wuxx/icesugar/doc/iCESugar_render.jpg

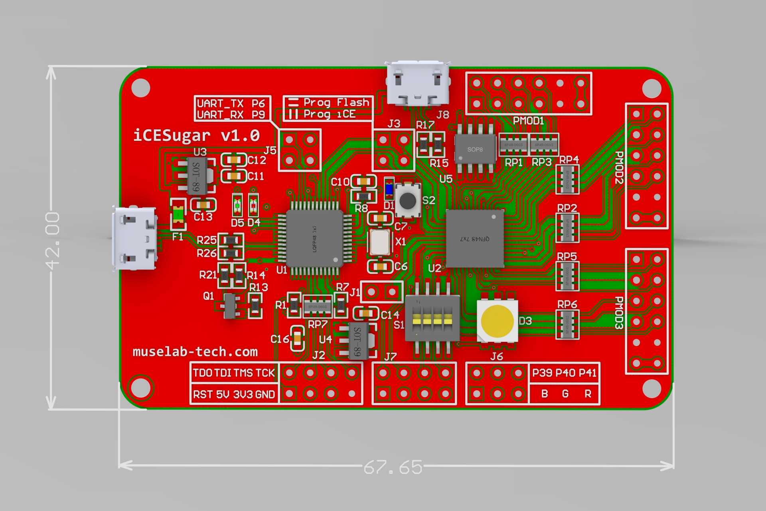
doc/iCESugar_render.jpg
