wuxx/icesugar/doc/icicle.png

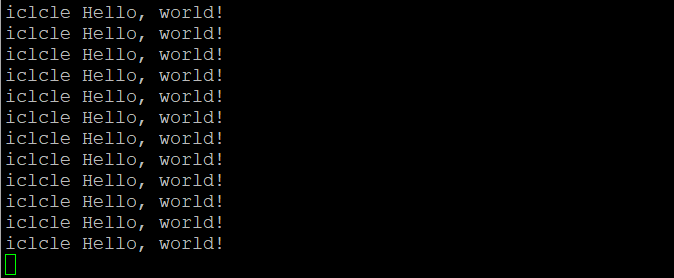
doc/icicle.png
