wuxx/icesugar/doc/litex-lm32-gateware.png

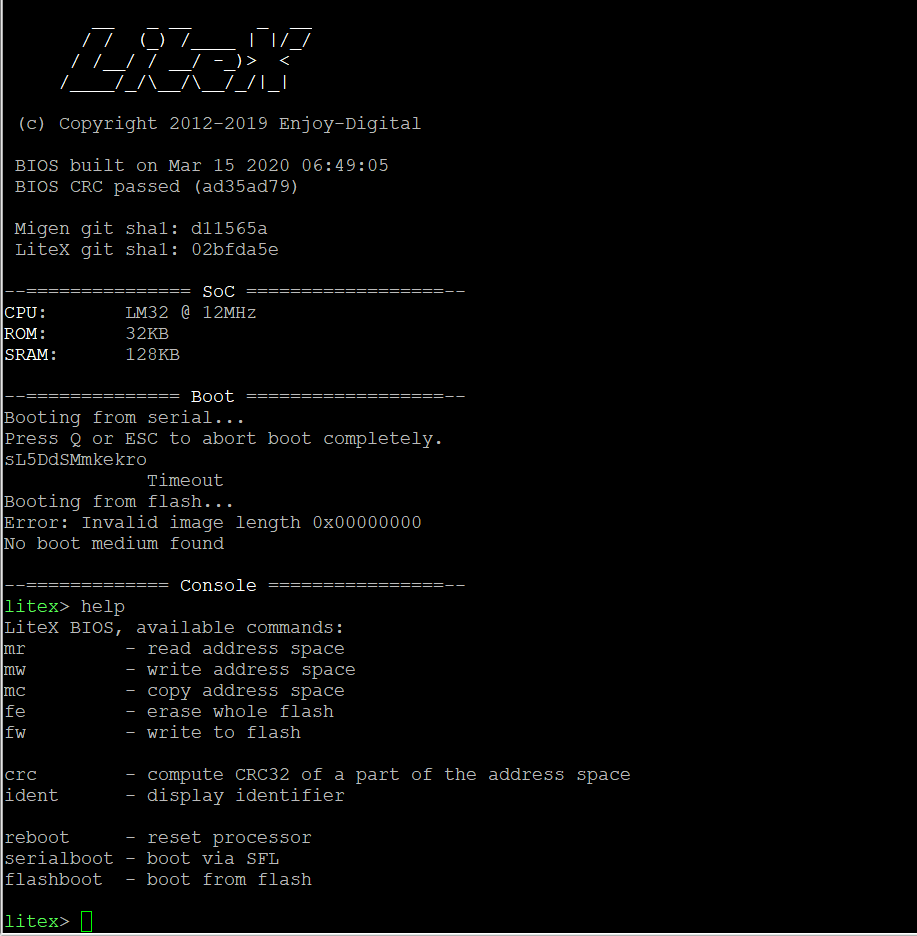
doc/litex-lm32-gateware.png
