wuxx/icesugar/doc/litex-lm32-micropython.png

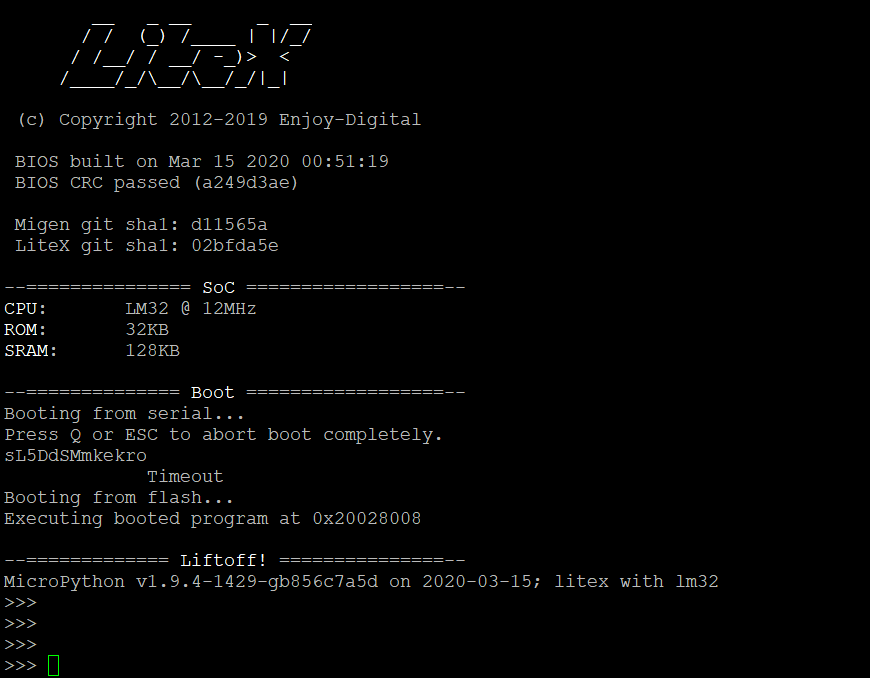
doc/litex-lm32-micropython.png
