wuxx/icesugar/doc/picosoc.png

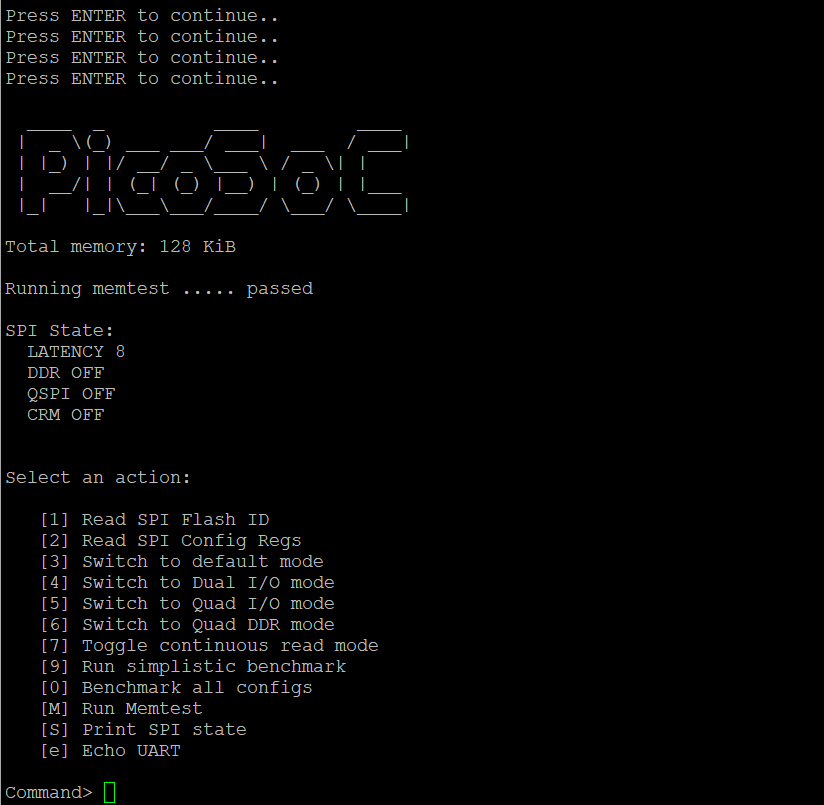
doc/picosoc.png
