wuxx/icesugar/doc/up5k_6502.jpg

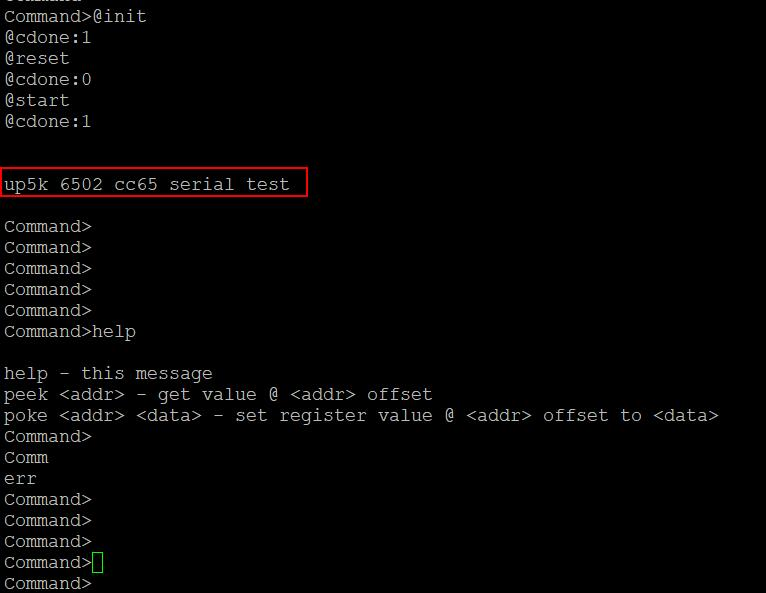
doc/up5k_6502.jpg
