wuxx/icesugar/src/basic/verilog/pmodoled2/fonts/oddball.png

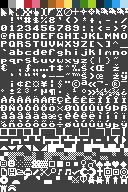
src/basic/verilog/pmodoled2/fonts/oddball.png
