wuxx/icesugar/(threads)

Thread 1 (2020-06-22):

请增加tftlcd的例子

zeaphoo, 2020-06-22:
demo 中有一个MuraxSoC_pmod_tftlcd的例子，可以跑。但是没有源代码。
希望能提供lcd相关例子和代码。

wuxx, 2020-06-22:
硬件源码在src/advanced/VexRiscv下
软件源码在https://github.com/wuxx/VexRiscvSocSoftware/tree/master/projects/murax/spi
具体运行请参考
https://zhuanlan.zhihu.com/p/133913104

zeaphoo, 2020-06-22:
那些代码是汇编和C的代码。这样也好吧。我本想看看有没有verilog的代码例子的。

wuxx, 2020-06-24:
后面会增加verilog的demo，请稍等

zeaphoo, 2020-06-24:
👍

wuxx, 2020-07-06:
已经增加硬件SPI的demo，是集成在SoC中的，可以参考学习
烧录demo/iceZ0mb1e_pmod_tftlcd.bin可进行测试。
源码： icesugar/src/advanced/iceZ0mb1e
编译方法：make firmware && make fpga && make flash

Closed 2020-07-07.

Thread 3 (2020-07-14):

any plan to support icestudio and apio?

jemisa, 2020-07-14:
It's' a visual editor for open FPGA boards, at https://github.com/FPGAwars/icestudio  (sample config for boards: https://github.com/FPGAwars/icestudio/tree/develop/app/resources/boards, need to create a folder and 3 config files, and generates pinout.json from pinout.pcf (I'm assuming src/common/io.pcf is the proper pinout  ) )

it relies on apio, a wrapper of other tools (
https://apiodoc.readthedocs.io/en/stable/source/contribute/support_new_board.html  explains how to add a board to apio

wuxx, 2020-07-15:
thanks for the advice, maybe support in future :)

jemisa, 2020-07-19:
Thanks.
I'm trying to do it myself.

I'm unclear on the difference between
icesprog leds.bin
and
cp leds.bin /media/mylogin/iCELink
Both do program

Can you explain what is the role of icesprog ?

wuxx, 2020-07-20:
there are two way to program, as you say, one is use icesprog, the other way is drag and drop, first one use usb hid to program. and the the latter use usb msc bulk to program.
drag and drop program speed is faster, because it use the usb bulk transfer.
and icesprog is multi-functional, it can probe/write/read the spi-flash.

jemisa, 2020-07-20:
Thank you for the answers.

Here is what I did to make it work for asio

STEP 1:
If you want to use icesprog,  put icesprog somehere in your path
add
 "icesprog": {                                                                                                                                     
     "command": "icesprog",                                                                                                                          
     "args": ""                                                                                                                                      
   },
to
apio/resources/programmers.json

if you prefer to use the usb method, you need to make a bash script and put in your path as icesugar-copy
#!/bin/bash
vars=( ` df | grep iCELink` )
ICELINK_DIR=${vars[5]}
cp "$1" "${ICELINK_DIR}"

but I found out that the directory is unmounted after one copy... so I prefer to use icesprog

STEP 2:
add
"icesugar-copy": {                                                                                                                                     
     "command": "icesugar-copy",                                                                                                                          
     "args": ""                                                                                                                                      
   },
to
apio/resources/programmers.json

then add
"icesugar": {                                                                                                                                     
     "name": "icesugar iCE40  by MuseLab",                                                                                                           
     "fpga": "iCE40-UP5K-SG48",                                                                                                                      
     "programmer": {                                                                                                                                 
       "type": "icesprog"                                                                                                                            
     },                                                                                                                                              
     "usb": {                                                                                                                                        
       "vid": "1d50",                                                                                                                                
       "pid": "602b"                                                                                                                                 
     }                                                                                                                                               
   }
to
apio/resources/boards.json
(if you prefer to use the icesugar-copy as programmer, change the "type" to be "icesugar-copy" (it should match the name in the programmers.json )

then install apio

to use:
cd src/basic/verilog/leds
cp the common/io.pcf in the current folder then
apio build --board icesugar
apio upload --board icesugar

aalku, 2020-10-11:
Thank you @jemisa
I made it work on Windows but don't know how to correctly prepare it to make it distributable and I didn't do the copy on Linux part yet.

My changes to apio are here
https://github.com/aalku/apio

And I created this issue in order to get help with it.
https://github.com/FPGAwars/apio/issues/214

Any help is welcome. This is a nice and cheap board and it would be nice to get it officially supported.

aalku, 2020-10-13:
Could you please release icesprog source or make a windows (libusbK?) binary so we can add it as apio programmer in a new toolchain?

the copy method does not support specifying an offset as far as I know.

wuxx, 2020-10-13:
yes, already commit under tools/src/

aalku, 2020-10-13:
Thank you! I'll try to create a windows binary with mingw. Wish me luck. 😂❤

aalku, 2020-10-13:
I had to make a couple of tiny changes but I made it work on windows.
I'm quite confident the c change is compatible with Linux but I don't know about hidapi-libusb being called just hidapi arround.

[icesprog-mingw64.zip](https://github.com/wuxx/icesugar/files/5373138/icesprog-mingw64.zip)

aalku, 2020-10-24:
@jemisa I've got apio toolchain here:
https://github.com/aalku/toolchain-icesprog/releases/tag/v1.0.0

apio fork supporting it here:
https://github.com/aalku/apio

I'm working with FPGAwars to include it on icestudio but I don't know when will it be working by default on nightly release or when the next stable release will be available. There are some steps ahead.

Obijuan, 2020-11-15:
The support of the icesugar in icestudio is almost finished! Thanks to @aalku  Here you can see an screenshot of a simple test circuit:

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

It is available in the develop branch. It is supported in Windows and Linux. The next step is add support for mac

jemisa, 2020-11-23:
https://mobile.twitter.com/Obijuan_cube/status/1330902188797939713 announces its support.
Thank @Obijuan and @aalku

Closed 2020-11-23.

Thread 4 (2020-07-19):

difference betwen icesprog and iceprog (from toolchain-ice40)

jemisa, 2020-07-19:
Hi

do you plan to publish the source code of icesprog ?

And can you explain what's the difference between icesprog and iceprog  from https://github.com/YosysHQ/icestorm/tree/master/iceprog ?

wuxx, 2020-07-20:
hello,
currently the source is closed, maybe opensource in future.
icesprog = icesugar prog
this difference is
iceprog use the ft2232 to program and icesprog use stm32f1 to program the spi-flash

Closed 2020-09-09.

Thread 5 (2020-07-22):

What's the relation with OpenFPGA-ICE ?

jemisa, 2020-07-22:
Hi
https://github.com/OpenFPGA-ICE looks quite similar to your github,
and uses the same icesprog.

How the 2 boards are related ?

wuxx, 2020-07-22:
hello, it seems that it's a another fpga board, it use ft2232hq to download (use the iceprog), the github repo seems just copy of my repo currently.

Closed 2020-09-09.

Thread 9 (2020-09-08):

Source code for ICELink

mamoit, 2020-09-08:
Is the source code for `ICELink` open?
I can find it anywhere.
If not, is it a "not yet", or no plans on open sourcing it?
It is a great tool, but I'm having some weird intermittent problems after dragging in a new program.

wuxx, 2020-09-09:
Hi，the souce code of iCELink will open in the future，and can you describe your problem in detail？

mamoit, 2020-12-14:
I am sorry for the radio silence, it was an issue with Kubuntu 18.04, that when the board reset the old mount was kept behind, making it quite messy after a couple of iterations.
With Kubuntu 20.04 this does not happen anymore, so I think the issue can be overlooked.

Did you release the iCELink source? Or you decided not to?
(not judging here, I understand completely if you opt by not releasing it)

wuxx, 2020-12-15:
iCELink source code currently has no open source plan, the firmware may be opened in future. :-)

camrbuss, 2020-12-31:
Is there any plan to add features such as adjustable ICELink clock output on PA8? Is it fixed at 12MHz?

wuxx, 2020-12-31:
the clock output will be able to adjust on iCESugar-nano board (base on ice40lp1k-cm36), because the lp1k-cm36 pll not support well by open source toolchain, current iCESugar seems not very necessary to have this feature ? it's pll can works well.
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

Closed 2020-12-14.

Thread 12 (2020-10-01):

UART access

aalku, 2020-10-01:
Hello. I am trying to use the RX and TX pins to communicate the computer with the FPGA but I see that pins are connected to iCElink UART3 and I'm not sure you can communicate with that UART through the USB-C or how to do it. Thank you.

wuxx, 2020-11-01:
when plug in PC, there is a USB CDC port, this CDC port is connected to pin-4 & pin-6 of FPGA

Closed 2020-11-01.

Thread 13 (2020-10-18):

1.5 schematic: Hard to see PMOD1 and UART are connected via J5

rvalles, 2020-10-18:
After some head-scratching, I realized the reason pin 4 seemed to be shorted high was that it's connected to STM32's UART TX via J5.

In the schematic, PMOD1 does clearly show how some of the pins are connected to the microusb port.

It would be better if it also shown that the relevant two pins are also connected to J5, in the same manner.

wuxx, 2020-12-15:
OK, Thanks for the good advice, later will update the schematic

WizardTim, 2021-09-07:
I agree, took me a few minutes to realize what was going on.

If there ends up being a V1.6 PCB it might be a good idea to highlight pins on the silkscreen that have multiple uses (USB, UART & J7/PMOD1 shared IO). Just using the invert option in Altium Designer should do the trick. Would suggest to users just starting out with it they should investigate PMOD1's IO further before using it.

Once I figured that out I loved using this dev board! The drag and drop programming is very convenient.

Thread 15 (2020-11-01):

The board is not working that keeps showing a "Fail.TXT"

ms0488638, 2020-11-01:
Hi, I just receive the board and try to use the demonstration bin file.

But every time I drag the bin file to the ICELINK in file explorer.

The board doesn't read the bin file, but showing a "FAIL.txt" file, which indicates the following lines:

error: The transfer timed out.
type: transient, user

What am I suppose to do?

wuxx, 2020-11-01:
Hello, did you change the short bridge, and which system you are in use?

wuxx, 2020-11-01:
and the default program in flash is the led blink, which ls flash by drag-n-drop before ship, can you see it ?

ms0488638, 2020-11-01:
> and the default program in flash is the led blink, which ls flash by drag-n-drop before ship, can you see it ?

Yap, the LED keeps blinking.

I am currently using the Windows 10 Professional Version.
I still am downloading the virtual environment from your link.

ms0488638, 2020-11-01:
> Hello, did you change the short bridge, and which system you are in use?

Should I modify any jumpers of the board?

wuxx, 2020-11-01:
no, just keep the default

wuxx, 2020-11-01:
and can you check the device manager to see if some driver is missing

ms0488638, 2020-11-01:
I just my linux laptop, and it can successfully upload.

Maybe I will check on my WIN10 desktop later, and find out which part went wrong.

wuxx, 2020-11-01:
OK

ms0488638, 2020-11-01:
I wonder if there is any available driver for the "iceLink" but the default one automatically installed by Windows?

wuxx, 2020-11-01:
there are 3 USB devices in iCELink, USB HID, USB CDC, and USB MSC, for win10 should no need to install any other drivers.

ms0488638, 2020-11-01:
This is weird, I've tried on 4 different computers.
Only my Linux laptop can successfully upload the bin file, while my windows computer may lead to Fail.txt.

Windows computer may occasionally success, but lead to fail.txt for most time.

If the bin file is successfully uploaded on windows computer, a explorer can show the transmission bar while the D4 and D5 LED can be observed blink.

wuxx, 2020-11-01:
eh... the factory led blink program was drag-n-drop with win10 too. can it may be the permission settings of you win10 ?
after program succ,  the iCELink disk will remount, you can see it displear and appear again some seconds later

wuxx, 2020-11-01:
and how you drag the bitstream ? I usually open the iCELink folder and drag the bitstream into the disk. or can use ctrl-c ctrl-v too.

ms0488638, 2020-11-01:
Hey, I think I found the reason.

After I change to another Type-C-to-USB-A, all issues are gone.

I guess something goes wrong with the attached one.

Problem might be fixed, thanks in advance.

wuxx, 2020-11-02:
ok

Closed 2020-11-02.

Thread 20 (2020-12-05):

icesprog is available in official MSYS2 repositories

umarcor, 2020-12-05:
During the last weeks, some PRs were proposed with regard to building and packaging icesprog (#16, #17, #18, #19).
I'm glad to tell that icesprog is now available in official MSYS2 repositories:

- https://github.com/msys2/MINGW-packages/tree/master/mingw-w64-icesprog
- https://packages.msys2.org/package/mingw-w64-i686-icesprog
- https://packages.msys2.org/package/mingw-w64-x86_64-icesprog

Therefore, users on Windows can install icesprog through `pacman -S mingw-w64-x86_64-icesprog` (64 bits) or `pacman -S mingw-w64-i686-icesprog` (32 bits); and they are ready to go!

```sh
user@DESKTOP MINGW64 /d/icesugar/demo
$ icesprog -w leds.bin
flash offset: 0x00000000
write flash (104090 (0x1969a) Bytes)
write 0x00000000
write 0x00010000
done
```

/cc @juanmard

wuxx, 2020-12-05:
great  job, huge thanks !!

umarcor, 2020-12-12:
A couple of days ago, icesprog was added to a package group named 'eda'. That allows installing it together with other related tools. See https://packages.msys2.org/group/mingw-w64-x86_64-eda and https://github.com/hdl/MINGW-packages#usage.

Thread 21 (2020-12-14):

Is there a 'full pack' available including the ICESugar and several PMODs?

umarcor, 2020-12-14:
I'm looking into buying an ICESugar along with multiple PMOD peripherals. However, I didn't find any pack including more than a single PMOD.

| ICESugar    | 29.54€ |   Pack  |  Alone  |
|---|---|---|---|
| PMOD-VGA    | 36.30€ |  +6.76€ |   9.12€ |
| PMOD-LED    | 33.76€ |  +4.22€ |   6.59€ |
| PMOD-SWITCH | 33.76€ |  +4.22€ |   6.59€ |
| PMOD-AUDIO  | 35.45€ |  +5.91€ |   8.28€ |
| PMOD-TFTLCD | 37.98€ |  +8.44€ |  10.81€ |
| PMOD-RGBLCD | -      |  -      |  19.25€ (8.27€ w/o screen) |
|             |        | +29.55€ |  60.64€ (49.66€ w/o RGB screen) |

Buying PMOD parts alone is ~2.36€ more expensive that buying one of them together with the board. I don't know whether that's an offer as a pack, or due to shipping.

The only option to get a "full pack" seems to be:

- (ICESugar + PMOD-LED) + PMOD-VGA + PMOD-SWITCH + PMOD-AUDIO + PMOD-TFTLCD + PMOD-RGBLCD = 87.81€
- or 76.83€ w/o RGB screen
- or 68.56€ w/o PMOD-RGBLCD
- or 77.00€ w/o PMOD-TFTLCD

Is that correct? Will everything be shipped together?

wuxx, 2020-12-14:
here the alone address of PMOD-LED
https://www.aliexpress.com/item/1005001504777342.html?spm=2114.12010615.8148356.1.68dc552e6pxQFe
the shipping fee is caclate as $2.8.
and we have two LCD: PMOD-TFTLCD (2.8 inch with spi interface); PMOD-RGBLCD (4.3 inch with rgb parallel interface)
the full pack will on stock soon, please wait... about some hours ? :-)

umarcor, 2020-12-14:
That was so fast! Thanks for the link and for letting me know about PMOD-RGBLCD (I had overlooked that!). I updated the table above.

> the full pack will on stock soon, please wait... about some hours ? :-)

Or some days. No rush at all. Take it easy ;)

wuxx, 2020-12-18:
the full pack is already available on stock :-)

Closed 2021-06-17.

Thread 22 (2020-12-14):

What is the purpose of J7?

umarcor, 2020-12-14:
Comparing the schematics of v1.4 and v1.5, I found the difference to be the addition of J7, which seems to duplicate 4 of the pins in PMOD1:

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

The [render](https://raw.githubusercontent.com/wuxx/icesugar/master/doc/iCESugar_render.jpg) and [photo](https://raw.githubusercontent.com/wuxx/icesugar/master/doc/iCESugar.jpg) of v1.0 and v1.3, respectively, show that J7 was not there before. Comparing to a [photo of v1.5](https://raw.githubusercontent.com/wuxx/icesugar/master/doc/iCESugar_1.jpg) it looks like the distance between PMOD2 and PMOD3 was increased.

My understanding is that J7 was added for PMOD-RGBLCD, which has 30 pins (2x15). Hence a female angled 2x3P connector such as the following needs to be soldered in J7 for using PMOD-RGBLCD:

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

I assume that the spacing between PMOD connectors in PMOD-VGA and PMOD-TFTLCD matches the "new" separation in the v1.5 board design, and not the previous. With regard to the [PMOD specification](https://github.com/wuxx/icesugar/blob/master/doc/pmod-interface-specification-1_2_0.pdf) it seems that v1.5 complies with the separation between PMODs (22.86mm or 0.90"). Therefore, "standard" peripherals with two PMODs can be connected to the ICESugar now. Say, [Pmod SSD](https://store.digilentinc.com/pmod-ssd-seven-segment-display/) or [Pmod motor driver](https://shop.trenz-electronic.de/en/TEP0002-02-Pmod-compatible-motor-driver-board-15A-0-30V?c=375). By the same token, the PMOD-VGA and PMOD-TFTLCD of Muse Lab Factory Store can be used with any other board providing two properly spaced PMODs. Is this correct?

wuxx, 2020-12-15:
yes, the distance of v1.5 is obey the specification, you can use other standard PMOD peripherals.
and the J7 is expose 4 more GPIO and 5V power supply, it's suit for PMOD-RGBLCD with rgb565 color.
a bad news:  you can not solder the 2x3P connector between two 2x6P pmod, it will get stuck.
so when somebody buy the pmod-rgblcd, we will send board with 2x15p connector like this.
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

umarcor, 2020-12-18:
Thanks! That makes sense...

Does the PMOD-RGBLCD module depend on some of the signals in the 2x15 connector being differential pairs? Or are all pins used as general purpose I/O?

It seems that the 5V in the RGBLCD are used for the backlight only. I.e., all signals are 3V3. Is that correct?

wuxx, 2020-12-18:
yes, the more 4 IO is perfect for rgb lcd with rgb565, check this demo for the detail
https://github.com/wuxx/icesugar/tree/master/src/basic/verilog/rgblcd
5V for the backlight (boost to about 18V), the IO is 3.3V.

Closed 2020-12-18.

Thread 24 (2021-01-09):

Directly configuring iCE40 in slave mode.

EliteTK, 2021-01-09:
The "||" (prog iCE) jumper configuration allows the iCElink to configure the iCE40 in slave mode but there's no such option in icesprog. How would I go about having the iCElink directly configure the iCE40?

As a side note, the way the schematic names the busses is a bit confusing, I think ICE_MISO should really be called ICE_SO since it can operate in master and slave mode, same with ICE_MOSI (-> ICE_SI) this would make the schematic a lot clearer especially when in the default configuration (with the jumpers in "=" mode) ICE_MISO actually acts as ICE_MOSI and vice versa (the iCE40 is the bus master during the configuration).

wuxx, 2021-01-10:
when jump to "prog iCE", the spi-flash is bypass, the iCE40UP5k act as a spi slave device. this means we program the bitstream into internal SRAM of iCE40UP5k, and when system restart, the bitstream will disappear. currently this feature is not inplement yet. I think it's not a very important issue, some hardware design directly not allow to program to SRAM.

agree with your good advice, later will try to improve the schematic. :-)

wuxx, 2021-01-10:
if somebody really need this feature, may consider implement it in next version

EliteTK, 2021-01-11:
If there is already a command which can be sent over HID to the iCELink to do this then it would be enough to document it. I am already writing my own implementation of the icesprog tool (I wanted to clean it up and ended up re-writing it) and the way it is written would make it quite easy for me to add this feature.

JanDupal, 2021-04-05:
Same here – I've spent some time into digging how to enable SRAM configuration in icesprog before I had found this thread. It's not 100 % must-have, but having the option to do SRAM configuration would be great.

Thread 28 (2021-06-06):

Question: Is there a USB PHY for the microUSB?

erlingrj, 2021-06-06:
Hi, and thanks for an awesome project. I have purchased an IceSugar FPGA board but have a question about the microUSB port. From inspecting the schematics it seems as if the D+ an D- pins are *directly* connected to IOB_18A and IOB_16A on the Lattice ICE40. I am not experienced in this domain, but I would have expected a USB PHY chip to be connected to the microUSB connector and a serial RX/TX interface of the USB PHY connected to the FPGA.

Am I missing something here?

Again, thanks for a cool project, I am looking forward to using your board.
- Erling

wuxx, 2021-06-06:
Hello, the USB IO is just two normal GPIO, the USB 2.0 full speed  clk is only 6MHz, it's easy implement by fpga (even some MCU GPIOs, the software USB), you can check the demo code under advanced directory

erlingrj, 2021-06-07:
Thanks for your quick reply. I will check out the advanced directory. I found a guy that implements the USB stack at [TinyFPGA-Bootlaoder](https://github.com/tinyfpga/TinyFPGA-Bootloader), but that only implements the USB device endpoint, I need a host endpoint. But I will dig further, or I might just use a MCU with a USB Phy to act as a USB host. Anyways, thanks for your help. I will close the issue now.

Closed 2021-06-07.

Thread 29 (2021-06-16):

What use really has the jumper J1?

juanmard, 2021-06-16:
Pin 35 from FPGA is an output from internal PLL (ICE_CLK), so is an input on microcontroller STM32 (as a clock?).
Why need a jumper here? What is it used for?

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

wuxx, 2021-06-17:
the MCU output 12MHz clock to iCE40 as external clock, but if you need other frequence, you can take off the jumper and connect your specified clock source.

juanmard, 2021-06-17:
Thanks!

Closed 2021-06-17.

Thread 30 (2021-06-17):

Drag&Drop fail with multi-image.

juanmard, 2021-06-17:
When you use a packet bitstream generated with **_icemulti_** and use a Drag&Drop _iCELink_ feature, always fail with a _time out_ error.

```
$ icemulti -v -p0 pwm.bin picorv32.bin leds.bin pll.bin -o icemulti_test.bin
Place image 0 at 0000a0 .. 01973a (`pwm.bin')
Place image 1 at 01973a .. 11b176 (`picorv32.bin')
Place image 2 at 11b176 .. 134810 (`leds.bin')
Place image 3 at 134810 .. 14deaa (`pll.bin')
```
Drag&Drop file _icemulti_test.bin_ and get this FAIL file:

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

wuxx, 2021-06-18:
what's the function of icemulti ? is it just conbine these bin file into a whole one image, like the cat command?
when drag-n-drop program, the on-board iCELink will check the file format, check the link here for detail
http://www.clifford.at/icestorm/format.html

juanmard, 2021-06-18:
Yes, **icemulti** is: _"IceMulti: A tool for packing multiple bitstream files into one iCE40 multiboot image file."_
http://www.clifford.at/icestorm (see icestorm tools)
or code https://github.com/YosysHQ/icestorm/blob/master/icemulti/icemulti.cc

Used to multiple _bitstream_: https://www.latticesemi.com/view_document?document_id=46502 (Chapter 10)
Not exactly like the cat command, because it include at the begining an «applet zone» with information about four _bitstreams_.

We would need to jump this applet to verify the format of the file and let it pass.

wuxx, 2021-06-18:
drag-n-drop need the file start with FF 00 00 FF, so it may only support program a single bitstream file, recommend to use the icesprog to program the multiboot image file

juanmard, 2021-06-18:
Ok, thank you.

Closed 2021-09-07.

Thread 32 (2021-06-19):

Support for Lattice downloader environment

lanczki, 2021-06-19:
It would be greate if the board could support the Lattice environment in a newer version.

What I'd like to propose is the following.
The board should include a header where the iCE40 SPI pins and the CRESET_B pin are routed out.
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

Or just the CRESET_B,ICE_SS,ICE_SCK should need a header because the ICE_MOSI and ICE_MISO are already routed out to J3
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

wuxx, 2021-07-07:
OK, will consider it later, thanks for you good advice~!

lanczki, 2021-07-13:
Thanks :) Keep up the good work.

Closed 2021-07-13.

Thread 40 (2021-09-24):

make gateware failed

fatalfeel, 2021-09-24:
export PLATFORM=ice40_up5k_b_evn
export TARGET=base
export CPU=vexriscv
export CPU_VARIANT=linux
export FIRMWARE=linux

wget https://raw.githubusercontent.com/enjoy-digital/litex/master/litex_setup.py
chmod +x ./litex_setup.py
./litex_setup.py init install --user

./scripts/debian-setup.sh
./scripts/download-env.sh

source ./scripts/enter-env.sh
make gateware

~~~~~~~~~~~~~~~~~~
#error

mkdir -p build/ice40_up5k_b_evn_base_vexriscv.linux/
time python -u ./make.py --platform=ice40_up5k_b_evn --target=base --cpu-type=vexriscv --iprange=192.168.100   --cpu-variant=linux --cpu-variant=linux  \
	2>&1 | tee -a /root/icesugar/icesugar/src/advanced/litex-buildenv/build/ice40_up5k_b_evn_base_vexriscv.linux//output.20210925-052953.log; (exit ${PIPESTATUS[0]})
Compat: SoCSDRAM is deprecated since 2020-03-24 and will soon no longer work, please update. Switch to SoCCore/add_sdram/soc_core_args instead...........thanks :)

Traceback (most recent call last):
  File "./make.py", line 169, in <module>
    main()
  File "./make.py", line 123, in main
    soc = get_soc(args, platform)
  File "./make.py", line 57, in get_soc
    soc = SoC(platform, ident=SoC.__name__, **soc_sdram_argdict(args), **dict(args.target_option))
  File "/root/icesugar/icesugar/src/advanced/litex-buildenv/targets/ice40_up5k_b_evn/base.py", line 105, in __init__
    type="cached+linker")
  File "/root/icesugar/icesugar/src/advanced/litex/litex/soc/integration/soc_core.py", line 252, in add_memory_region
    linker="linker" in type))
  File "/root/icesugar/icesugar/src/advanced/litex/litex/soc/integration/soc.py", line 166, in add_region
    raise
RuntimeError: No active exception to reraise

/////////////////////
run bootstrap.sh

ompiler_rt'...
fatal: \u7248\u672c\u5eab 'https://git.llvm.org/git/compiler-rt/' \u672a\u627e\u5230
fatal: \u7121\u6cd5\u8907\u88fd 'https://git.llvm.org/git/compiler-rt' \u5230\u5b50\u6a21\u7d44\u8def\u5f91 '/root/icesugar/icesugar/src/advanced/litex-buildenv/third_party/litex/litex/soc/software/compiler_rt'
\u8907\u88fd 'litex/soc/software/compiler_rt' \u5931\u6557\u3002\u5df2\u6392\u7a0b\u91cd\u8a66\u4f5c\u696d
\u6b63\u8907\u88fd\u5230 '/root/icesugar/icesugar/src/advanced/litex-buildenv/third_party/litex/litex/soc/software/compiler_rt'...
fatal: \u7248\u672c\u5eab 'https://git.llvm.org/git/compiler-rt/' \u672a\u627e\u5230
fatal: \u7121\u6cd5\u8907\u88fd 'https://git.llvm.org/git/compiler-rt' \u5230\u5b50\u6a21\u7d44\u8def\u5f91 '/root/icesugar/icesugar/src/advanced/litex-buildenv/third_party/litex/litex/soc/software/compiler_rt'
\u7b2c\u4e8c\u6b21\u5617\u8a66\u8907\u88fd 'litex/soc/software/compiler_rt' \u5931\u6557\uff0c\u4e2d\u6b62\u4f5c\u696d
fatal: \u7121\u6cd5\u905e\u8ff4\u9032\u5b50\u6a21\u7d44\u8def\u5f91 'third_party/litex'
////////////////////
by the way way can ice40_up5k_b_evn success run simple linux or zepyhr?

fatalfeel, 2021-09-25:
fix a lot on firmware section
http://fatalfeel.blogspot.com/2021/09/risc-v-on-icesugar.html

///THE success message//
Info: Device utilisation:
Info: 	         ICESTORM_LC:  3074/ 5280    58%
Info: 	        ICESTORM_RAM:     6/   30    20%
Info: 	               SB_IO:    16/   96    16%
Info: 	               SB_GB:     8/    8   100%
Info: 	        ICESTORM_PLL:     0/    1     0%
Info: 	         SB_WARMBOOT:     0/    1     0%
Info: 	        ICESTORM_DSP:     0/    8     0%
Info: 	      ICESTORM_HFOSC:     0/    1     0%
Info: 	      ICESTORM_LFOSC:     0/    1     0%
Info: 	              SB_I2C:     0/    2     0%
Info: 	              SB_SPI:     0/    2     0%
Info: 	              IO_I3C:     0/    2     0%
Info: 	         SB_LEDDA_IP:     0/    1     0%
Info: 	         SB_RGBA_DRV:     0/    1     0%
Info: 	      ICESTORM_SPRAM:     4/    4   100%

Info: Placed 16 cells based on constraints.
Info: Creating initial analytic placement for 2786 cells, random placement wirelen = 77459.
Info:     at initial placer iter 0, wirelen = 874
Info:     at initial placer iter 1, wirelen = 766
Info:     at initial placer iter 2, wirelen = 760
Info:     at initial placer iter 3, wirelen = 763
Info: Running main analytical placer.
Info:     at iteration #1, type ALL: wirelen solved = 761, spread = 26631, legal = 34370; time = 0.15s
Info:     at iteration #2, type ALL: wirelen solved = 1105, spread = 20102, legal = 28226; time = 0.14s
Info:     at iteration #3, type ALL: wirelen solved = 1852, spread = 19291, legal = 28088; time = 0.12s
Info:     at iteration #4, type ALL: wirelen solved = 2563, spread = 18455, legal = 24775; time = 0.09s
Info:     at iteration #5, type ALL: wirelen solved = 3250, spread = 19084, legal = 24482; time = 0.09s
Info:     at iteration #6, type ALL: wirelen solved = 3678, spread = 18857, legal = 23250; time = 0.08s
Info:     at iteration #7, type ALL: wirelen solved = 5042, spread = 18204, legal = 23880; time = 0.09s
Info:     at iteration #8, type ALL: wirelen solved = 5492, spread = 17621, legal = 22718; time = 0.08s
Info:     at iteration #9, type ALL: wirelen solved = 6374, spread = 17141, legal = 22955; time = 0.08s
Info:     at iteration #10, type ALL: wirelen solved = 7123, spread = 16729, legal = 22393; time = 0.08s
Info:     at iteration #11, type ALL: wirelen solved = 7465, spread = 16548, legal = 21997; time = 0.08s
Info:     at iteration #12, type ALL: wirelen solved = 7917, spread = 16659, legal = 21537; time = 0.08s
Info:     at iteration #13, type ALL: wirelen solved = 8503, spread = 16622, legal = 21403; time = 0.08s
Info:     at iteration #14, type ALL: wirelen solved = 8936, spread = 16175, legal = 20985; time = 0.07s
Info:     at iteration #15, type ALL: wirelen solved = 9222, spread = 16264, legal = 20761; time = 0.08s
Info:     at iteration #16, type ALL: wirelen solved = 9645, spread = 16344, legal = 20809; time = 0.07s
Info:     at iteration #17, type ALL: wirelen solved = 10037, spread = 16213, legal = 20612; time = 0.07s
Info:     at iteration #18, type ALL: wirelen solved = 10246, spread = 15945, legal = 19911; time = 0.07s
Info:     at iteration #19, type ALL: wirelen solved = 10304, spread = 15819, legal = 20343; time = 0.07s
Info:     at iteration #20, type ALL: wirelen solved = 10618, spread = 15842, legal = 20130; time = 0.07s
Info:     at iteration #21, type ALL: wirelen solved = 10625, spread = 15743, legal = 20424; time = 0.07s
Info:     at iteration #22, type ALL: wirelen solved = 10737, spread = 15775, legal = 20490; time = 0.07s
Info:     at iteration #23, type ALL: wirelen solved = 10834, spread = 15662, legal = 20538; time = 0.07s
Info: HeAP Placer Time: 2.50s
Info:   of which solving equations: 1.07s
Info:   of which spreading cells: 0.25s
Info:   of which strict legalisation: 0.74s

Info: Running simulated annealing placer for refinement.
Info:   at iteration #1: temp = 0.000000, timing cost = 728, wirelen = 19911
Info:   at iteration #5: temp = 0.000000, timing cost = 698, wirelen = 17127
Info:   at iteration #10: temp = 0.000000, timing cost = 740, wirelen = 16263
Info:   at iteration #15: temp = 0.000000, timing cost = 731, wirelen = 15822
Info:   at iteration #20: temp = 0.000000, timing cost = 720, wirelen = 15524
Info:   at iteration #25: temp = 0.000000, timing cost = 716, wirelen = 15470
Info:   at iteration #27: temp = 0.000000, timing cost = 714, wirelen = 15465
Info: SA placement time 3.45s

Info: Max frequency for clock 'clk12$SB_IO_IN_$glb_clk': 22.55 MHz (PASS at 12.00 MHz)

Info: Max delay <async>                         -> posedge clk12$SB_IO_IN_$glb_clk: 10.37 ns
Info: Max delay posedge clk12$SB_IO_IN_$glb_clk -> <async>                        : 11.57 ns

Info: Slack histogram:
Info:  legend: * represents 10 endpoint(s)
Info:          + represents [1,10) endpoint(s)
Info: [ 38991,  41079) |*****+
Info: [ 41079,  43167) |****************+
Info: [ 43167,  45255) |****************+
Info: [ 45255,  47343) |*****+
Info: [ 47343,  49431) |**+
Info: [ 49431,  51519) |****+
Info: [ 51519,  53607) |***************+
Info: [ 53607,  55695) |****************+
Info: [ 55695,  57783) |*******+
Info: [ 57783,  59871) |****************+
Info: [ 59871,  61959) |*********************+
Info: [ 61959,  64047) |*******************************+
Info: [ 64047,  66135) |****************************************+
Info: [ 66135,  68223) |*************************+
Info: [ 68223,  70311) |*********************+
Info: [ 70311,  72399) |************************
Info: [ 72399,  74487) |******************+
Info: [ 74487,  76575) |*********************+
Info: [ 76575,  78663) |************************************************************
Info: [ 78663,  80751) |************************************+
Info: Checksum: 0xc3080f4b

Info: Routing..
Info: Setting up routing queue.
Info: Routing 9668 arcs.
Info:            |   (re-)routed arcs  |   delta    | remaining
Info:    IterCnt |  w/ripup   wo/ripup |  w/r  wo/r |      arcs
Info:       1000 |       13        986 |   13   986 |      8682
Info:       2000 |       81       1918 |   68   932 |      7756
Info:       3000 |      155       2844 |   74   926 |      6850
Info:       4000 |      264       3735 |  109   891 |      6045
Info:       5000 |      384       4615 |  120   880 |      5209
Info:       6000 |      541       5458 |  157   843 |      4463
Info:       7000 |      815       6184 |  274   726 |      3867
Info:       8000 |     1143       6856 |  328   672 |      3378
Info:       9000 |     1588       7411 |  445   555 |      3006
Info:      10000 |     2028       7971 |  440   560 |      2747
Info:      11000 |     2488       8511 |  460   540 |      2548
Info:      12000 |     2875       9124 |  387   613 |      2150
Info:      13000 |     3361       9638 |  486   514 |      2017
Info:      14000 |     3807      10192 |  446   554 |      1737
Info:      15000 |     4331      10668 |  524   476 |      1654
Info:      16000 |     4843      11156 |  512   488 |      1570
Info:      17000 |     5295      11704 |  452   548 |      1375
Info:      18000 |     5786      12213 |  491   509 |      1168
Info:      19000 |     6261      12738 |  475   525 |       923
Info:      20000 |     6576      13423 |  315   685 |       441
Info:      20748 |     6728      14020 |  152   597 |         0
Info: Routing complete.
Info: Route time 8.78s
Info: Checksum: 0x98f344cf

Info: Critical path report for clock 'clk12$SB_IO_IN_$glb_clk' (posedge -> posedge):
Info: curr total
Info:  1.4  1.4  Source VexRiscv.decode_to_execute_SRC2_CTRL_SB_DFFE_Q_1_DFFLC.O
Info:  1.8  3.2    Net VexRiscv._zz_execute_SRC2_CTRL[0] budget 3.114000 ns (12,14) -> (12,13)
Info:                Sink VexRiscv._zz_execute_SrcPlugin_addSub_3_SB_LUT4_O_31_I3_SB_LUT4_O_I1_SB_LUT4_O_LC.I0
Info:  1.3  4.4  Source VexRiscv._zz_execute_SrcPlugin_addSub_3_SB_LUT4_O_31_I3_SB_LUT4_O_I1_SB_LUT4_O_LC.O
Info:  1.8  6.2    Net VexRiscv._zz_execute_SrcPlugin_addSub_3_SB_LUT4_O_31_I3_SB_LUT4_O_I1 budget 2.894000 ns (12,13) -> (11,13)
Info:                Sink VexRiscv._zz_execute_SrcPlugin_addSub_3_SB_LUT4_O_31_I3_SB_LUT4_O_LC.I1
Info:  1.2  7.4  Source VexRiscv._zz_execute_SrcPlugin_addSub_3_SB_LUT4_O_31_I3_SB_LUT4_O_LC.O
Info:  4.1 11.6    Net VexRiscv._zz_execute_SrcPlugin_addSub_3_SB_LUT4_O_31_I3 budget 3.114000 ns (11,13) -> (10,21)
Info:                Sink VexRiscv._zz_execute_SrcPlugin_addSub_3_SB_LUT4_O_31_LC.I3
Info:  0.9 12.4  Source VexRiscv._zz_execute_SrcPlugin_addSub_3_SB_LUT4_O_31_LC.O
Info:  1.8 14.2    Net VexRiscv._zz_execute_SrcPlugin_addSub_3[0] budget 3.114000 ns (10,21) -> (10,22)
Info:                Sink VexRiscv.dBus_cmd_payload_address_SB_LUT4_O_30_LC.I2
Info:  0.6 14.8  Source VexRiscv.dBus_cmd_payload_address_SB_LUT4_O_30_LC.COUT
Info:  0.7 15.5    Net VexRiscv.decode_to_execute_SRC_USE_SUB_LESS_SB_CARRY_I0_CO[1] budget 0.660000 ns (10,22) -> (10,22)
Info:                Sink VexRiscv.dBus_cmd_payload_address_SB_LUT4_O_19_LC.I3
Info:  0.9 16.4  Source VexRiscv.dBus_cmd_payload_address_SB_LUT4_O_19_LC.O
Info:  3.1 19.4    Net VexRiscv.dBus_cmd_payload_address[1] budget 3.114000 ns (10,22) -> (9,16)
Info:                Sink VexRiscv.execute_ALIGNEMENT_FAULT_SB_LUT4_O_LC.I3
Info:  0.9 20.3  Source VexRiscv.execute_ALIGNEMENT_FAULT_SB_LUT4_O_LC.O
Info:  1.8 22.0    Net VexRiscv.execute_ALIGNEMENT_FAULT budget 3.114000 ns (9,16) -> (8,15)
Info:                Sink VexRiscv.execute_ALIGNEMENT_FAULT_SB_LUT4_I3_LC.I3
Info:  0.9 22.9  Source VexRiscv.execute_ALIGNEMENT_FAULT_SB_LUT4_I3_LC.O
Info:  1.8 24.7    Net VexRiscv.execute_ALIGNEMENT_FAULT_SB_LUT4_I3_O budget 3.114000 ns (8,15) -> (8,15)
Info:                Sink VexRiscv.execute_ALIGNEMENT_FAULT_SB_LUT4_I3_O_SB_LUT4_I3_LC.I3
Info:  0.9 25.6  Source VexRiscv.execute_ALIGNEMENT_FAULT_SB_LUT4_I3_O_SB_LUT4_I3_LC.O
Info:  1.8 27.3    Net VexRiscv.execute_ALIGNEMENT_FAULT_SB_LUT4_I3_O_SB_LUT4_I3_O budget 3.114000 ns (8,15) -> (8,14)
Info:                Sink VexRiscv.dBus_cmd_rData_wr_SB_LUT4_I2_1_O_SB_LUT4_I0_LC.I1
Info:  1.2 28.5  Source VexRiscv.dBus_cmd_rData_wr_SB_LUT4_I2_1_O_SB_LUT4_I0_LC.O
Info:  3.0 31.5    Net VexRiscv.dBus_cmd_rData_wr_SB_LUT4_I2_1_O_SB_LUT4_I0_O budget 3.113000 ns (8,14) -> (5,12)
Info:                Sink VexRiscv._zz_IBusSimplePlugin_iBusRsp_stages_0_output_ready_2_SB_LUT4_I0_O_SB_LUT4_I1_LC.I3
Info:  0.9 32.4  Source VexRiscv._zz_IBusSimplePlugin_iBusRsp_stages_0_output_ready_2_SB_LUT4_I0_O_SB_LUT4_I1_LC.O
Info:  1.8 34.1    Net VexRiscv._zz_IBusSimplePlugin_iBusRsp_stages_0_output_ready_2_SB_LUT4_I0_O_SB_LUT4_I1_O budget 3.113000 ns (5,12) -> (4,12)
Info:                Sink VexRiscv.IBusSimplePlugin_rspJoin_rspBuffer_discardCounter_SB_DFFSR_Q_2_D_SB_LUT4_O_I3_SB_LUT4_O_I2_SB_LUT4_O_LC.I3
Info:  0.9 35.0  Source VexRiscv.IBusSimplePlugin_rspJoin_rspBuffer_discardCounter_SB_DFFSR_Q_2_D_SB_LUT4_O_I3_SB_LUT4_O_I2_SB_LUT4_O_LC.O
Info:  1.8 36.8    Net VexRiscv.IBusSimplePlugin_rspJoin_rspBuffer_discardCounter_SB_DFFSR_Q_2_D_SB_LUT4_O_I3_SB_LUT4_O_I2 budget 3.113000 ns (4,12) -> (4,12)
Info:                Sink VexRiscv.IBusSimplePlugin_rspJoin_rspBuffer_discardCounter_SB_DFFSR_Q_2_D_SB_LUT4_O_I3_SB_LUT4_O_I2_SB_CARRY_I1$CARRY.I2
Info:  0.6 37.4  Source VexRiscv.IBusSimplePlugin_rspJoin_rspBuffer_discardCounter_SB_DFFSR_Q_2_D_SB_LUT4_O_I3_SB_LUT4_O_I2_SB_CARRY_I1$CARRY.COUT
Info:  0.0 37.4    Net VexRiscv.IBusSimplePlugin_rspJoin_rspBuffer_discardCounter_SB_DFFSR_Q_2_D_SB_LUT4_O_I3_SB_LUT4_O_I2_SB_CARRY_I1_CO[1] budget 0.000000 ns (4,12) -> (4,12)
Info:                Sink VexRiscv.IBusSimplePlugin_rspJoin_rspBuffer_discardCounter_SB_DFFSR_Q_1_D_SB_LUT4_O_I3_SB_LUT4_O_LC.CIN
Info:  0.3 37.7  Source VexRiscv.IBusSimplePlugin_rspJoin_rspBuffer_discardCounter_SB_DFFSR_Q_1_D_SB_LUT4_O_I3_SB_LUT4_O_LC.COUT
Info:  0.7 38.3    Net VexRiscv.IBusSimplePlugin_rspJoin_rspBuffer_discardCounter_SB_DFFSR_Q_2_D_SB_LUT4_O_I3_SB_LUT4_O_I2_SB_CARRY_I1_CO[2] budget 0.660000 ns (4,12) -> (4,12)
Info:                Sink VexRiscv.IBusSimplePlugin_rspJoin_rspBuffer_discardCounter_SB_DFFSR_Q_D_SB_LUT4_O_I2_SB_LUT4_O_LC.I3
Info:  0.9 39.2  Source VexRiscv.IBusSimplePlugin_rspJoin_rspBuffer_discardCounter_SB_DFFSR_Q_D_SB_LUT4_O_I2_SB_LUT4_O_LC.O
Info:  1.8 40.9    Net VexRiscv.IBusSimplePlugin_rspJoin_rspBuffer_discardCounter_SB_DFFSR_Q_D_SB_LUT4_O_I2 budget 14.214000 ns (4,12) -> (4,11)
Info:                Sink VexRiscv.IBusSimplePlugin_rspJoin_rspBuffer_discardCounter_SB_DFFSR_Q_D_SB_LUT4_O_LC.I2
Info:  1.2 42.1  Setup VexRiscv.IBusSimplePlugin_rspJoin_rspBuffer_discardCounter_SB_DFFSR_Q_D_SB_LUT4_O_LC.I2
Info: 14.8 ns logic, 27.3 ns routing

Info: Critical path report for cross-domain path '<async>' -> 'posedge clk12$SB_IO_IN_$glb_clk':
Info: curr total
Info:  0.0  0.0  Source spiflash_miso$sb_io.D_IN_0
Info:  6.4  6.4    Net spiflash_miso$SB_IO_IN budget 40.382000 ns (23,0) -> (3,9)
Info:                Sink spiflash_miso_SB_LUT4_I0_LC.I0
Info:  1.3  7.7  Source spiflash_miso_SB_LUT4_I0_LC.O
Info:  1.8  9.5    Net spiflash_miso_SB_LUT4_I0_O budget 10.643000 ns (3,9) -> (3,9)
Info:                Sink csrbankarray_interface2_bank_bus_dat_r_SB_DFFSR_Q_3_D_SB_LUT4_O_LC.I2
Info:  1.2 10.6  Setup csrbankarray_interface2_bank_bus_dat_r_SB_DFFSR_Q_3_D_SB_LUT4_O_LC.I2
Info: 2.4 ns logic, 8.2 ns routing

Info: Critical path report for cross-domain path 'posedge clk12$SB_IO_IN_$glb_clk' -> '<async>':
Info: curr total
Info:  1.4  1.4  Source spiflash_bitbang_en_storage_SB_DFFESR_Q_DFFLC.O
Info:  5.2  6.6    Net csrbankarray_csrbank2_bitbang_en0_w budget 39.164001 ns (1,9) -> (14,2)
Info:                Sink spiflash_cs_n_SB_LUT4_O_LC.I1
Info:  1.2  7.8  Source spiflash_cs_n_SB_LUT4_O_LC.O
Info:  4.1 12.0    Net spiflash_cs_n$SB_IO_OUT budget 39.376999 ns (14,2) -> (24,0)
Info:                Sink spiflash_cs_n$sb_io.D_OUT_0
Info: 2.6 ns logic, 9.4 ns routing

Info: Max frequency for clock 'clk12$SB_IO_IN_$glb_clk': 23.75 MHz (PASS at 12.00 MHz)

Info: Max delay <async>                         -> posedge clk12$SB_IO_IN_$glb_clk: 10.62 ns
Info: Max delay posedge clk12$SB_IO_IN_$glb_clk -> <async>                        : 11.99 ns

Info: Slack histogram:
Info:  legend: * represents 10 endpoint(s)
Info:          + represents [1,10) endpoint(s)
Info: [ 41229,  43205) |*+
Info: [ 43205,  45181) |******************+
Info: [ 45181,  47157) |****************+
Info: [ 47157,  49133) |***********+
Info: [ 49133,  51109) |***+
Info: [ 51109,  53085) |*******+
Info: [ 53085,  55061) |**************+
Info: [ 55061,  57037) |********************+
Info: [ 57037,  59013) |***********+
Info: [ 59013,  60989) |**********+
Info: [ 60989,  62965) |********************+
Info: [ 62965,  64941) |******************+
Info: [ 64941,  66917) |**************+
Info: [ 66917,  68893) |*******************+
Info: [ 68893,  70869) |************************************************************
Info: [ 70869,  72845) |**********************+
Info: [ 72845,  74821) |**************************+
Info: [ 74821,  76797) |*************************+
Info: [ 76797,  78773) |****************************************************+
Info: [ 78773,  80749) |************************************+

real	0m29.493s
user	0m30.073s
sys	0m0.503s
(LX P=ice40_up5k_b_evn C=vexriscv F=linux R=???) root@homelinux:~/icesugar/icesugar/src/advanced/litex-buildenv#

Closed 2021-09-25.

Thread 44 (2021-11-08):

ICELINK open Fail on MAC M1 with ICESUGAR

EngRaff92, 2021-11-08:
Hello,

Currently using the Icesugar on MAC M1, is there any support for it ? I initially thought yes since the iceprog and icesprog are supported under rosetta. Anyway seems the problem might only be the Debugger ?

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

thanks for the Help

EngRaff92, 2021-11-08:
Macos and the m1 already provides support for usb cdc so i just left the board plugged and rebooted the pc and it automatically detects it

Closed 2024-01-08.

Thread 45 (2022-01-03):

Demo: uart_tx not working

piso77, 2022-01-03:
I tried both the prebuilt binary and to rebuild it myself - no output on the usb-c serial:

@cdone:1
@reset
@cdone:0
@prog [0x00000000]
@prog [0x00010000]
@start
@cdone:1

and if i connect the micro usb to my pc, no new serial devices appear (i'm using Linux, so no /dev/ttyUSB* show up) so i can't connect there.

How is one supposed to run this demo?

piso77, 2022-01-05:
Ok, after a bit of tinkering i realized what is wrong:

the microusb is not used at all, instead one is supposed to plug a PmodUSBUART (see Digilent website) into PMOD1, after that, and after opening a serial connection on ttyUSB0 @ 9600, i got the output.

But then i tried uart_echo, and i found this:

src/common/io.pcf:
...
set_io RX    4 # IOB_8A
set_io TX    6 # IOB_13B
...

but if you look at the schematics in schematic/iCESugar-v1.5.pdf, these two signals are on two different rows - oh, and even after fixing pin numbers, the uart_echo example still doesn't work.

LHLaurini, 2022-11-13:
You need to set the correct baud rate. Connect the board throught USB, then use `screen /dev/ttyACM0 115200`.

wil-low, 2023-01-26:
I got my UART working through USB-C with both jumpers on J5 in horizontal direction, and using /dev/ttyACM0 via minicom or Arduino IDE, with matching baud rate.

Closed 2024-01-08.

Thread 47 (2022-03-20):

TFTLCD - SPI Register map

bartokon, 2022-03-20:
Hi,
Where can I find datasheet with SPI register Map for pmod_tftlcd-v1.1?
From documentation, LCD driver IC is NV3047, but I can't find any information on that part.
Thanks.

wuxx, 2022-03-21:
hello
the lcd is based on ili9341, please check here
https://github.com/wuxx/icesugar/blob/master/doc/ILI9341_DS.pdf

bartokon, 2022-04-01:
@wuxx thanks for link!
Is there an example design for this LCD in the repository?

wuxx, 2022-04-02:
Hi, what do you mean the example design.
the example code can check here
https://github.com/wuxx/iceZ0mb1e/tree/master/firmware/main

bartokon, 2022-04-04:
Hey, Wuxx!

I have some questions regarding the LCD:
The "RS" is "D/CX" port? And the LCD is configured to 4-spi mode?
There is no other chip besides LCD on the PCB, is that normal? The LCD have inbuilt controllers?
Does touch functionality work somehow? If there is no controller? How?

Sorry for these questions, but the documentation and schematics are lacking some important information.

bartokon, 2022-04-05:
So, RS is D/CX, the LCD is configured in 4-spi mode. I still don't know about the touch functionality.

wuxx, 2022-04-06:
hello, RS is DC (data/cmd), LCD is in 4-spi mode. the LCD have inbuilt controllers.
currently the touch function is not supported on hardware

bartokon, 2022-04-06:
Hi,
"LCD have inbuilt controllers ... **currently** the touch function is not supported on hardware". So that means LCD is touch-screen ready, but icesugar is not?
I'm writing my own drivers for the LCD in Verilog, so if the LCD is touch-capable, can you provide me with a data sheet for touch driver?

wuxx, 2022-04-06:
Hello, touch is not currently supported on the hardware. Touch requires the circuit at the bottom of the board (based on xpt2046) and the support of the screen. All screens currently shipped do not have a touch screen installed.

wuxx, 2022-04-06:
when we mentioned touchscreen, the touchscreen include LCD display and a Touch panel on top of screen.

bartokon, 2022-04-06:
Okay! So last question that 3 little ic's are resistors/capacitors?

wuxx, 2022-04-06:
yes

MicroDuck, 2023-04-15:
hello good morning!
I wanted to know if you still don't have something about the TFT screen for the ICESugar_1.5

I am investigating to find out how it works and implement it in projects with Verilog, myself also to test the TFT modules that I can buy. First of all, thank you for your time and I hope to contribute something to you in the future.

bartokon, 2023-04-15:
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

Take a look: https://www.hackster.io/bartosz-rycko/minized-with-pmod-tft-lcd-e0d682

wuxx, 2023-04-17:
hello, the screen is based on ili9341, there should be lot of document, just search the 'ili9341' in google

wuxx, 2023-04-17:
[ILI9341.pdf](https://github.com/wuxx/icesugar/files/11245933/ILI9341.pdf)
here is the spec, please check.

Closed 2024-01-08.

Thread 48 (2022-12-10):

unable to run make prog

quantrpeter, 2022-12-10:
hi, my board is Lattice iCE40UP5k , when i plug it in, my ubuntu mount it as a drive and make prog not work, please help:

/home/peter/workspace/ice40_ultraplus_examples/leds>make prog
iceprog -S leds.bin
init..
Can't find iCE FTDI USB device (vendor_id 0x0403, device_id 0x6010 or 0x6014).
ABORT.
make: *** [Makefile:10: prog] Error 2

wuxx, 2022-12-10:
please try cmd icesprog leds.bin

brandcrz88, 2024-05-02:
Hi, I hope someone finds this useful.

I am using Ubuntu, for me the problem had to do with setting the rules and permissions properly.

- Stablish your PATH on your predetermined Shell:

export PATH="/path/to/fomu-toolchain-Linux/bin:$PATH"

- You can see that running "make prog" trows that err, this fixes that:

sudo /path/to/fomu-toolchain-Linux/bin/iceprog stopwatch.bin

- Now make that permanent. Check your device ID with:

lsusb

- If necessary, change your device rules, I had to change my idProduct from 6011 to 6010, and then add a GROUP="dialout".

- Go to:

sudo /etc/udev/rules.d/99-usb-serial.rules

- I changed:

SUBSYSTEM=="usb", ATTRS{idVendor}=="0403", ATTRS{idProduct}=="6011", MODE="0666"

- To:

SUBSYSTEM=="usb", ATTRS{idVendor}=="0403", ATTRS{idProduct}=="6010", MODE="0666", GROUP="dialout"

- Reload the rules with:

sudo udevadm control --reload-rules

sudo udevadm trigger

- Add user:

sudo usermod -aG dialout $USER

I hope that now you can run make prog directly from /stopwatch-dual

Closed 2024-01-08.

Thread 49 (2022-12-24):

RGBLCD

djh82uk, 2022-12-24:
Hey,

I have the larger PMOD LCD from the aliexpress store.  Looking at the src folder, the only example I can find is the rgblcd one.  However this does not work (pcf unconstrained errors).

I noticed the pin labels on the lcd board looks like it is using SPI (MOSI etc), while the PCF file in the example references Hsync, Vsync and pins for the different RGB colours, however the pin numbers do not all align with the  2 PMODS).  Am I right in thinking this example is not meant for the muselab TFT LCD PMOD board?

If not, is there anywhere I can find examples or documentation to get started?

djh82uk, 2022-12-24:
AH, I did not realise there was an even larger LCD PMOD ([LINK](https://www.aliexpress.com/item/1005001505576467.html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,scm-url:1007.13339.291025.0,pvid:191a2141-45d9-4f15-908e-2404f7e0c628,tpp_buckets:668%232846%238115%232000&pdp_ext_f=%7B%22sku_id%22%3A%2212000016385710159%22%2C%22sceneId%22%3A%223339%22%7D&pdp_npi=2%40dis%21GBP%216.77%216.77%21%21%21%21%21%40211b446116718402038474087e65a8%2112000016385710159%21rec)

I have the 2.3 inch one.  So I guess there just isn't any example code?  Any doc links would be appreciated.

Many Thanks

wuxx, 2024-01-08:
Hello, the rgblcd example in the repo supports 800x480 resolution.

Thread 50 (2023-01-08):

icesprog iCELink open fail

sirazenkov, 2023-01-08:
I have an iCESugar-nano board with v1.1a iCELink firmware. Provided [icesprog](https://github.com/wuxx/icesugar/blob/master/tools/icesprog) binary isn't the latest one: it doesn't have clock select and gpio control features. Device programming works fine, but I also need these features.

I built both v1.1a and v1.1b icesprog binaries from sources, however, when I try to program the device, I get an output: iCELink open fail!

wuxx, 2023-01-09:
hello, please try to add sudo before the command.

taotieren, 2024-01-09:
https://github.com/wuxx/icesugar/tree/master/tools/src#install-60-icesugarrules

Closed 2023-01-09.

Thread 51 (2023-02-03):

Flash reading from the iCE40 UltraPlus

wil-low, 2023-02-03:
I'm trying to communicate with built-in SPI flash but it does not respond to any commands - I tried the sources of flash example and JEDEC ID request. Looks like flash chip (Winbond 25Q64JVSIQ) is different from what is used in the example.

>> Don't forget to put the breakout board in flash mode using the jumpers on J6!

this is unclear too - how it relates to icesugar... When I set the jumpers vertically, the board does not load bitstream.

Maybe there is no way to address built-in SPI flash programmatically?

wil-low, 2023-02-04:
I found the explanation here: https://github.com/BrunoLevy/learn-fpga/blob/master/FemtoRV/TUTORIALS/spi_flash.md
It works now

Closed 2023-02-04.

Thread 53 (2023-10-26):

uart_echo unable to compile

quantrpeter, 2023-10-26:
hi

```
/home/peter/workspace/icesugar/src/basic/verilog/uart_echo>make
Makefile:5: iCELink path: /media/peter/iCELink
yosys -p "synth_ice40 -blif pll_uart_mirror.blif" pll_uart_mirror.v

 /----------------------------------------------------------------------------\
 |                                                                            |
 |  yosys -- Yosys Open SYnthesis Suite                                       |
 |                                                                            |
 |  Copyright (C) 2012 - 2020  Claire Xenia Wolf <claire@yosyshq.com>         |
 |                                                                            |
 |  Permission to use, copy, modify, and/or distribute this software for any  |
 |  purpose with or without fee is hereby granted, provided that the above    |
 |  copyright notice and this permission notice appear in all copies.         |
 |                                                                            |
 |  THE SOFTWARE IS PROVIDED "AS IS" AND THE AUTHOR DISCLAIMS ALL WARRANTIES  |
 |  WITH REGARD TO THIS SOFTWARE INCLUDING ALL IMPLIED WARRANTIES OF          |
 |  MERCHANTABILITY AND FITNESS. IN NO EVENT SHALL THE AUTHOR BE LIABLE FOR   |
 |  ANY SPECIAL, DIRECT, INDIRECT, OR CONSEQUENTIAL DAMAGES OR ANY DAMAGES    |
 |  WHATSOEVER RESULTING FROM LOSS OF USE, DATA OR PROFITS, WHETHER IN AN     |
 |  ACTION OF CONTRACT, NEGLIGENCE OR OTHER TORTIOUS ACTION, ARISING OUT OF   |
 |  OR IN CONNECTION WITH THE USE OR PERFORMANCE OF THIS SOFTWARE.            |
 |                                                                            |
 \----------------------------------------------------------------------------/

 Yosys 0.30+48 (git sha1 14d50a176, clang 14.0.0-1ubuntu1 -fPIC -Os)

-- Parsing `pll_uart_mirror.v' using frontend ` -vlog2k' --

1. Executing Verilog-2005 frontend: pll_uart_mirror.v
Parsing Verilog input from `pll_uart_mirror.v' to AST representation.
pll_uart_mirror.v:69: ERROR: syntax error, unexpected TOK_REG
make: *** [Makefile:8: build] Error 1
```
thanks

kinweilee, 2024-03-22:
For some reason 'wire reg' is being used which an incorrect statement it should be just 'wire'.

Thread 58 (2024-03-21):

iceSugar v1.5 Clock @ 6MHz

ButterBison, 2024-03-21:
I have just noticed that the ICE_CLK for my iceSugar v1.5 board is set at 6MHz. However the schematics indicate that the oscillator X1 is a 12MHz oscillator.

The only thing I can see that can divide the cock is the icelink.

I have tried with the iceprog tool as well to set the mco, but no luck.

```
$sudo ./icesprog -p
probe chip
board: [iCESugar]
flash: [w25q64] (8MB)
done

```

```
$ sudo ./icesprog -c 2
only iCESugar-Nano support mco select
^C
```

Can someone confirm this?

wuxx, 2024-03-22:
Hello, iCESugar's clock is driven by iCELink's PA8, and the default should be 12MHz. How do you measure the 6MHz clock currently, with a logic analyzer or an oscilloscope?

ButterBison, 2024-03-22:
Hi,

Thanks for your reply. I just made a measurement with logic analyzer on the jumper J1.

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

The clock is correct. I will need to double check my code. Closing this issue for now.

Closed 2024-03-22.

Thread 59 (2024-09-04):

What chip powers the pmod_hdmi-v1.1 PMOD connector?

mmaloney-sf, 2024-09-04:
The documentation doesn't seem to list what IC chip is used to power the PMOD HDMI v1.1 add-on. There are also no examples of this.

What chip is this? It might be nice to contribute an example to this repo for that connector.

mmaloney-sf, 2024-09-04:
It was pointed out to me that there's no IC for this chip. It's just pinning out to an HDMI socket with a power regulator.

Closed 2024-09-04.

Thread 61 (2025-02-22):

Max frequency for clock

quantrpeter, 2025-02-22:
hi
    want to ouput the clock to a plk, but i got

ERROR: Max frequency for clock 'P1_12$SB_IO_OUT': 43.75 MHz (FAIL at 48.00 MHz)

```
`include "OLED.v"
`include "I2C.v"

module testOLED(input clk,
              output P1_9,
              output P1_10,
              output P1_11,
              output P1_12,
              output P2_12);

	OLED OLED1(.SCL(P1_9),.SDA(P1_10),.FPS(P1_11), .clk48(P1_12));

	assign P1_1=clk;
endmodule
```

please help
thanks
Peter

Thread 65 (2025-09-01):

Unexpected RGB LED mapping on iCESugar v1.5 (Pin assignment mismatch?)

loadingStars, 2025-09-01:
# Unexpected RGB LED mapping on iCESugar v1.5 (Pin assignment mismatch?)

## Description
On the iCESugar v1.5 board, the silkscreen indicates the following RGB LED connections:

- **B** → Pin P39
- **R** → Pin P40
- **G** → Pin P41

Based on this, I set up my Verilog like so:

```verilog
assign LED_G = 1'b1;
assign LED_R = 1'b1;
assign LED_B = 1'b0;
```

And my .pcf file contains:

```
set_io -nowarn LED_G 41
set_io -nowarn LED_R 40
set_io -nowarn LED_B 39
```

## Observed behavior
When driving ```LED_B = 1'b0```, the Green LED lights up.
When driving  ```LED_G = 1'b0```, the Blue LED lights up instead.

The mapping between pins and LED colors does not seem to match the silkscreen or the expected configuration.

## Expected behavior
Each LED color should correspond to its documented pin assignment without cross-activation.

## Questions

- Is this a known hardware quirk of the iCESugar v1.5 board?
- Could the silkscreen be mislabeled, or is there another explanation (e.g., common-anode/cathode wiring)?

### For reference:

```verilog

module switch (
    output wire LED_G,
    output wire LED_R,
    output wire LED_B
);

    assign LED_G = 1'b1;
    assign LED_R = 1'b1;
    assign LED_B = 1'b0; // Turn on Blue LED (but turns on Green)

endmodule

```

wuxx, 2025-09-03:
Hello, please try the following operation: remove all J6 shorting caps, bypass the FPGA, and then use a DuPont wire to short-circuit for LED lighting test. I tested on the board and it worked fine

loadingStars, 2025-09-03:
Thanks for the clarification and the J6 jumper-wire test method!
I confirmed it on my iCESugar v1.5 board: the silkscreen labeling for the RGB LED is incorrect. The actual working pin mapping is:
Pin 39 → Green
Pin 40 → Red
Pin 41 → Blue
The LED is active-low, so driving a pin 0 turns that color on.
So this means wiring on my board is wrong?

wuxx, 2025-09-03:
Hello, I'm sorry. I have checked the current products and found that the color of the old batch of boards is normal, but the color of the new batch is abnormal. It seems that there was a change in the batch sent to us by the LED manufacturer. We will adjust it back in the next version. I apologize for the inconvenience
