wuxx/icesugar/schematic/pmod-vga-v1.1.pdf

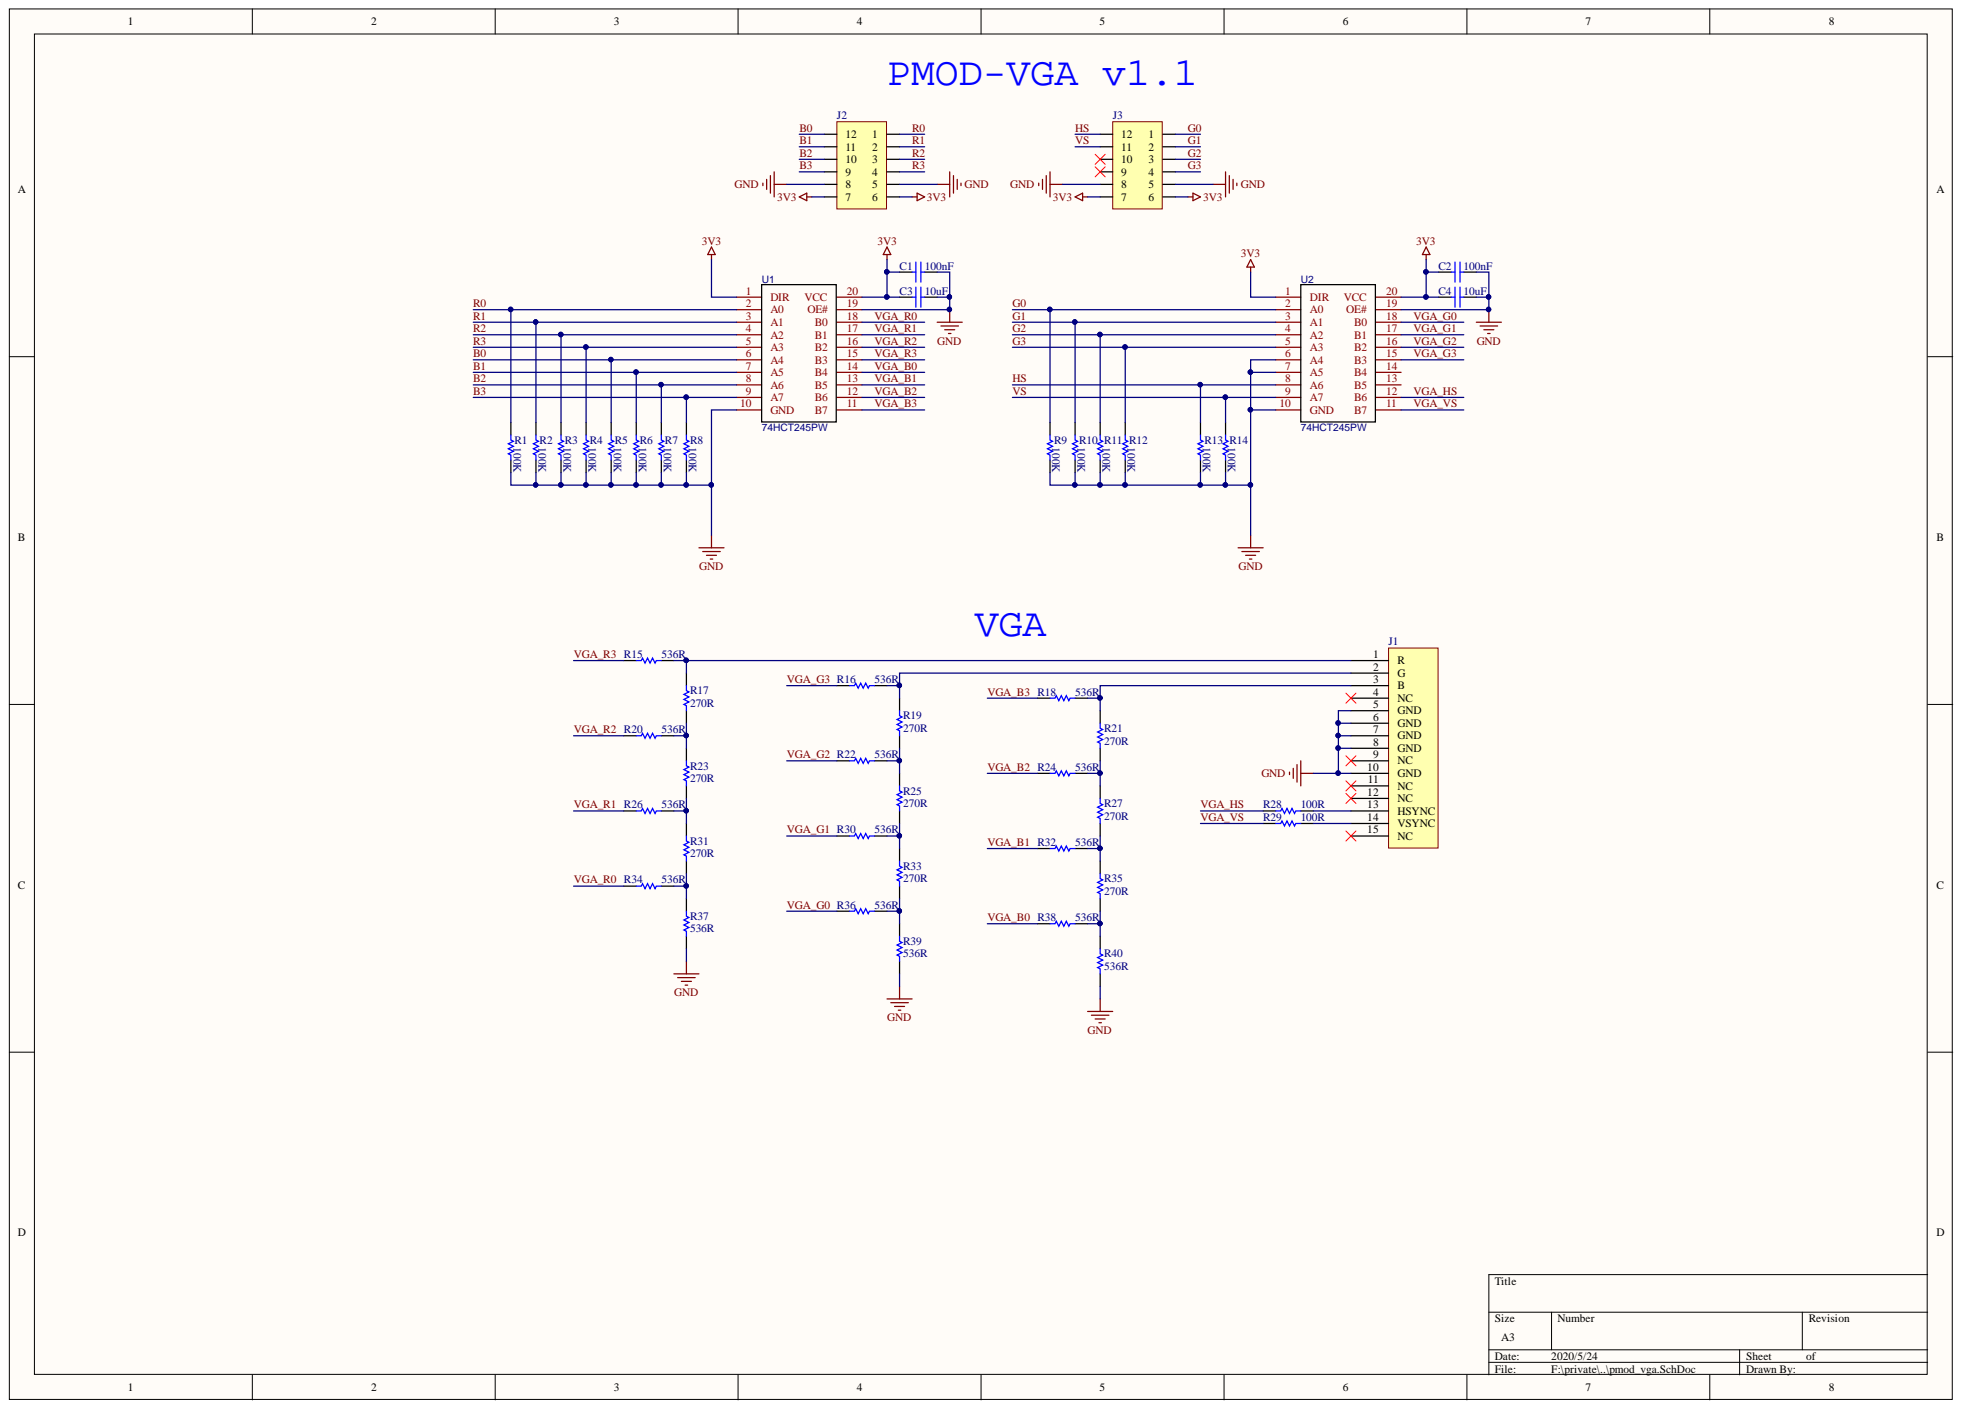
[picture p12: page 1]

G 2
B 3 NC 4

GND 5

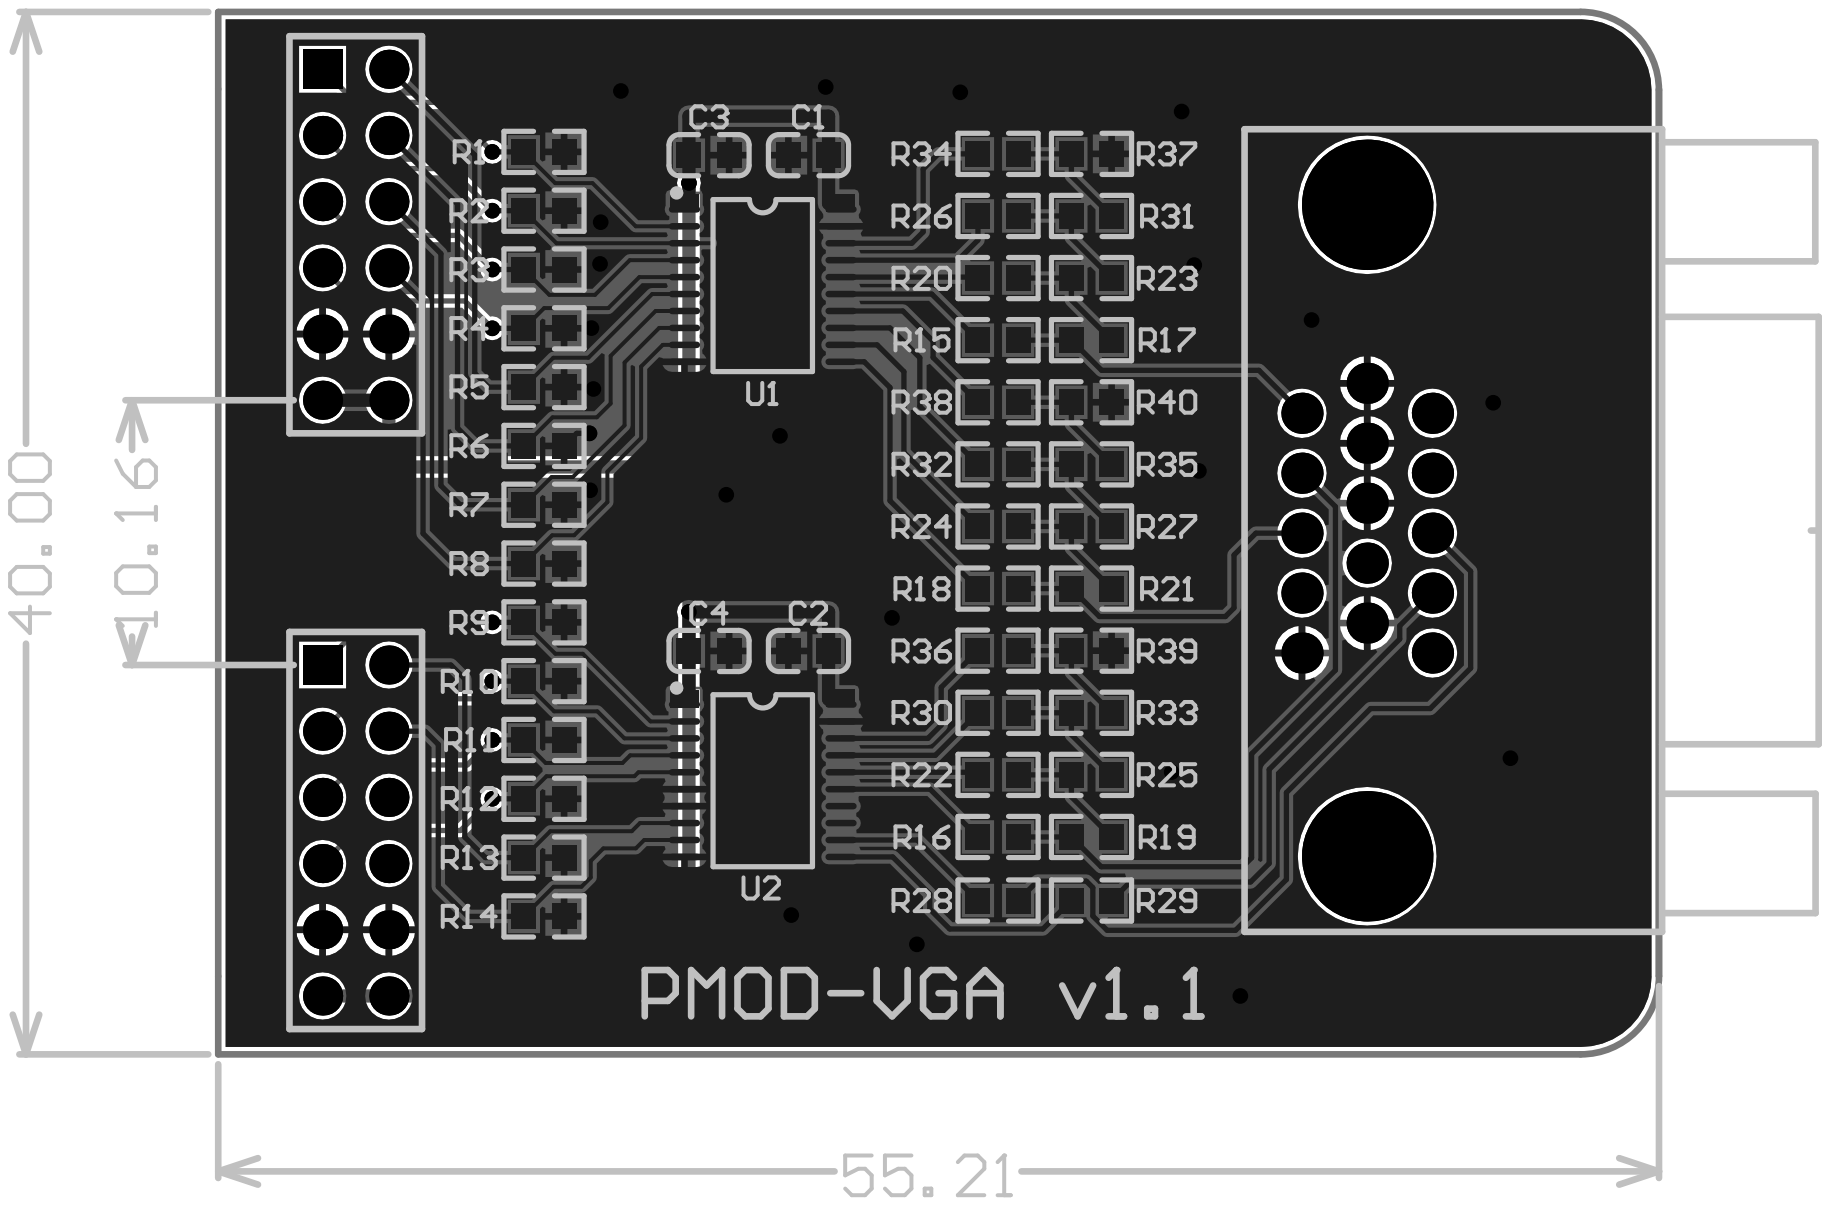
[picture p13: page 2]
