wuxx/icesugar/schematic/pmod-usbhost-v1.0.pdf

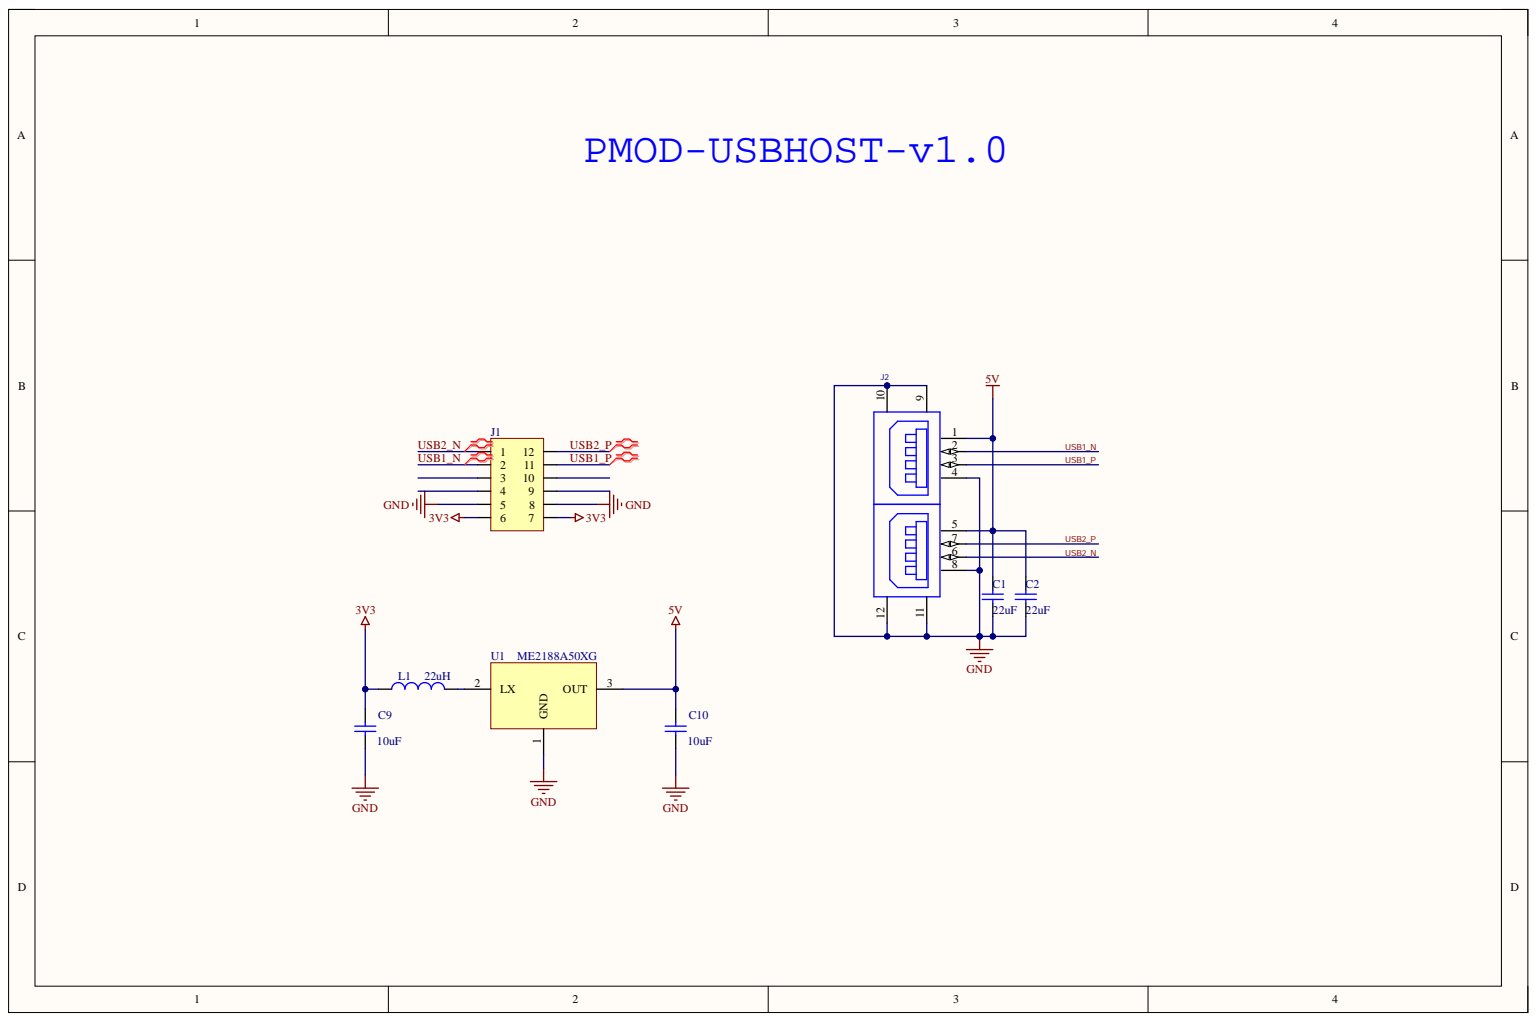
[picture p14: page 1]
