wuxx/icesugar/schematic/pmod-ethernet-v1.0.pdf

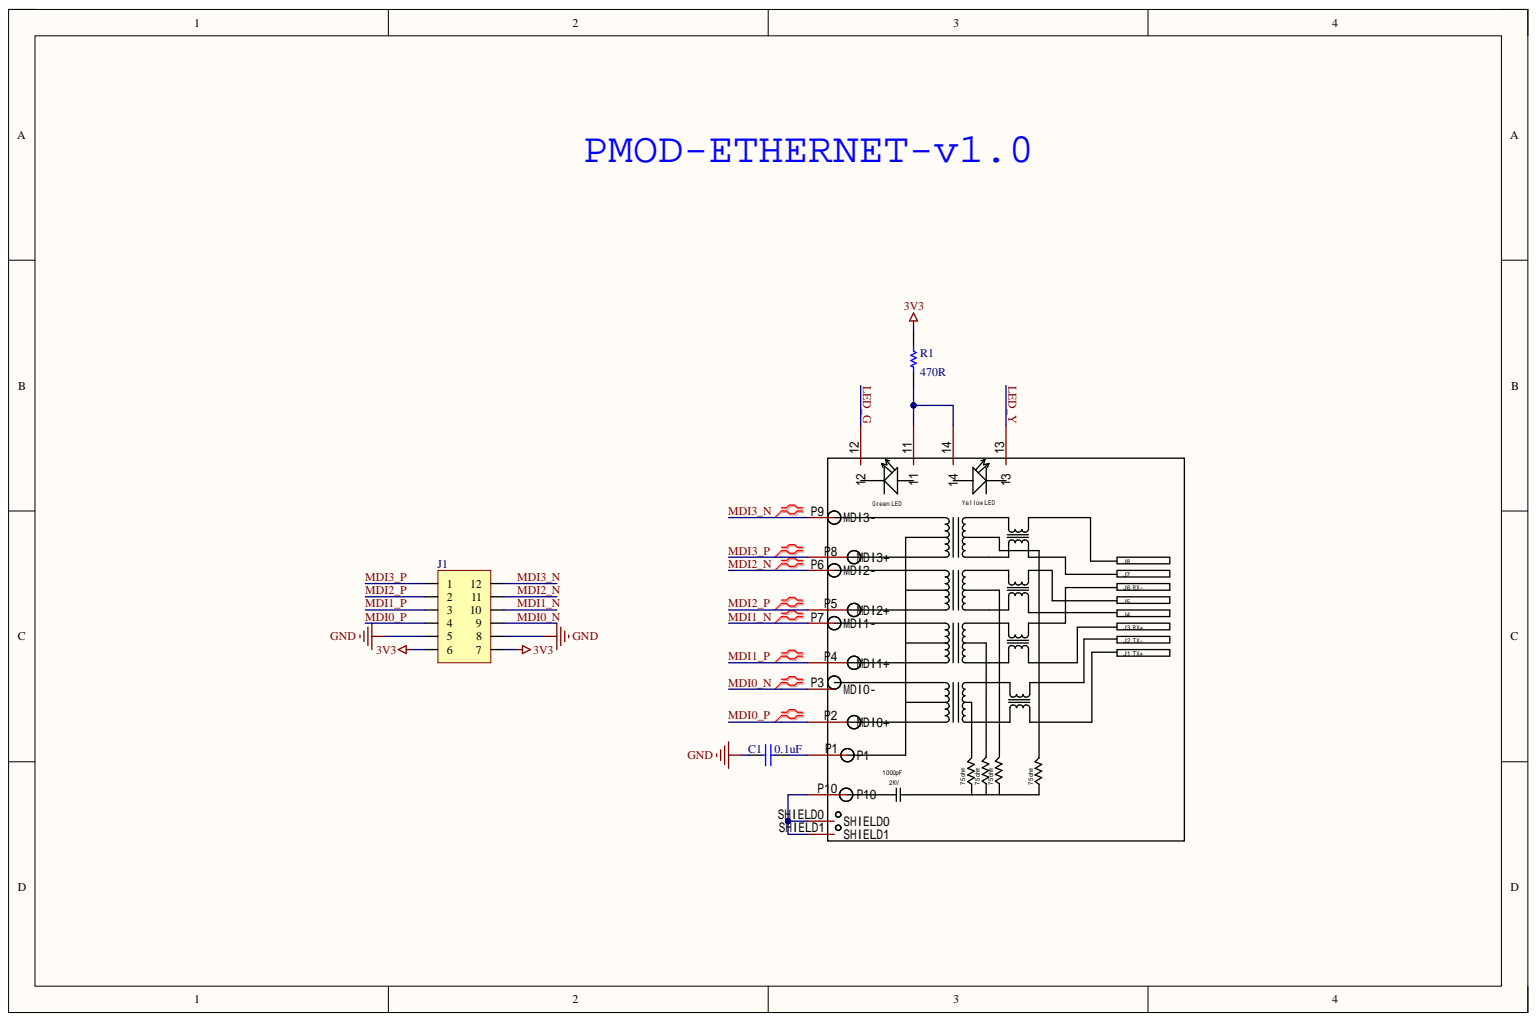
[picture p15: page 1]
