wuxx/icesugar/schematic/pmod-microphone-v1.0.pdf

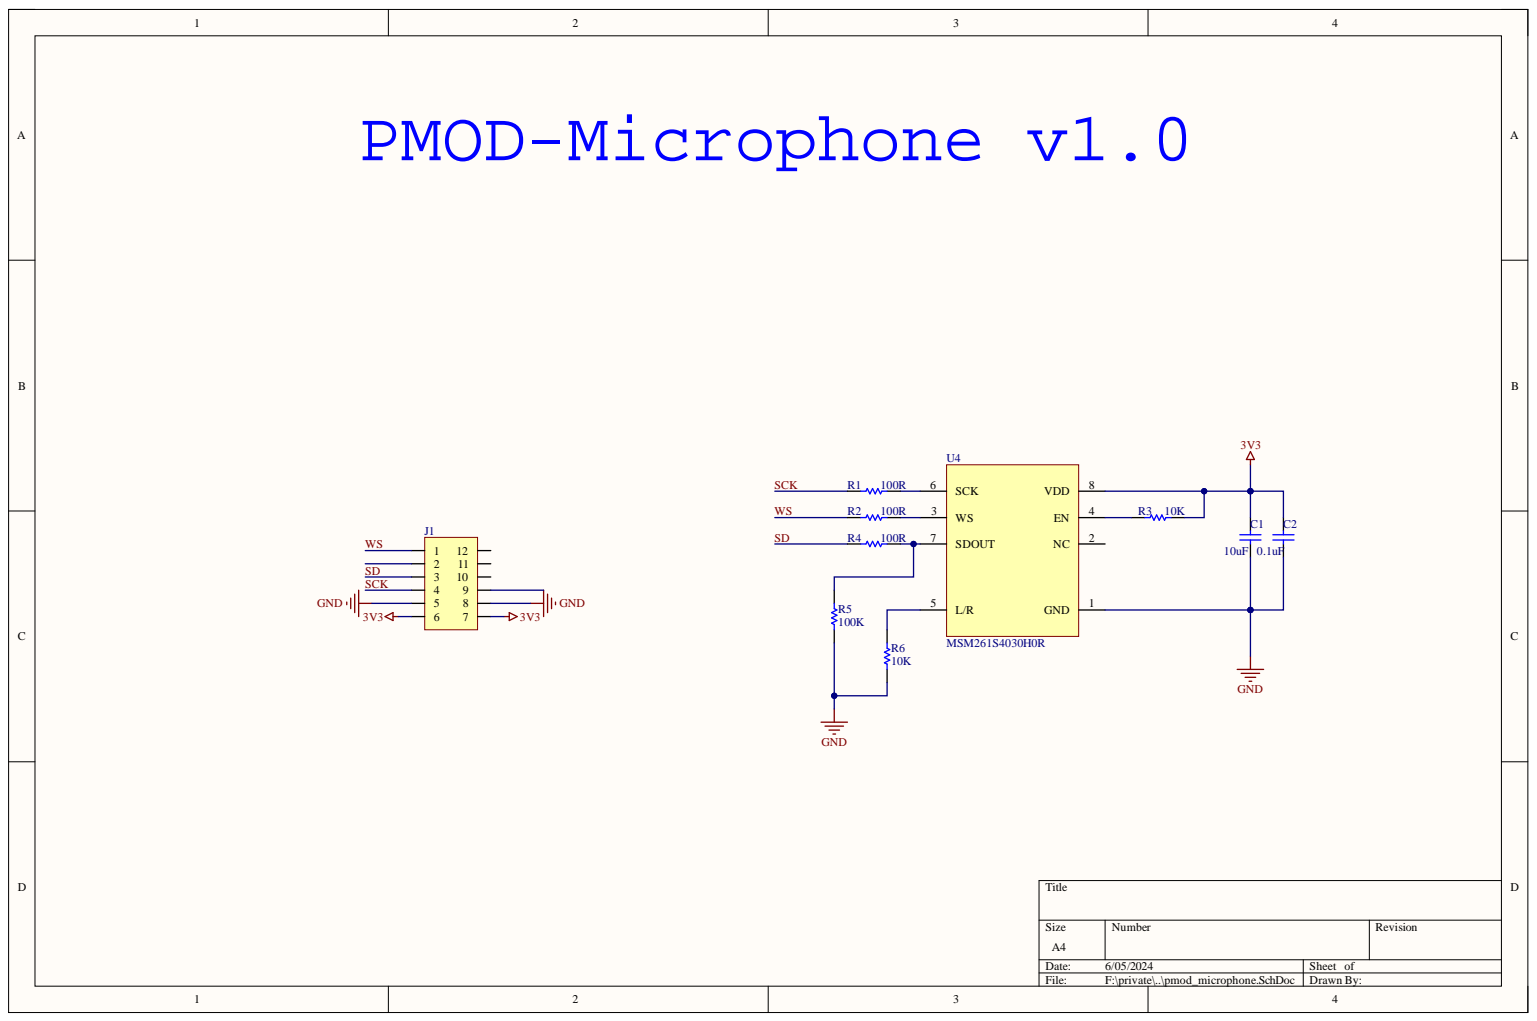
[picture p16: page 1]
