wuxx/icesugar/schematic/pmod-camera-v1.0.pdf

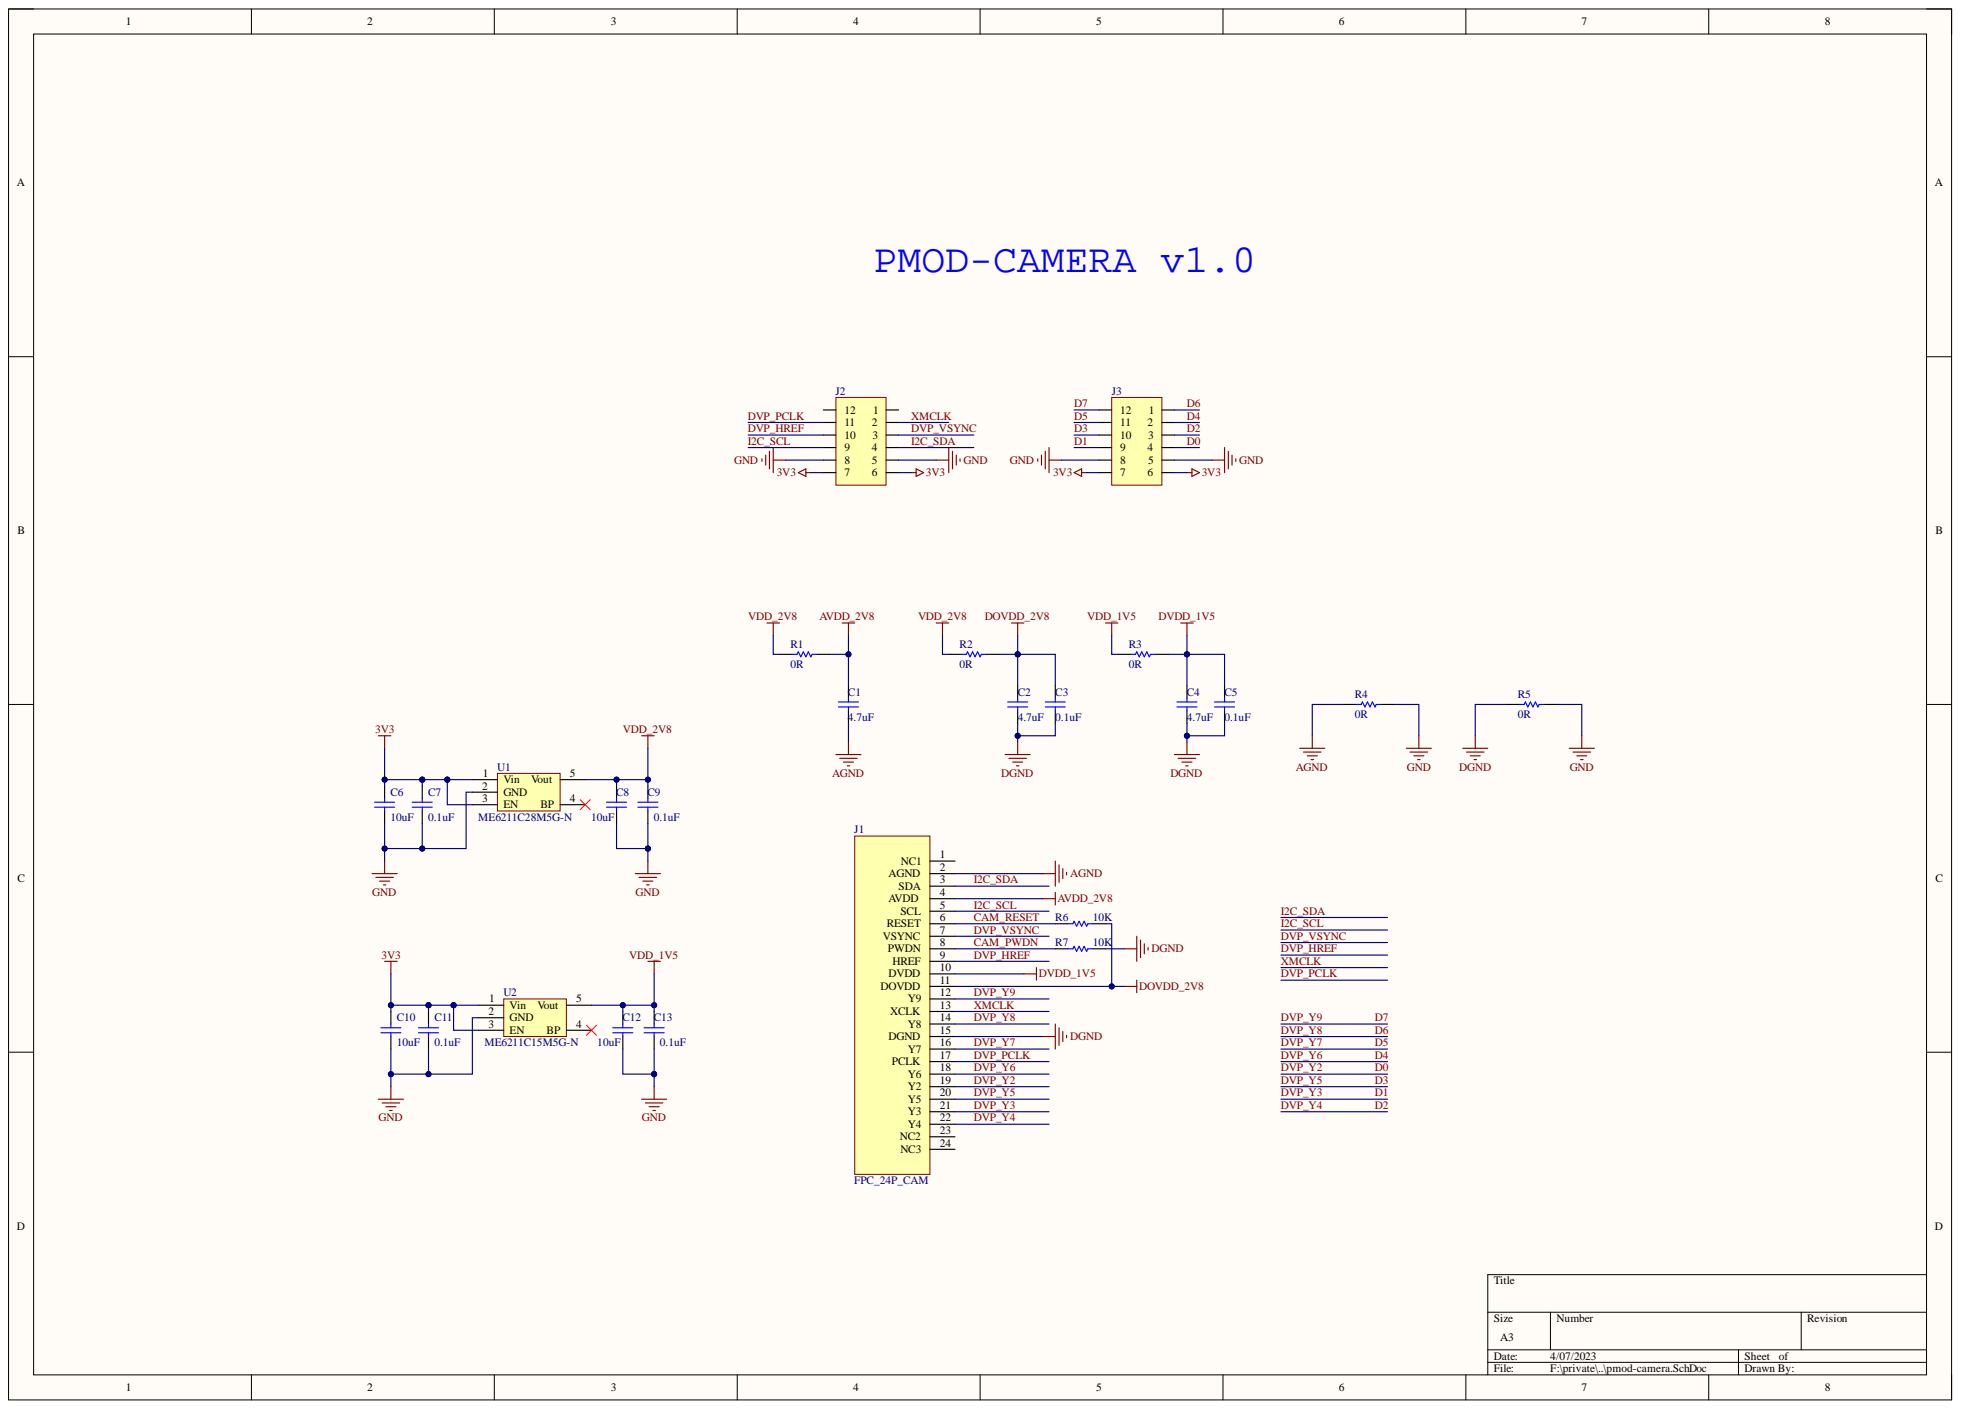
[picture p17: page 1]
