wuxx/icesugar/schematic/pmod-hdmi-v1.1.pdf

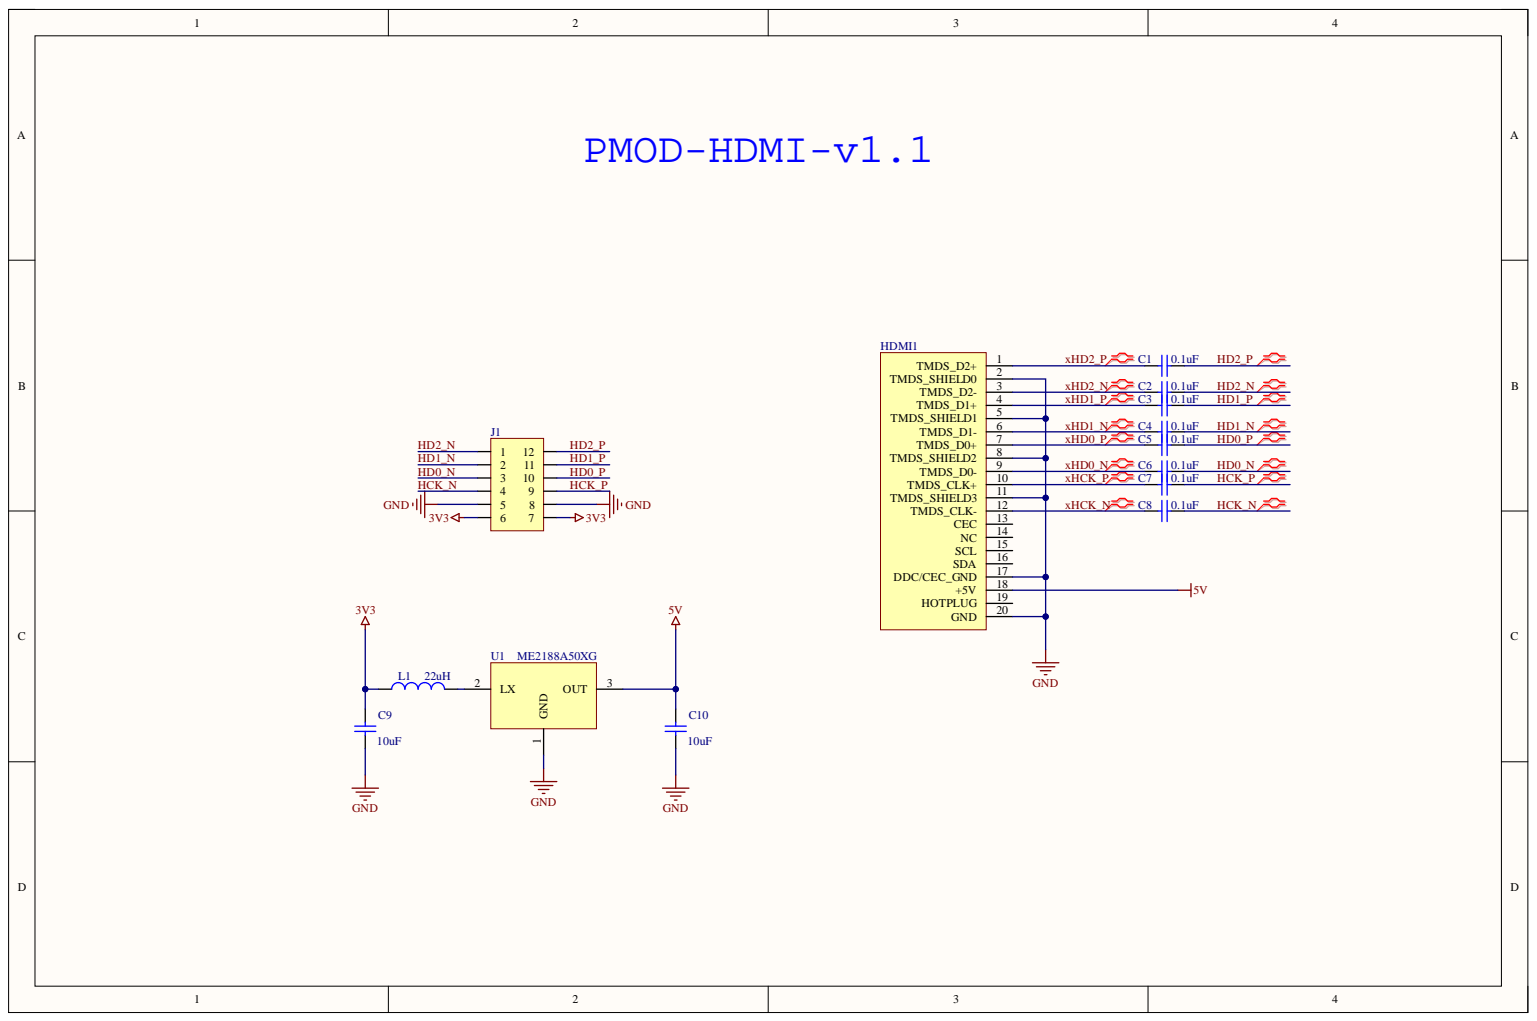
[picture p18: page 1]

4 | x H D 1 _P C3

7 | x H D 0 _P C5

1 0 | x HCK_P C7
1 1
