wuxx/icesugar/schematic/pmod-lcd-0.96-v1.0.pdf

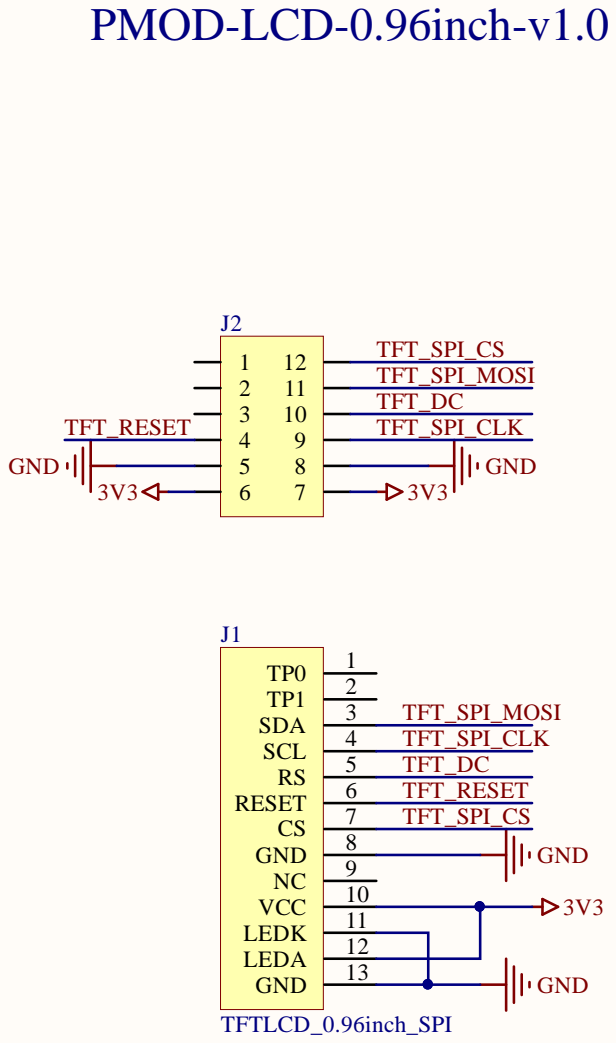
[picture p19: page 1]
