wuxx/icesugar/schematic/pmod-sdcard-v1.0.pdf

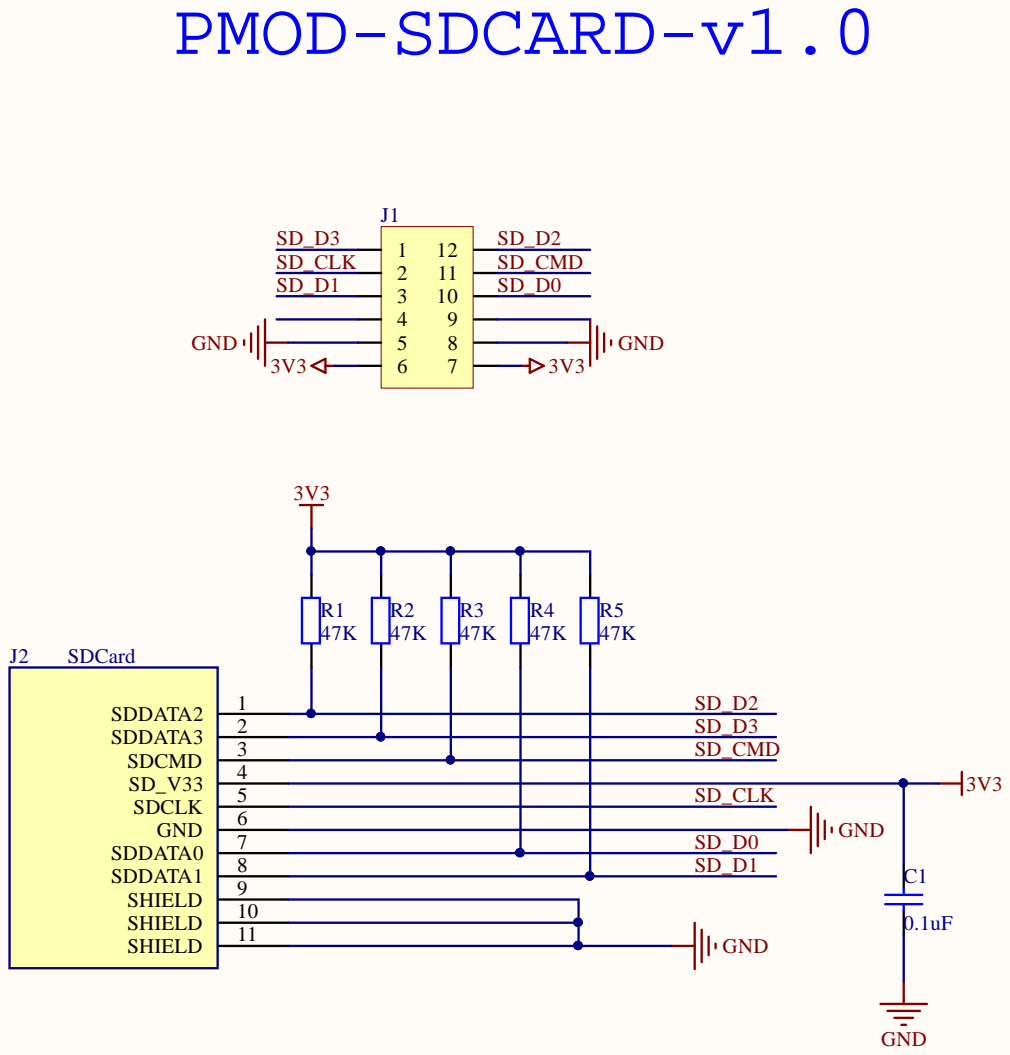
[picture p20: page 1]
