wuxx/icesugar/schematic/pmod-rgblcd-v1.3.pdf

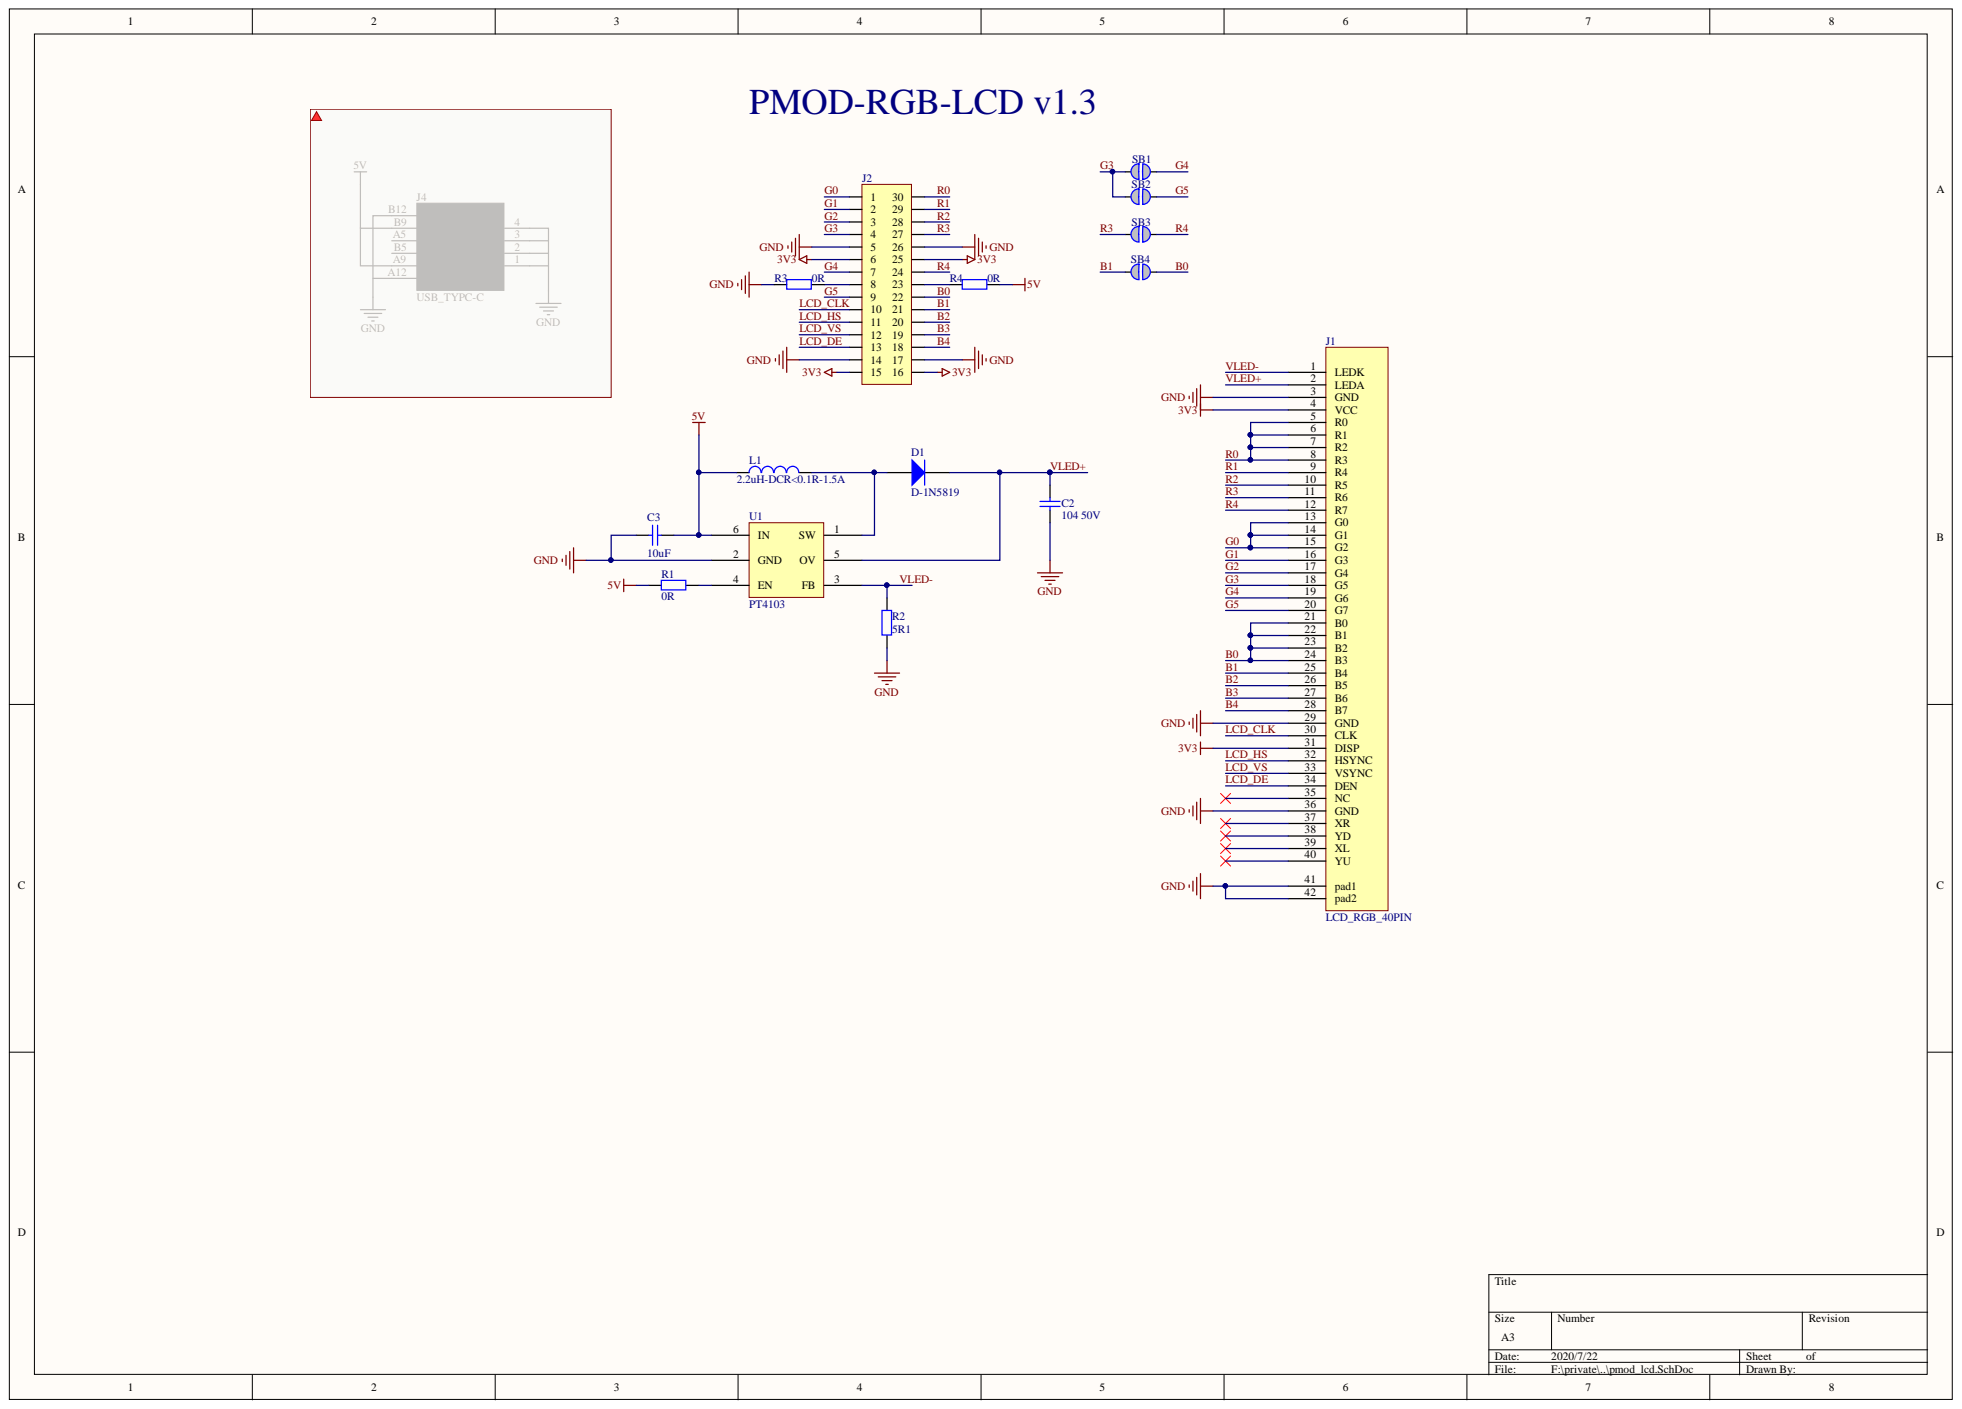
[picture p21: page 1]

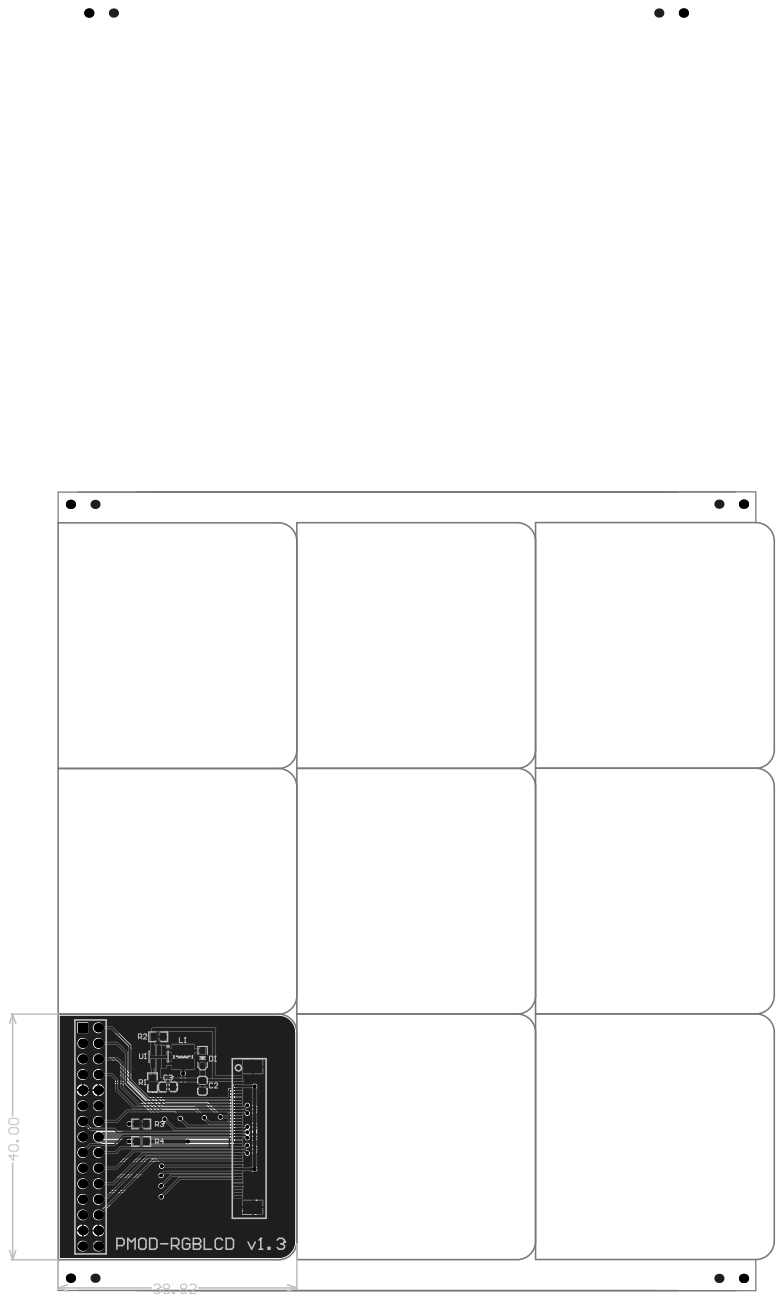
[picture p22: page 2]
