wuxx/icesugar/schematic/pmod-audio-v1.2.pdf

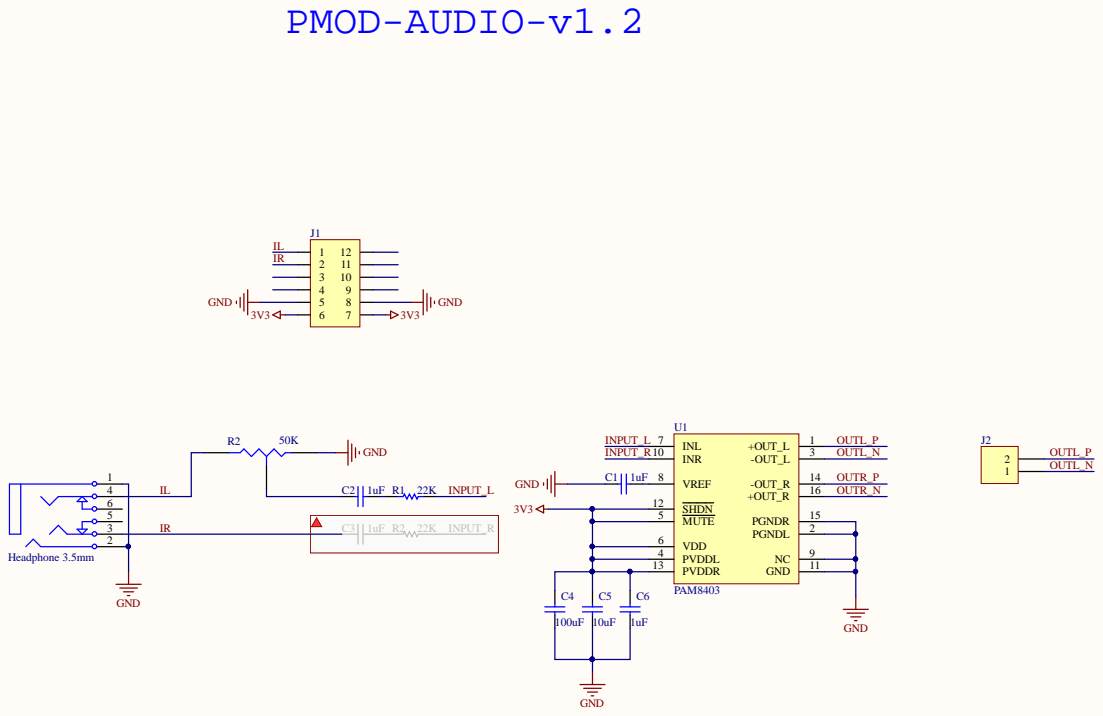
[picture p23: page 1]

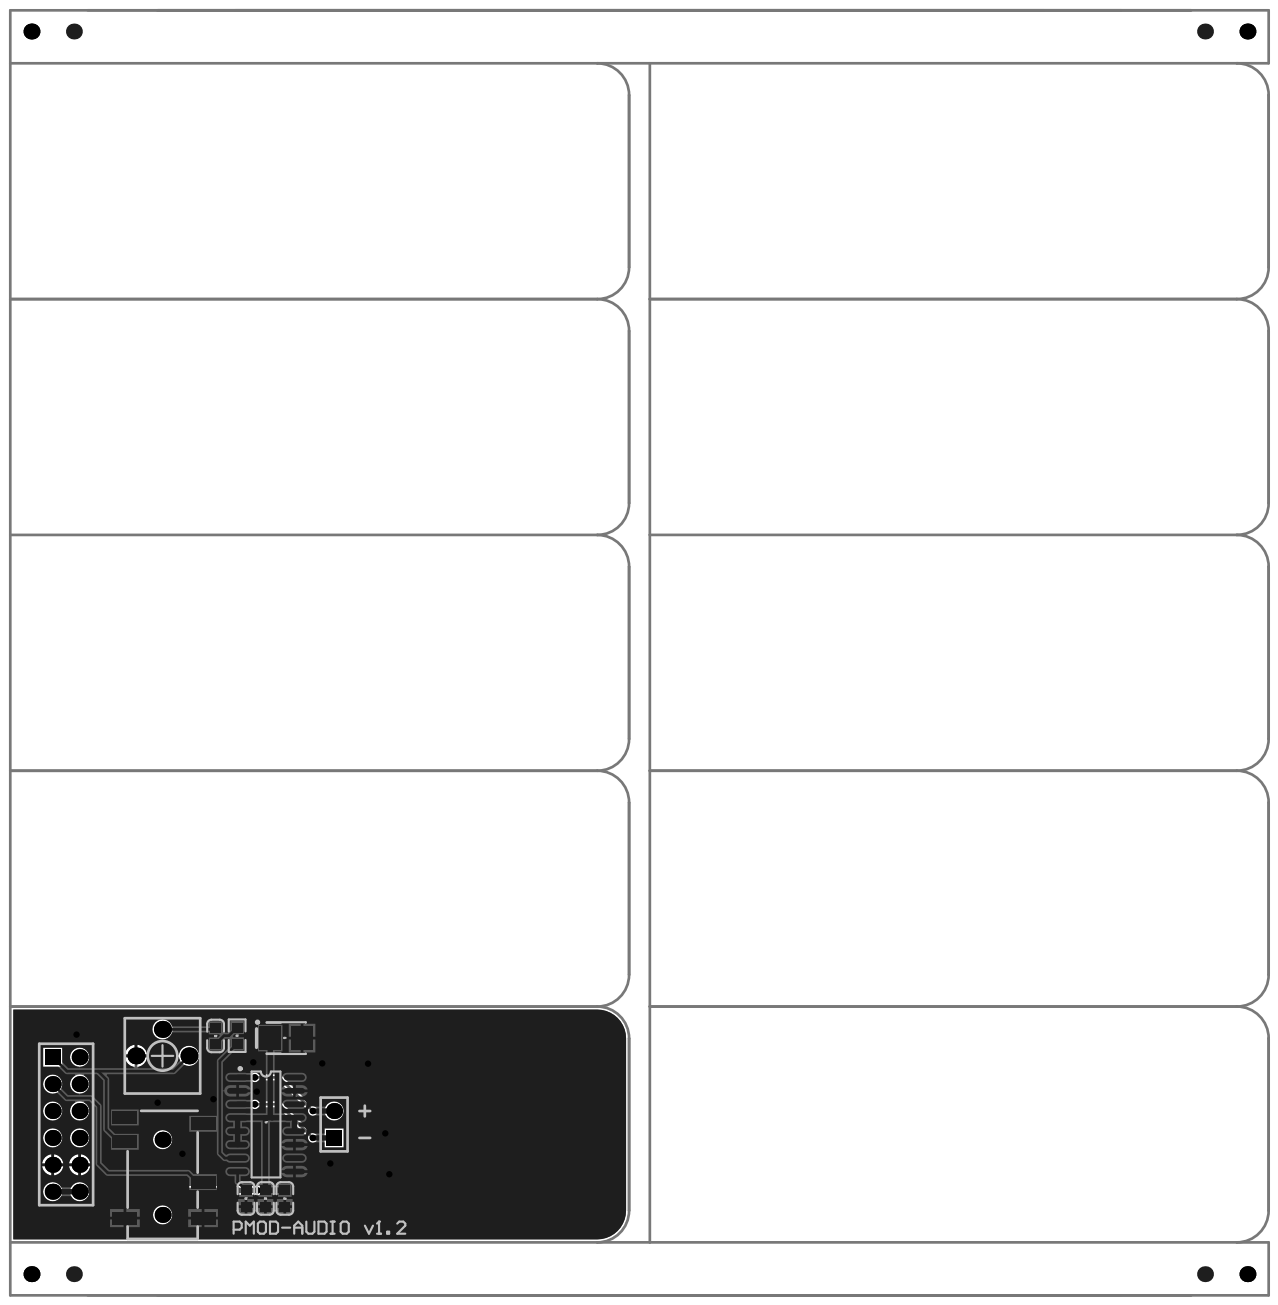
[picture p24: page 2]
