wuxx/icesugar/schematic/pmod-switch-v1.0.pdf

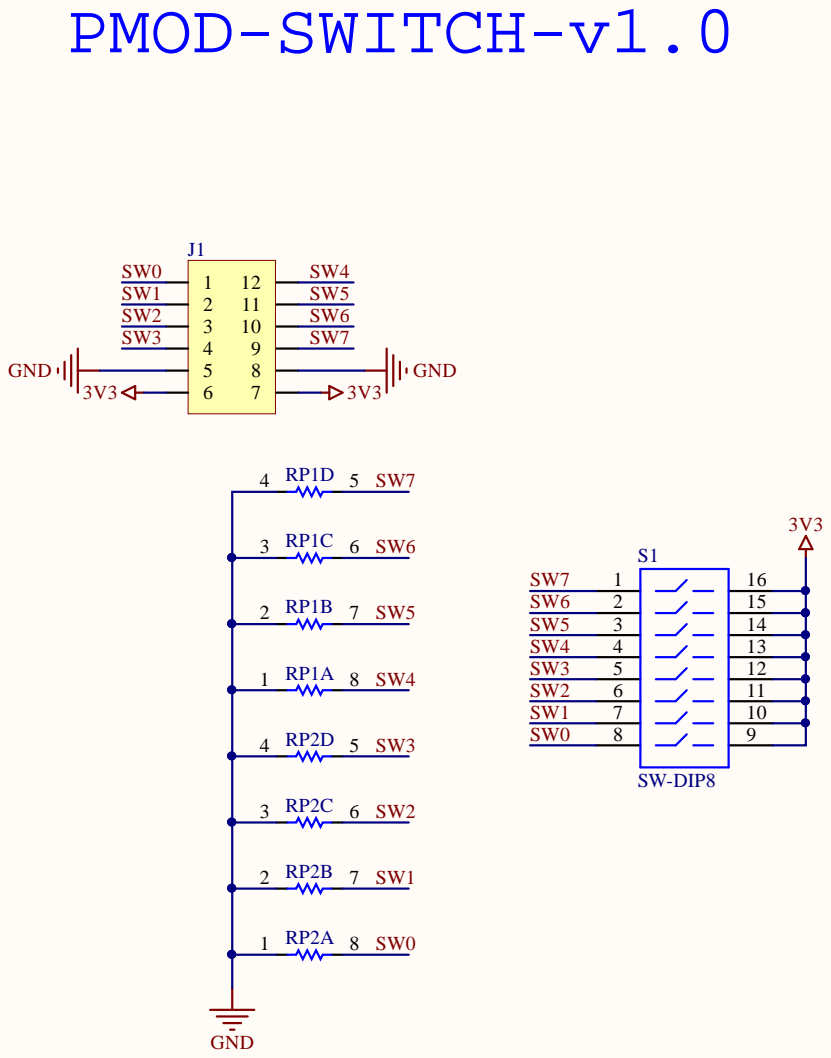
[picture p25: page 1]
