wuxx/icesugar/schematic/iCESugar-v1.5.pdf

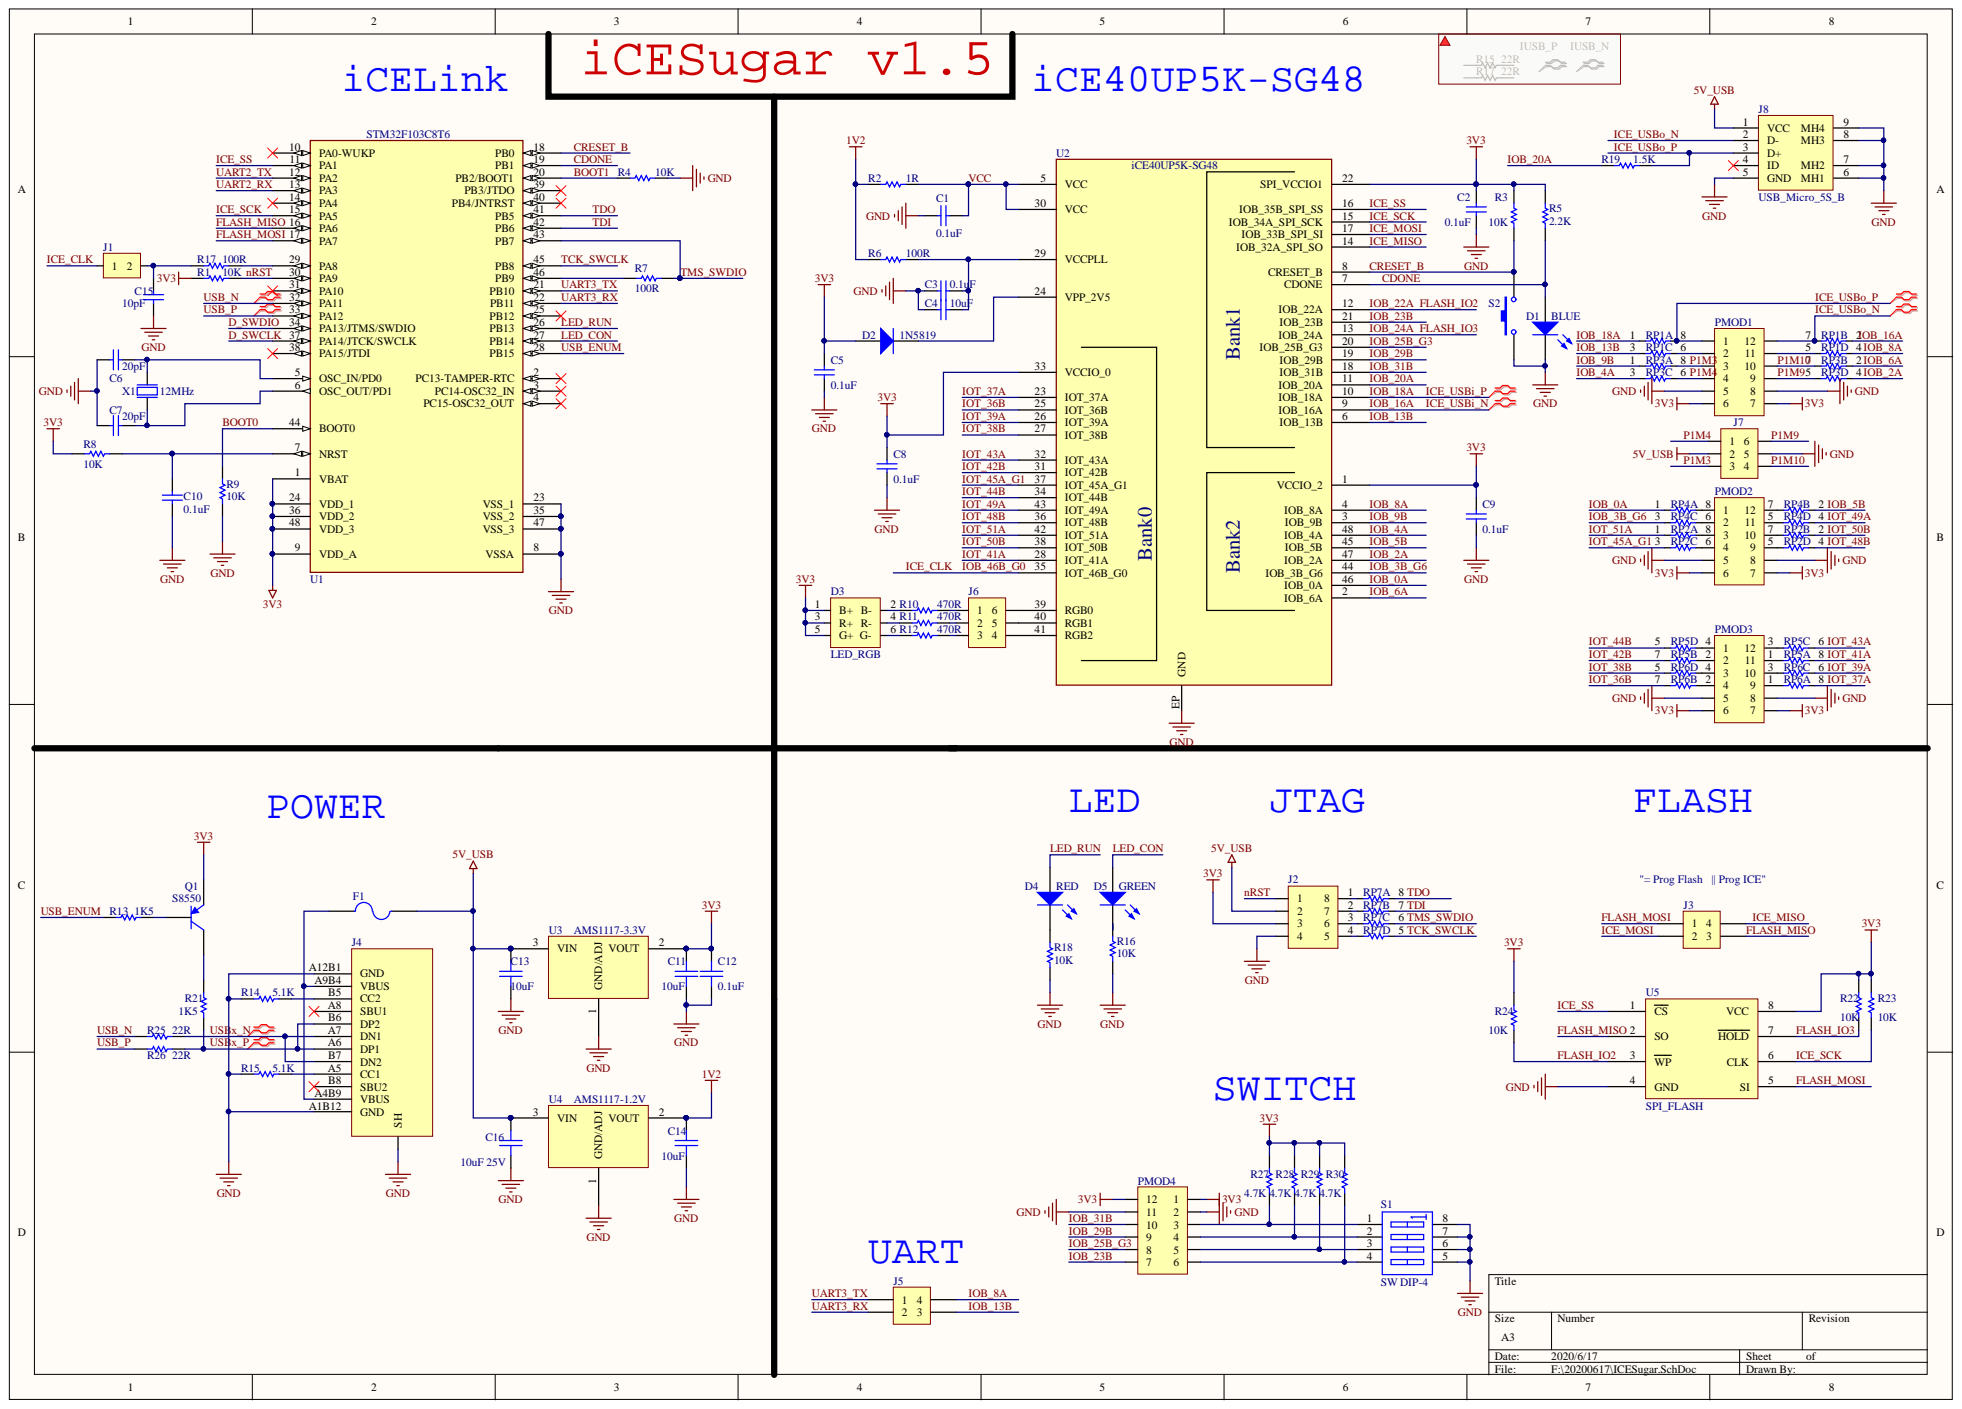
[picture p26: page 1]

"= Prog Flash || Prog ICE"
