wuxx/icesugar/schematic/pmod-tftlcd-v1.1.pdf

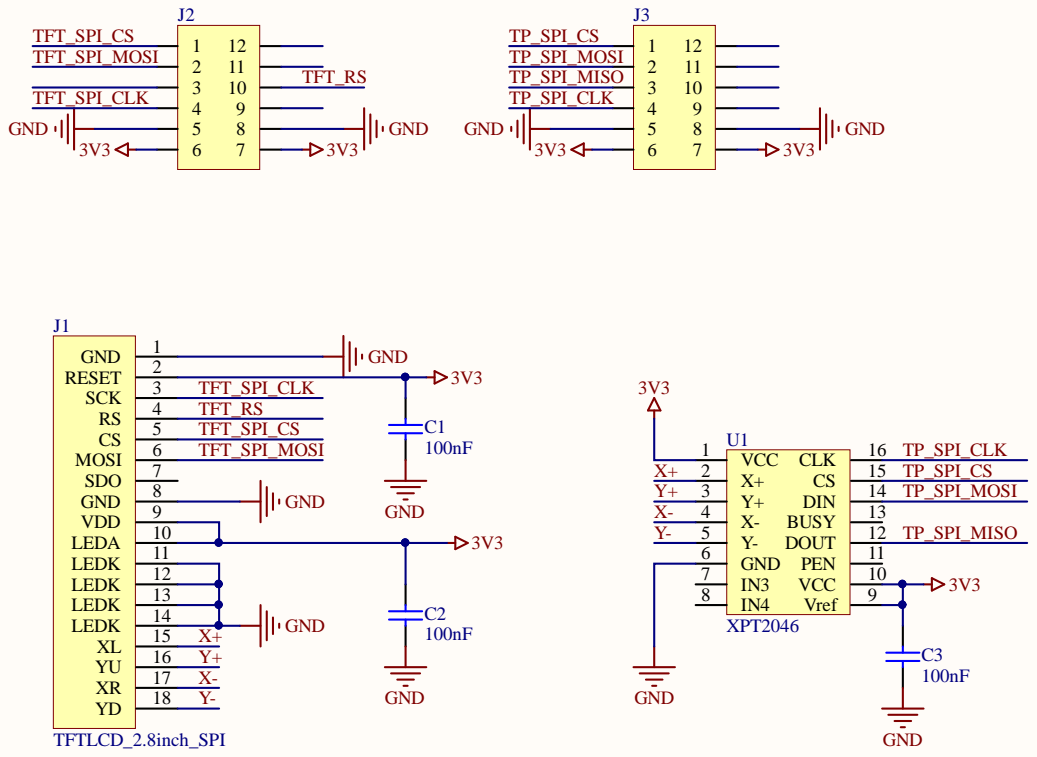
[picture p27: page 1]

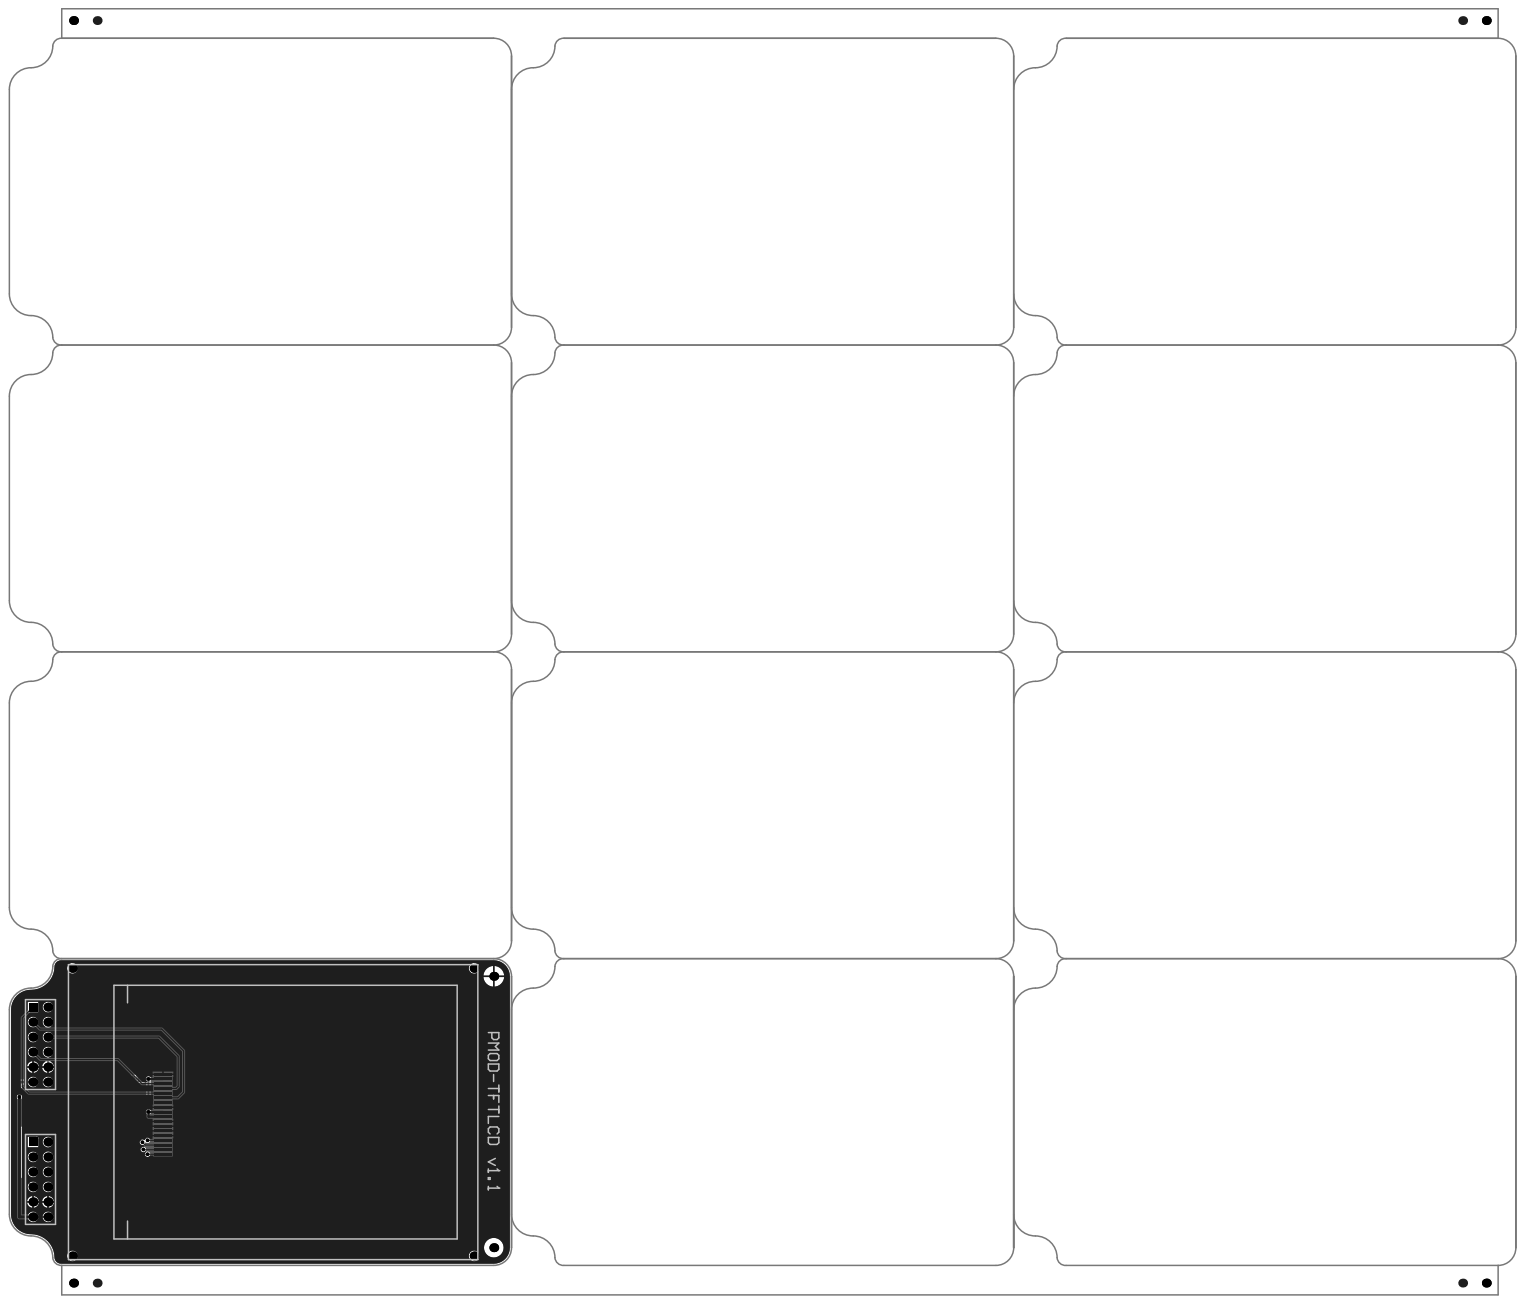
[picture p28: page 2]
