wuxx/icesugar/schematic/pmod-led-v1.1.pdf

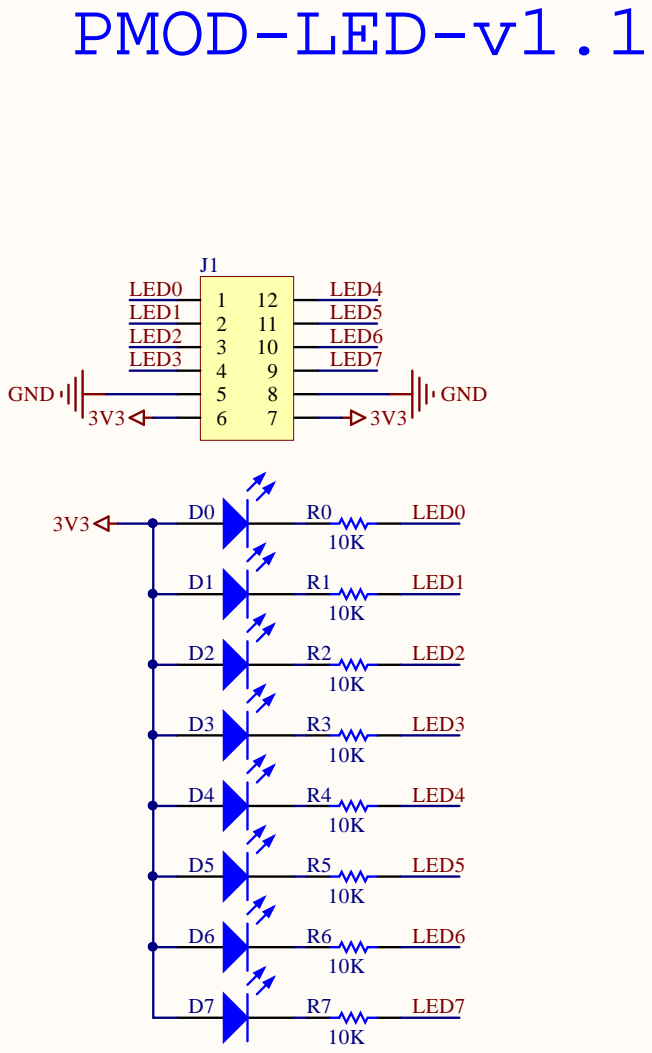
[picture p29: page 1]

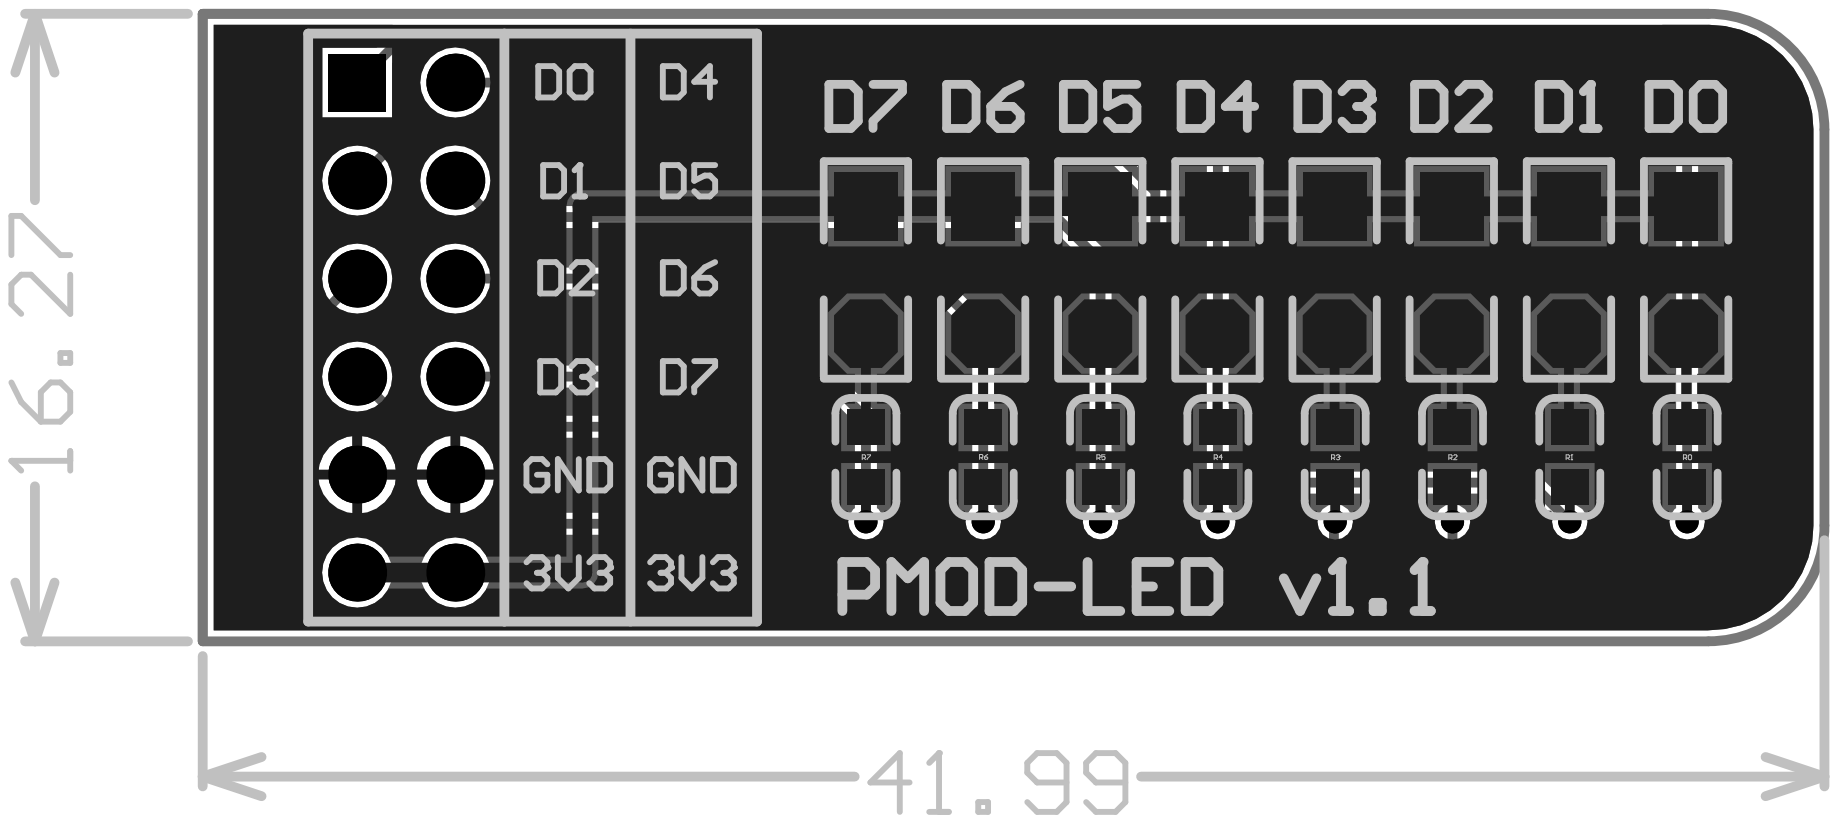
[picture p30: page 2]
