wuxx/icesugar/schematic/pmod-vga-v1.0.pdf

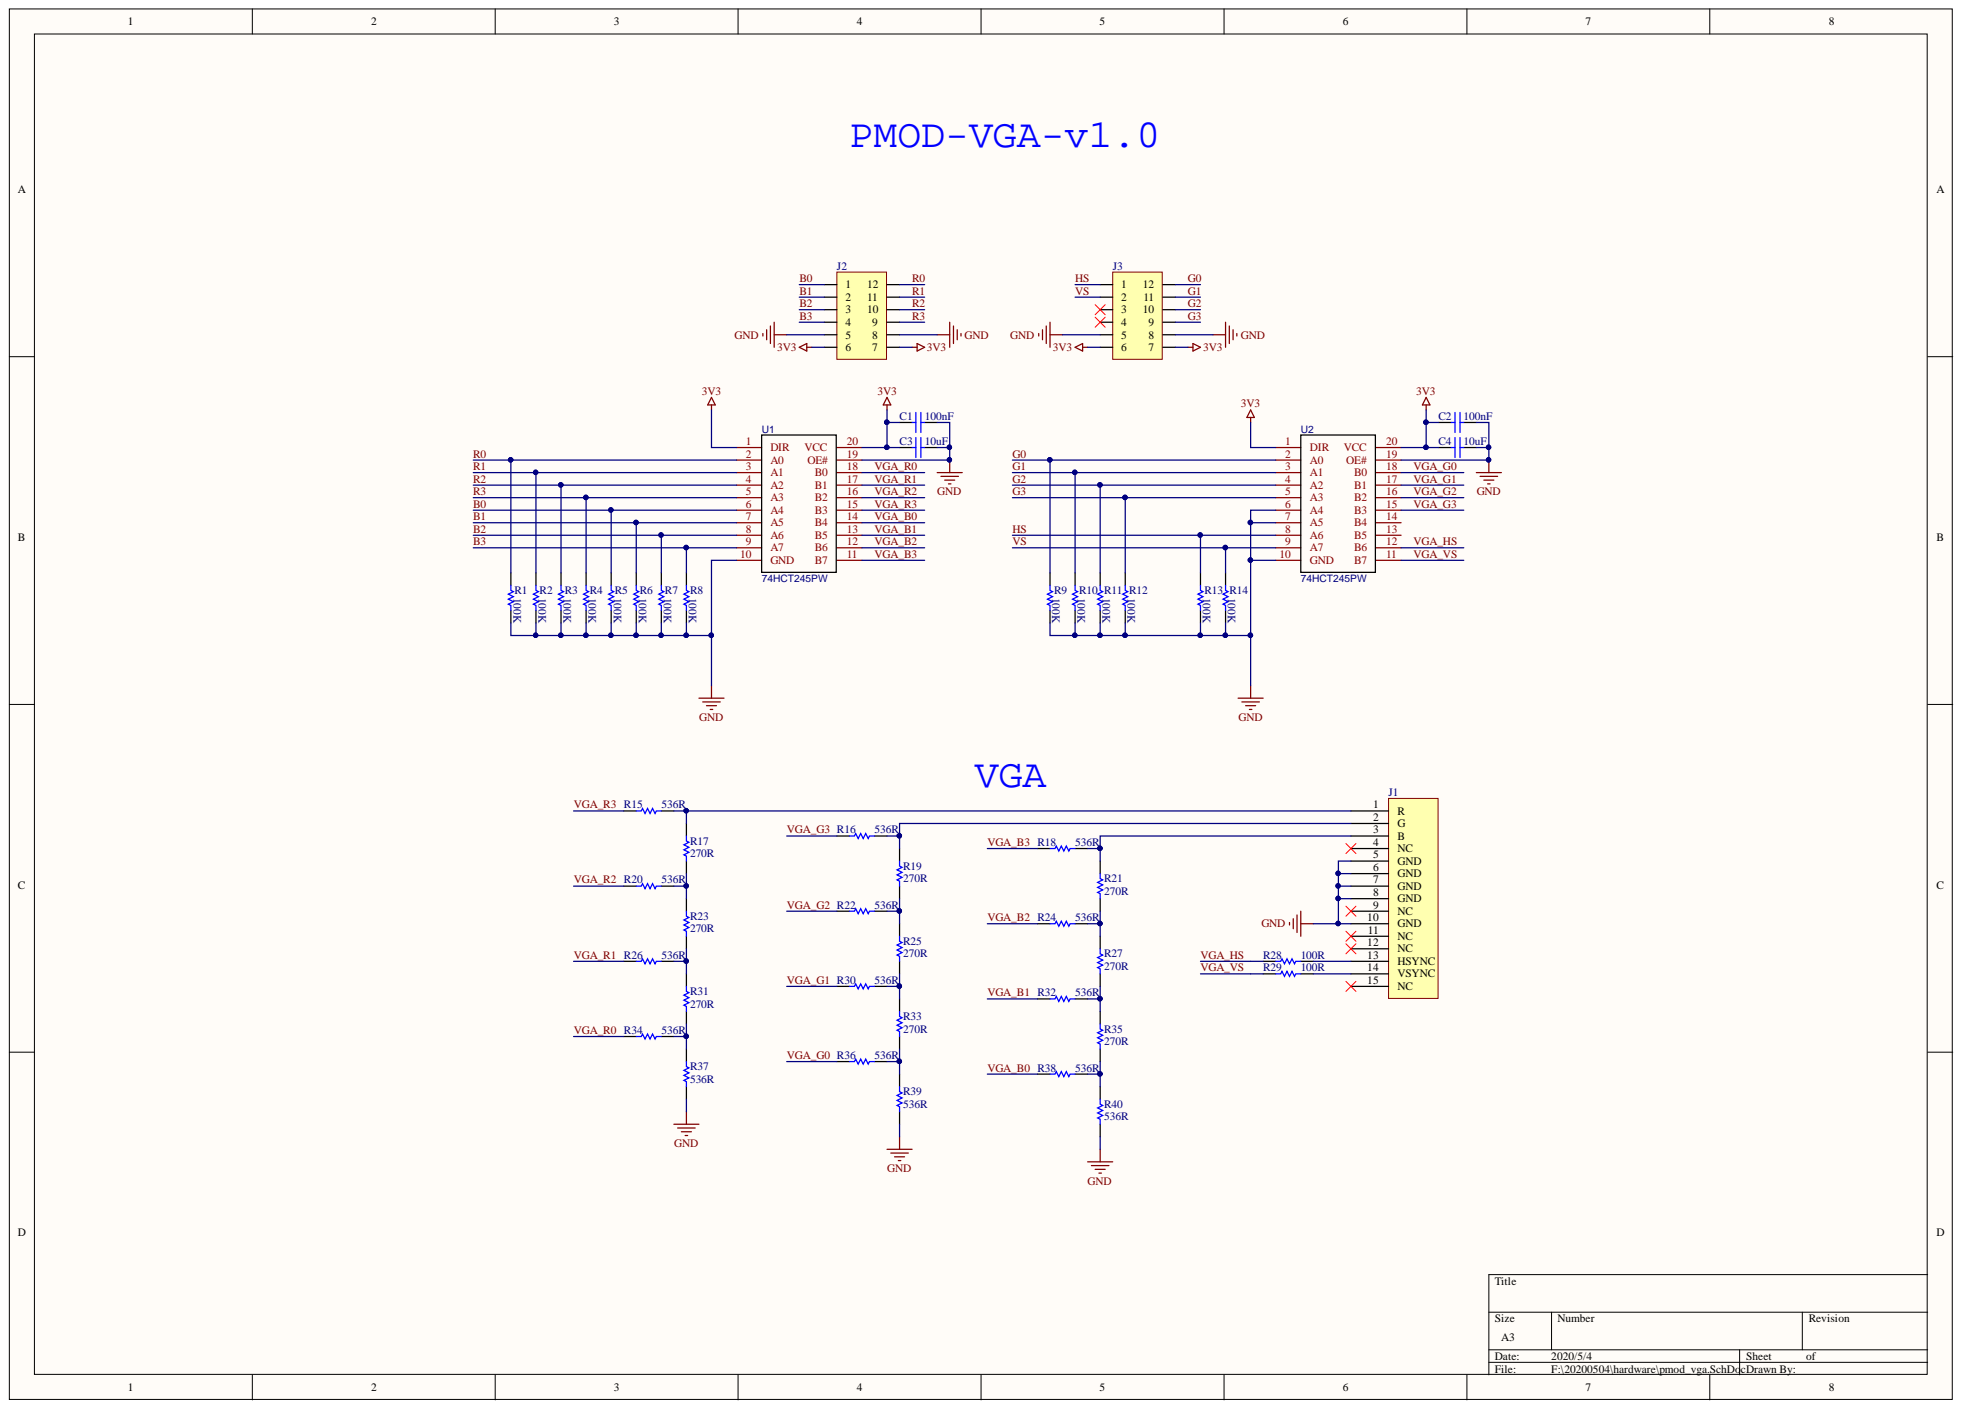
[picture p31: page 1]

G 2
B 3 NC 4

GND 5

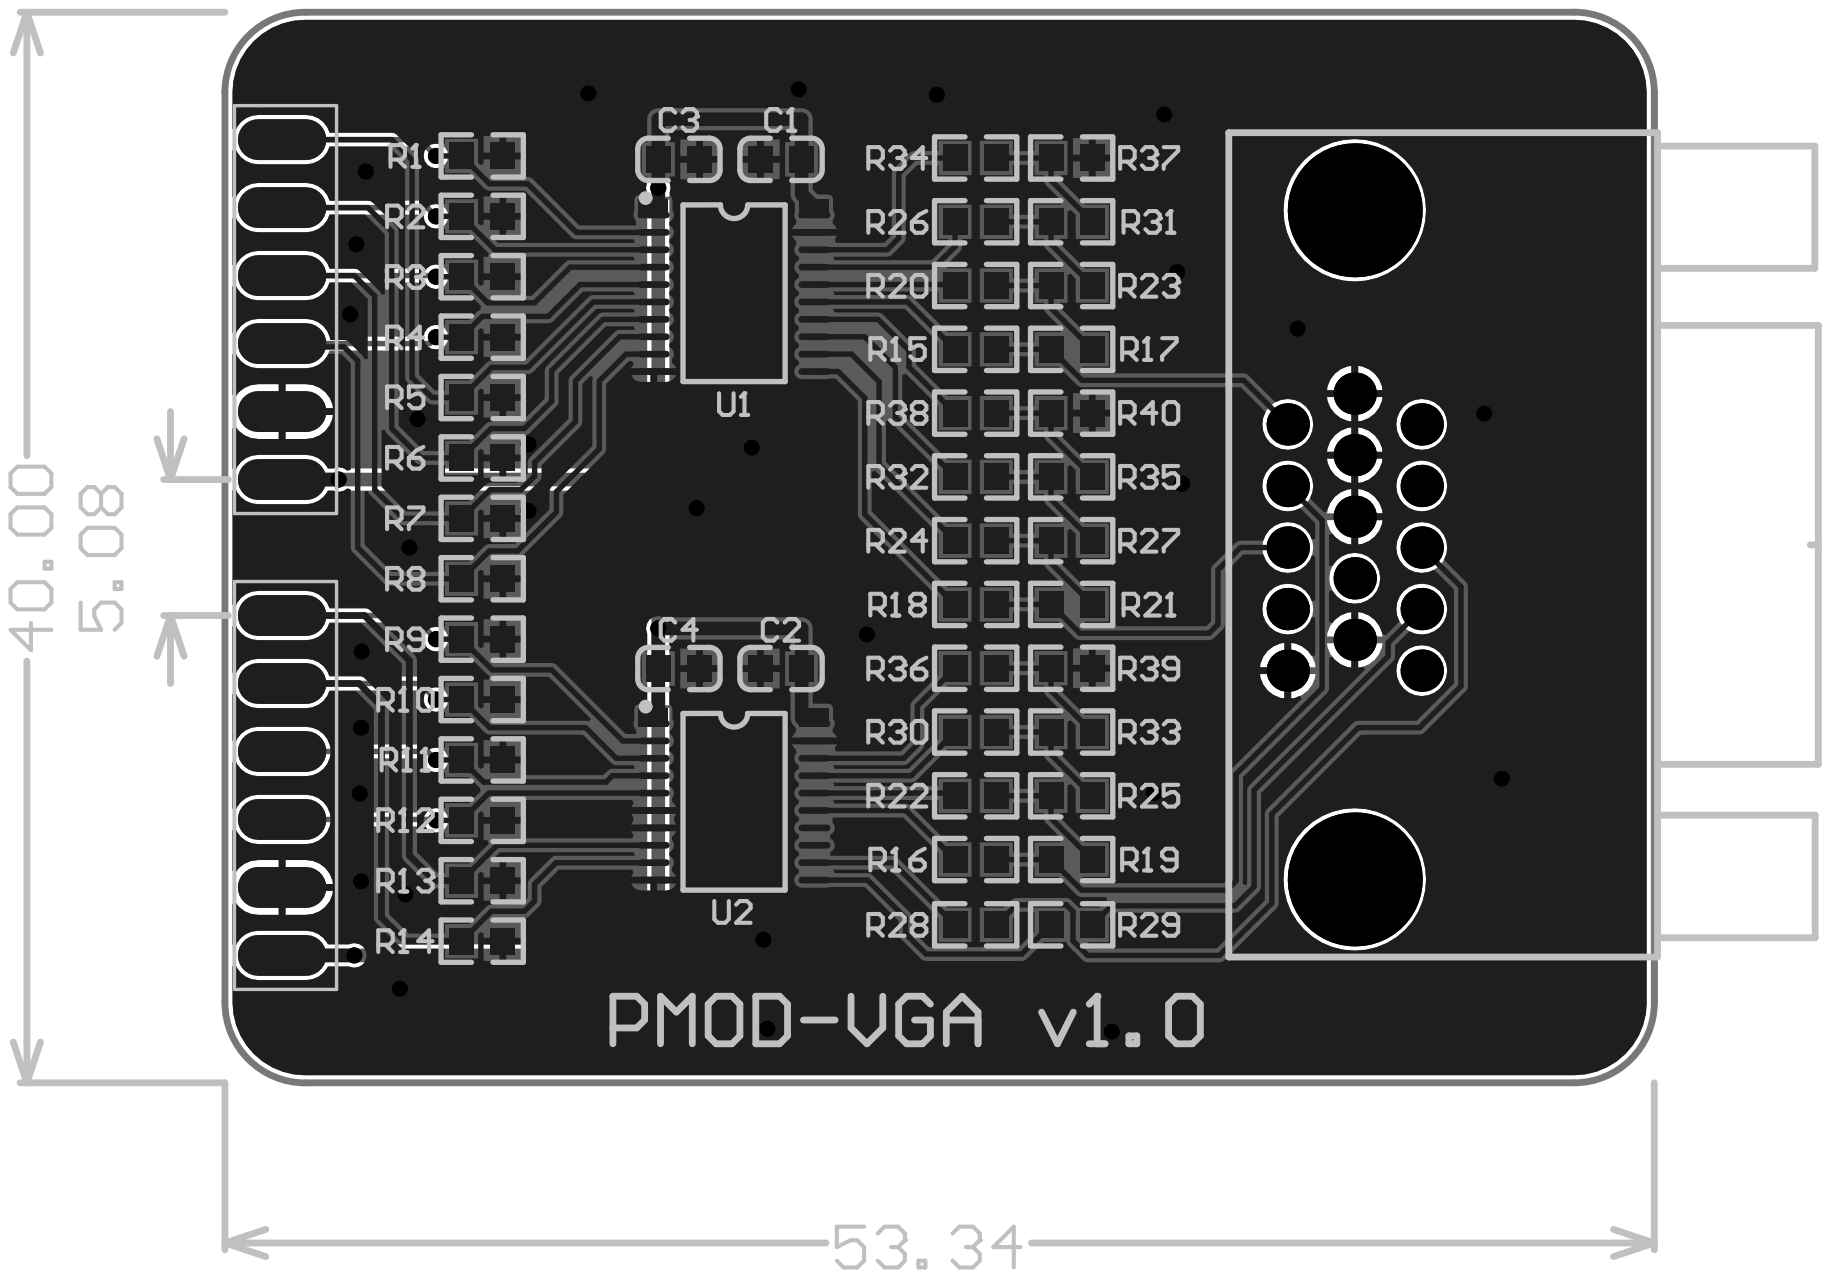
[picture p32: page 2]
