wuxx/icesugar/schematic/pmod-audio-v1.1.pdf

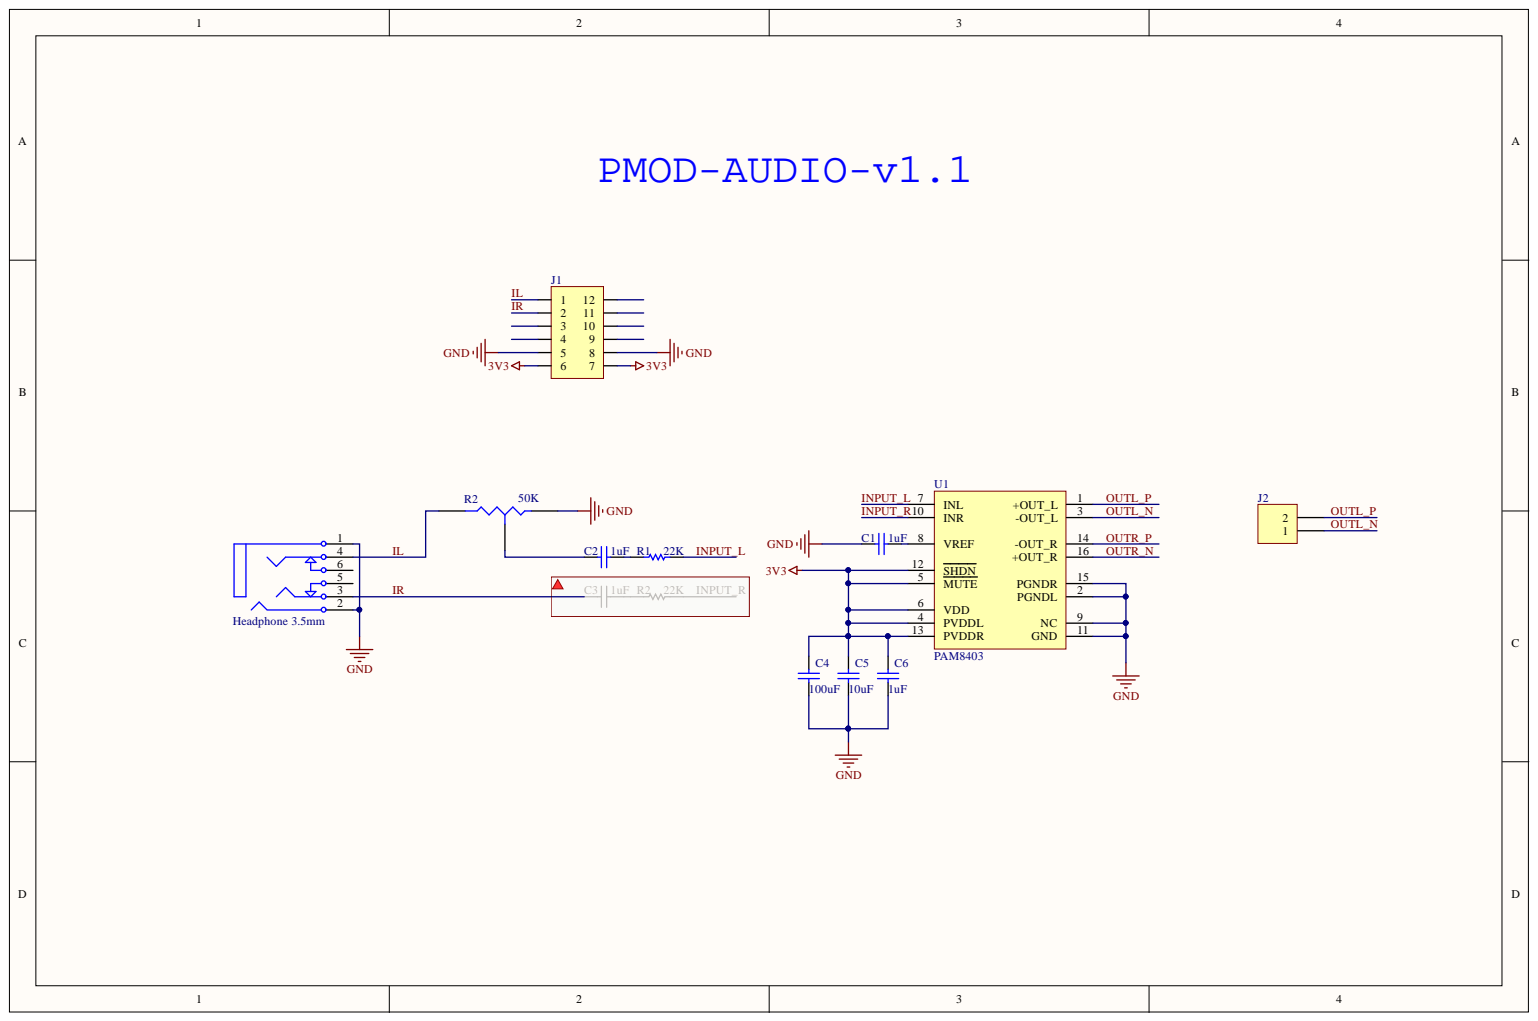
[picture p33: page 1]

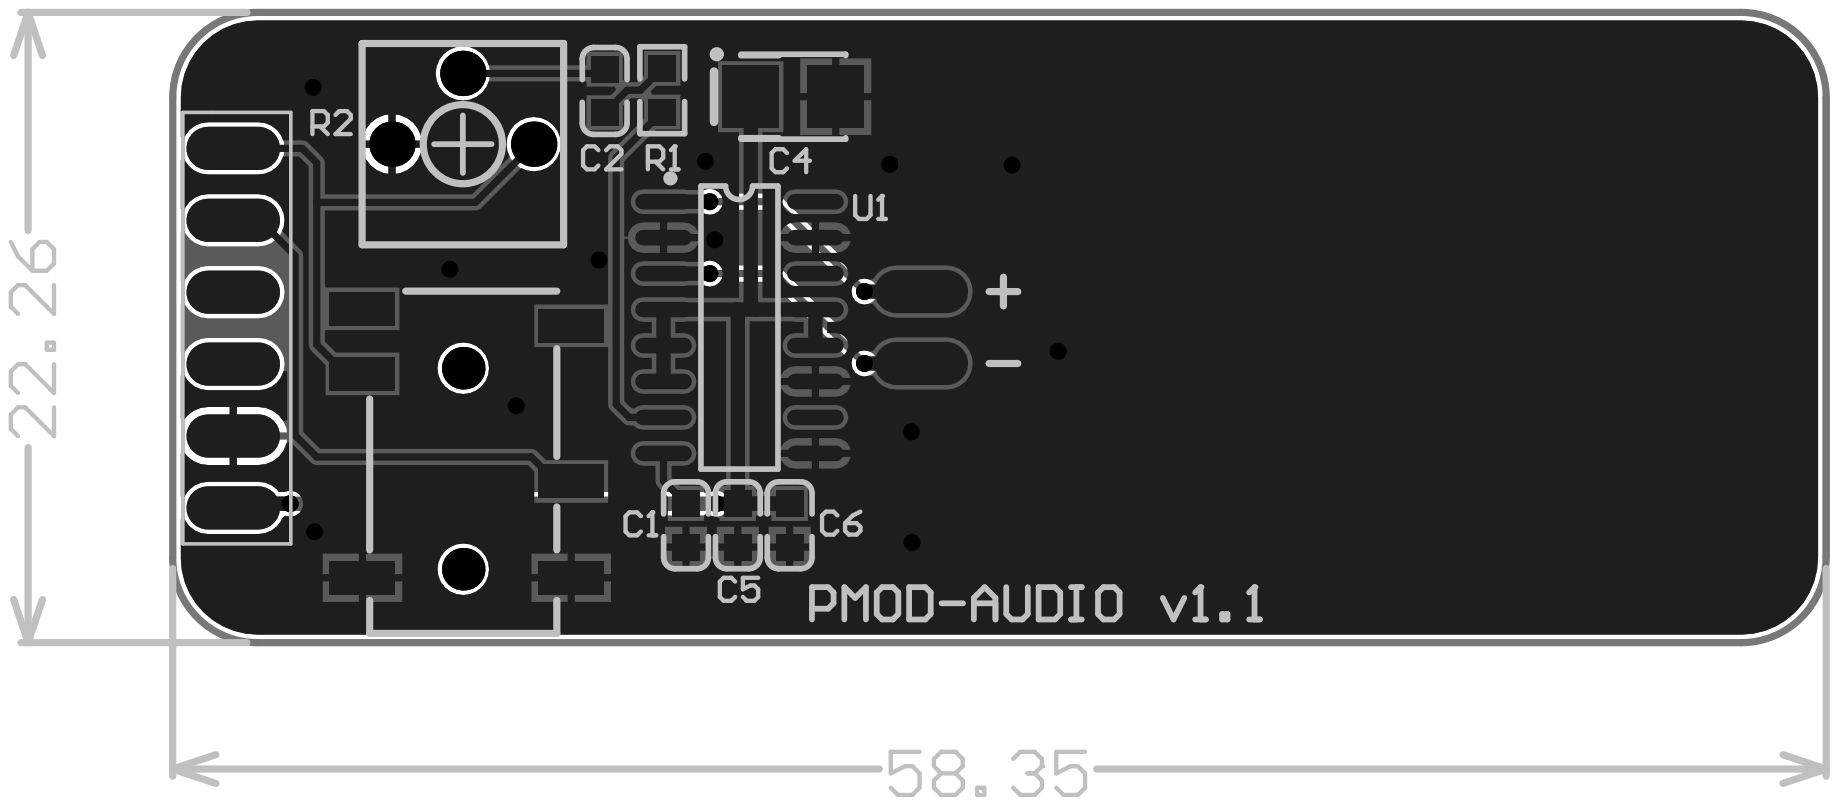
[picture p34: page 2]
