wuxx/icesugar/schematic/iCESugar-v1.4.pdf

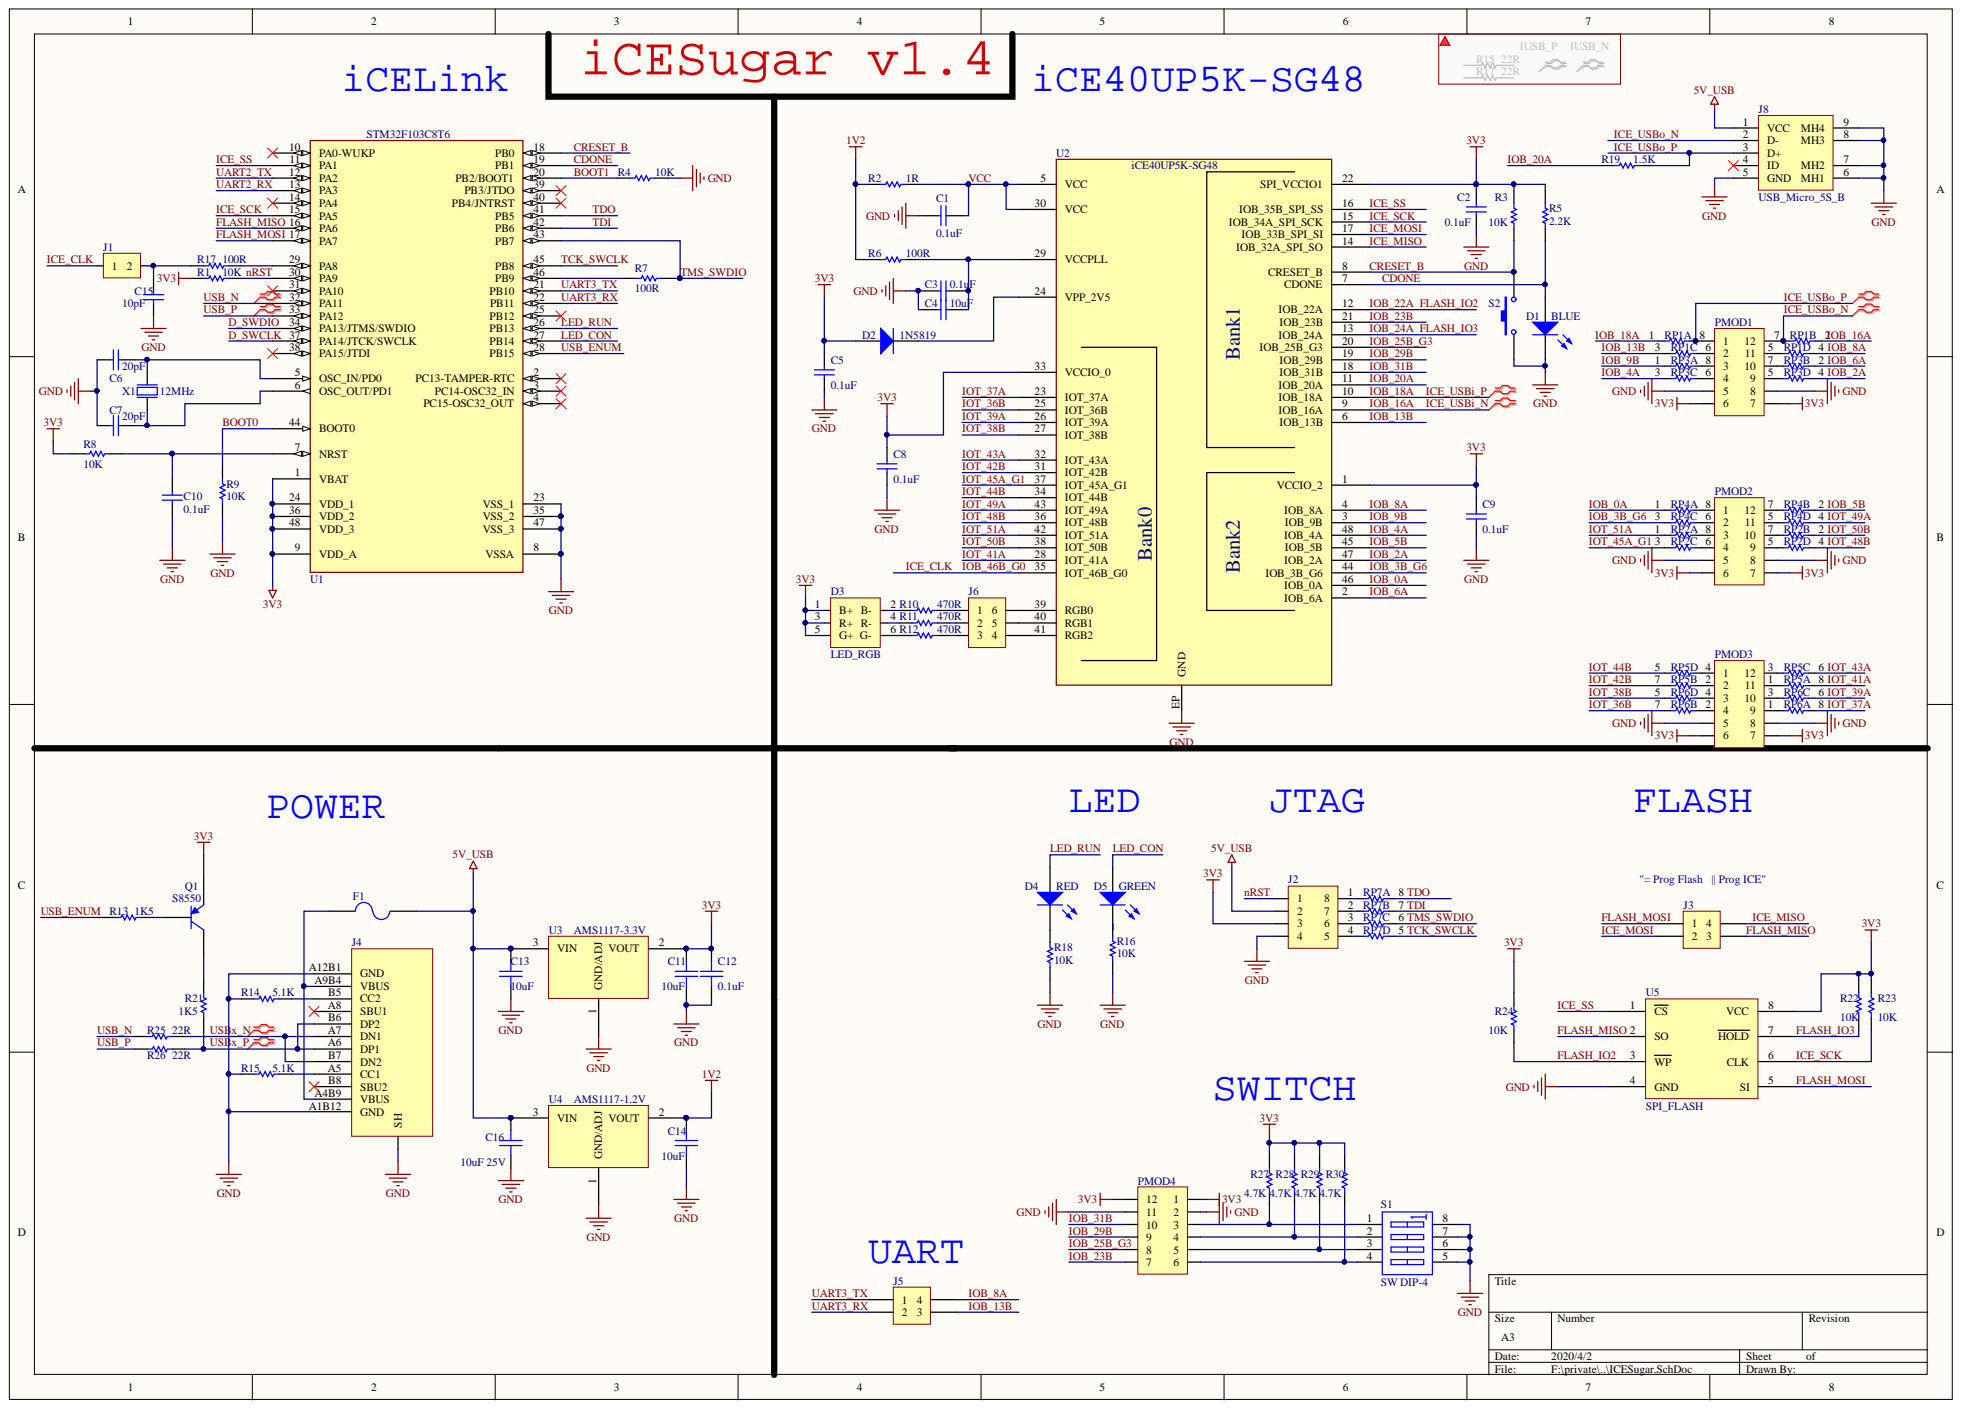
[picture p35: page 1]

"= Prog Flash || Prog ICE"
