wuxx/icesugar/src/basic/verilog/vga_rotate/top.v

// A simple demo of animation, VGA signal generation, and a rotation effect.
// Brandon Pelfrey
// Video at https://www.youtube.com/watch?v=Q7v7Moh8ltM
//
// I'm new to verilog. This code is probably awful.

module top(
  input clk_in,   // Onboard 12Mhz Oscillator
  output clk_out, // VGA Pixel Clock (not necessary)
  output r0,      // 1-bit VGA Red/Green/Blue
  output g0,
  output b0,
  output hsync,   // VGA H-Sync Signal
  output vsync);  // VGA V-Sync Signal

// VGA has a pixel clock which defines the time between 
// each consecutive pixel. For a given video mode, which is
// 640 x 480 @ 60 fps here, you need a specific pixel clock
// speed. In this case, 25.175 MHz. 'icepll -o 25.175' will
// determine the best coefficients in the PLL equation to
// get as close to this as possible (monitor is pretty
// tolerant to be slightly off).
SB_PLL40_PAD #(
  .FEEDBACK_PATH("SIMPLE"),
  .DIVR(4'b0000),
  .DIVF(7'b1000010),
  .DIVQ(3'b101),
  .FILTER_RANGE(3'b001)
) uut (
  .RESETB(1'b1),
  .BYPASS(1'b0),
  .PACKAGEPIN(clk_in),
  .PLLOUTCORE(clk_out)

);

// Some other constants for the VGA signal. Each line begins
// with actual image data, then an H-Sync front porch, pulse,
// and back porch, which are used for locking onto a signal at
// the monitor. A similar thing happens after the last line
// of color data: There are several lines forming a V-Sync
// front porch, pulse, and back porch.
parameter res_x = 640;
parameter res_y = 480;

parameter hfp = 16;      // horizontal front porch
parameter hpulse = 96;   // hsync pulse length
parameter hbp = 48;      // horizontal back porch

parameter vfp = 10;      // vertical front porch
parameter vpulse = 2;    // vsync pulse length
parameter vbp = 33;      // vertical back porch

parameter hpixels = res_x + hfp + hpulse + hbp; // horizontal pixels per line
parameter vlines  = res_y + vfp + vpulse + vbp; // vertical lines per frame

// Tiled image bitmap which composes the background image.
reg[0:7] tile_data[0:7];

// Some sine wave data which is indexed by position and frame number to
// produce distortions in how the tile data is indexed. The effect is that
// the tile data appears to move on screen, when in fact, the indexing is
// just being manipulated.
reg[7:0] line_shifts[63:0];

initial begin
  tile_data[0] <= 8'b10000001;
  tile_data[1] <= 8'b01000010;
  tile_data[2] <= 8'b00100100;
  tile_data[3] <= 8'b00011100;
  tile_data[4] <= 8'b00011000;
  tile_data[5] <= 8'b00100100;
  tile_data[6] <= 8'b01000010;
  tile_data[7] <= 8'b10000001;

  line_shifts[0] <= 8'd8;
  line_shifts[1] <= 8'd8;
  line_shifts[2] <= 8'd9;
  line_shifts[3] <= 8'd10;
  line_shifts[4] <= 8'd11;
  line_shifts[5] <= 8'd11;
  line_shifts[6] <= 8'd12;
  line_shifts[7] <= 8'd13;
  line_shifts[8] <= 8'd13;
  line_shifts[9] <= 8'd14;
  line_shifts[10] <= 8'd14;
  line_shifts[11] <= 8'd15;
  line_shifts[12] <= 8'd15;
  line_shifts[13] <= 8'd15;
  line_shifts[14] <= 8'd15;
  line_shifts[15] <= 8'd15;
  line_shifts[16] <= 8'd15;
  line_shifts[17] <= 8'd15;
  line_shifts[18] <= 8'd15;
  line_shifts[19] <= 8'd15;
  line_shifts[20] <= 8'd15;
  line_shifts[21] <= 8'd14;
  line_shifts[22] <= 8'd14;
  line_shifts[23] <= 8'd13;
  line_shifts[24] <= 8'd13;
  line_shifts[25] <= 8'd12;
  line_shifts[26] <= 8'd12;
  line_shifts[27] <= 8'd11;
  line_shifts[28] <= 8'd10;
  line_shifts[29] <= 8'd9;
  line_shifts[30] <= 8'd9;
  line_shifts[31] <= 8'd8;
  line_shifts[32] <= 8'd7;
  line_shifts[33] <= 8'd6;
  line_shifts[34] <= 8'd6;
  line_shifts[35] <= 8'd5;
  line_shifts[36] <= 8'd4;
  line_shifts[37] <= 8'd3;
  line_shifts[38] <= 8'd3;
  line_shifts[39] <= 8'd2;
  line_shifts[40] <= 8'd2;
  line_shifts[41] <= 8'd1;
  line_shifts[42] <= 8'd1;
  line_shifts[43] <= 8'd0;
  line_shifts[44] <= 8'd0;
  line_shifts[45] <= 8'd0;
  line_shifts[46] <= 8'd0;
  line_shifts[47] <= 8'd0;
  line_shifts[48] <= 8'd0;
  line_shifts[49] <= 8'd0;
  line_shifts[50] <= 8'd0;
  line_shifts[51] <= 8'd0;
  line_shifts[52] <= 8'd0;
  line_shifts[53] <= 8'd1;
  line_shifts[54] <= 8'd1;
  line_shifts[55] <= 8'd2;
  line_shifts[56] <= 8'd2;
  line_shifts[57] <= 8'd3;
  line_shifts[58] <= 8'd4;
  line_shifts[59] <= 8'd4;
  line_shifts[60] <= 8'd5;
  line_shifts[61] <= 8'd6;
  line_shifts[62] <= 8'd7;
  line_shifts[63] <= 8'd7;
end

// These are our horizontal and vertical positions on
// the screen at any moment (including fp/pulse/bp)
reg [12:0] pix_x;
reg [12:0] pix_y;

// Some state used to compute shifting for the tile data.
reg pix_reg;
reg[8:0] shift_x;
reg[5:0] shift_x_index;
reg[8:0] shift_y;
reg[5:0] shift_y_index;

// Which frame we're on. Used in animation.
reg[15:0] frame_counter = 0;

///////////////////////////////////////////////////////

// The image is rotated by computing rotated positions
//
// --- x' = c*x - s*y
// --- y' = s*x + c*y
//
// where c = cos(theta), s = sin(theta), and theta changes
// each frame.
//
// To avoid multiplication, these equations are mutliplied
// by B=2^k.
//
// --- B*x' = (B*c)*x - (B*s)*y
// --- B*y' = (B*s)*x + (B*c)*y
//
// We can avoid the multiply by simply keeping a running
// sum of each of B*c*x, B*s*y, B*s*x, and B*c*y. This way
// we only need to add constants as we advance the pixel
// one pixel to the right or one line down.
//
// When you need to know the actual (x',y'), you simply
// divide by B, but that's just a power of 2, so do an
// arithmetic right shift by k.
//

// cos(theta) and sin(theta) for 1024 divisions of a single
// rotation. Computed in a little python script.
reg signed[12:0] Cp[1023:0];
reg signed[12:0] Sp[1023:0];

initial begin
Cp[0] <= 11'd1024; Sp[0] <= 11'd0;
Cp[1] <= 11'd1023; Sp[1] <= 11'd6;
Cp[2] <= 11'd1023; Sp[2] <= 11'd12;
Cp[3] <= 11'd1023; Sp[3] <= 11'd18;
Cp[4] <= 11'd1023; Sp[4] <= 11'd25;
Cp[5] <= 11'd1023; Sp[5] <= 11'd31;
Cp[6] <= 11'd1023; Sp[6] <= 11'd37;
Cp[7] <= 11'd1023; Sp[7] <= 11'd44;
Cp[8] <= 11'd1022; Sp[8] <= 11'd50;
Cp[9] <= 11'd1022; Sp[9] <= 11'd56;
Cp[10] <= 11'd1022; Sp[10] <= 11'd62;
Cp[11] <= 11'd1021; Sp[11] <= 11'd69;
Cp[12] <= 11'd1021; Sp[12] <= 11'd75;
Cp[13] <= 11'd1020; Sp[13] <= 11'd81;
Cp[14] <= 11'd1020; Sp[14] <= 11'd87;
Cp[15] <= 11'd1019; Sp[15] <= 11'd94;
Cp[16] <= 11'd1019; Sp[16] <= 11'd100;
Cp[17] <= 11'd1018; Sp[17] <= 11'd106;
Cp[18] <= 11'd1017; Sp[18] <= 11'd112;
Cp[19] <= 11'd1017; Sp[19] <= 11'd119;
Cp[20] <= 11'd1016; Sp[20] <= 11'd125;
Cp[21] <= 11'd1015; Sp[21] <= 11'd131;
Cp[22] <= 11'd1014; Sp[22] <= 11'd137;
Cp[23] <= 11'd1013; Sp[23] <= 11'd144;
Cp[24] <= 11'd1012; Sp[24] <= 11'd150;
Cp[25] <= 11'd1011; Sp[25] <= 11'd156;
Cp[26] <= 11'd1010; Sp[26] <= 11'd162;
Cp[27] <= 11'd1009; Sp[27] <= 11'd169;
Cp[28] <= 11'd1008; Sp[28] <= 11'd175;
Cp[29] <= 11'd1007; Sp[29] <= 11'd181;
Cp[30] <= 11'd1006; Sp[30] <= 11'd187;
Cp[31] <= 11'd1005; Sp[31] <= 11'd193;
Cp[32] <= 11'd1004; Sp[32] <= 11'd199;
Cp[33] <= 11'd1003; Sp[33] <= 11'd206;
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
Cp[1009] <= 11'd1020; Sp[1009] <= -11'd87;
Cp[1010] <= 11'd1020; Sp[1010] <= -11'd81;
Cp[1011] <= 11'd1021; Sp[1011] <= -11'd75;
Cp[1012] <= 11'd1021; Sp[1012] <= -11'd69;
Cp[1013] <= 11'd1022; Sp[1013] <= -11'd62;
Cp[1014] <= 11'd1022; Sp[1014] <= -11'd56;
Cp[1015] <= 11'd1022; Sp[1015] <= -11'd50;
Cp[1016] <= 11'd1023; Sp[1016] <= -11'd44;
Cp[1017] <= 11'd1023; Sp[1017] <= -11'd37;
Cp[1018] <= 11'd1023; Sp[1018] <= -11'd31;
Cp[1019] <= 11'd1023; Sp[1019] <= -11'd25;
Cp[1020] <= 11'd1023; Sp[1020] <= -11'd18;
Cp[1021] <= 11'd1023; Sp[1021] <= -11'd12;
Cp[1022] <= 11'd1023; Sp[1022] <= -11'd6;
Cp[1023] <= 11'd1024; Sp[1023] <= -11'd0;

end

// Running sums for B* ( c*x, s*x, c*y, s*y )
reg signed [25:0] Cpx;
reg signed [25:0] Spx;
reg signed [25:0] Cpy;
reg signed [25:0] Spy;

// Actual x' and y'
wire [25:0] xp_divd = (Cpx - Spy) >>> 10;
wire [25:0] yp_divd = (Spx + Cpy) >>> 10;

// Index into the 
reg [9:0] theta_i = 0;

// Advance x,y based on pixel clock, update rotation sums,
// update frame counter, and update theta index each frame
always @(posedge clk_out)
begin
  if (pix_x < hpixels - 1) begin
    pix_x <= pix_x + 1;
    Cpx <= Cpx + Cp[theta_i];
    Spx <= Spx + Sp[theta_i];
  end
  else
  begin
    // Next line
    pix_x <= 0;
    Cpx <= 0;
    Spx <= 0;

    if (pix_y < vlines - 1) begin
      pix_y <= pix_y + 1;
      Cpy <= Cpy + Cp[theta_i];
      Spy <= Spy + Sp[theta_i];
    end

    else begin
      pix_y <= 0;
      Cpy <= 0;
      Spy <= 0;
      frame_counter <= frame_counter + 1;
      if (frame_counter[0])
        theta_i <= theta_i + 1;
      else
        theta_i <= theta_i;
    end
  end

  // Shift tile data (x,y) indexing by looking up line_shifts data
  // The divide by 4 is just to enlarge tiles which looks nice.
  //
  // (x,y) are not used, but rather (x',y') so rotation also occurs
  shift_x_index = yp_divd[5:0] + frame_counter[5:0];
  shift_x = (xp_divd[5:0] + 16 - line_shifts[ shift_x_index ]) / 4;
  shift_y_index = xp_divd[5:0] + frame_counter[5:0];
  shift_y = (yp_divd[5:0] + 16 - line_shifts[ shift_y_index ]) / 4;
  pix_reg = tile_data[ shift_y[2:0] ][ shift_x[2:0] ];
end

// In this video mode, hsync and vsync are active low when the pulse
// is supposed to take place
assign hsync = (pix_x >= (res_x+hfp) && pix_x < (res_x+hfp+hpulse)) ? 0 : 1;
assign vsync = (pix_y >= (res_y+vfp) && pix_y < (res_y+vfp+vpulse)) ? 0 : 1;

wire pix_on = pix_reg;

always @*
begin
  // first check if we're within vertical active video range
  if (pix_y < res_y && pix_x < res_x)
  begin
    // Some color variation in a kind of checkerboard pattern
    r0 <= (shift_y[3] ^ shift_x[3]) ? pix_on : 0;
    g0 <= ~(shift_y[3] ^ shift_x[3]) ? pix_on : 0;
    b0 <= (shift_y[4] ^ shift_x[4]) ? pix_on : 0;
  end
  else
  begin
    // If we're outside the visible frame, it's important to
    // actually set 0. (My monitor doesn't show anything otherwise)
    r0 <= 0;
    g0 <= 0;
    b0 <= 0;
  end
end

endmodule
