wuxx/icesugar/src/advanced/icicle/boards/icesugar.pcf

# 12 MHz clock
set_io -nowarn CLK        35

# RS232
set_io -nowarn uart_rx     4
set_io -nowarn uart_tx     6

# LEDs and Button
set_io -nowarn leds[0]    11
set_io -nowarn leds[1]    37
set_io -nowarn leds[2]    27
set_io -nowarn leds[3]    25
set_io -nowarn leds[4]    21
set_io -nowarn leds[5]    23
set_io -nowarn leds[6]    26
set_io -nowarn leds[7]    43

set_io -nowarn BTN_N      10

# RGB LED Driver
set_io -nowarn LED_RED_N  39
set_io -nowarn LED_GRN_N  40
set_io -nowarn LED_BLU_N  41

# SPI Flash
set_io -nowarn flash_clk  15
set_io -nowarn flash_csn  16
set_io -nowarn flash_io0  14
set_io -nowarn flash_io1  17
set_io -nowarn flash_io2  12
set_io -nowarn flash_io3  13

# PMOD 1A
set_io -nowarn P1A1        4
set_io -nowarn P1A2        2
set_io -nowarn P1A3       47
set_io -nowarn P1A4       45
set_io -nowarn P1A7        3
set_io -nowarn P1A8       48
set_io -nowarn P1A9       46
set_io -nowarn P1A10      44

# PMOD 1B
set_io -nowarn P1B1       43
set_io -nowarn P1B2       38
set_io -nowarn P1B3       34
set_io -nowarn P1B4       31
set_io -nowarn P1B7       42
set_io -nowarn P1B8       36
set_io -nowarn P1B9       32
set_io -nowarn P1B10      28

# PMOD 2
set_io -nowarn P2_1       27
set_io -nowarn P2_2       25
set_io -nowarn P2_3       21
set_io -nowarn P2_4       19
set_io -nowarn P2_7       26
set_io -nowarn P2_8       23
set_io -nowarn P2_9       20
set_io -nowarn P2_10      18

# LEDs and Buttons (PMOD 2)
set_io -nowarn BTN1       20
set_io -nowarn BTN2       19
set_io -nowarn BTN3       18
