wuxx/icesugar/src/advanced/icicle/rv32_control.sv

`ifndef RV32_CONTROL
`define RV32_CONTROL

`include "rv32_alu.sv"
`include "rv32_csrs.sv"
`include "rv32_branch.sv"
`include "rv32_imm.sv"
`include "rv32_mem.sv"
`include "rv32_opcodes.sv"

module rv32_control_unit (
    /* data in */
    input [31:0] instr_in,

    /* control in */
    input [4:0] rs1_in,
    input [4:0] rd_in,

    /* control out */
    output logic valid_out,
    output logic rs1_read_out,
    output logic rs2_read_out,
    output logic [2:0] imm_out,
    output logic [2:0] alu_op_out,
    output logic alu_sub_sra_out,
    output logic [1:0] alu_src1_out,
    output logic [1:0] alu_src2_out,
    output logic mem_read_out,
    output logic mem_write_out,
    output logic [1:0] mem_width_out,
    output logic mem_zero_extend_out,
    output logic mem_fence_out,
    output logic csr_read_out,
    output logic csr_write_out,
    output logic [1:0] csr_write_op_out,
    output logic csr_src_out,
    output logic [1:0] branch_op_out,
    output logic branch_pc_src_out,
    output logic ecall_out,
    output logic ebreak_out,
    output logic mret_out,
    output logic rd_write_out
);
    always_comb begin
        valid_out = 0;
        rs1_read_out = 0;
        rs2_read_out = 0;
        imm_out = 3'bx;
        alu_op_out = 3'bx;
        alu_sub_sra_out = 1'bx;
        alu_src1_out = 2'bx;
        alu_src2_out = 2'bx;
        mem_read_out = 0;
        mem_write_out = 0;
        mem_width_out = 2'bx;
        mem_zero_extend_out = 1'bx;
        mem_fence_out = 0;
        csr_read_out = 0;
        csr_write_out = 0;
        csr_write_op_out = 2'bx;
        csr_src_out = 1'bx;
        branch_op_out = `RV32_BRANCH_OP_NEVER;
        branch_pc_src_out = 1'bx;
        ecall_out = 0;
        ebreak_out = 0;
        mret_out = 0;
        rd_write_out = 0;

        casez (instr_in)
            `RV32_INSTR_LUI: begin
                valid_out = 1;
                imm_out = `RV32_IMM_U;
                alu_op_out = `RV32_ALU_OP_ADD_SUB;
                alu_sub_sra_out = 0;
                alu_src1_out = `RV32_ALU_SRC1_ZERO;
                alu_src2_out = `RV32_ALU_SRC2_IMM;
                rd_write_out = 1;
            end
            `RV32_INSTR_AUIPC: begin
                valid_out = 1;
                imm_out = `RV32_IMM_U;
                alu_op_out = `RV32_ALU_OP_ADD_SUB;
                alu_sub_sra_out = 0;
                alu_src1_out = `RV32_ALU_SRC1_PC;
                alu_src2_out = `RV32_ALU_SRC2_IMM;
                rd_write_out = 1;
            end
            `RV32_INSTR_JAL: begin
                valid_out = 1;
                imm_out = `RV32_IMM_J;
                alu_op_out = `RV32_ALU_OP_ADD_SUB;
                alu_sub_sra_out = 0;
                alu_src1_out = `RV32_ALU_SRC1_PC;
                alu_src2_out = `RV32_ALU_SRC2_FOUR;
                branch_op_out = `RV32_BRANCH_OP_ALWAYS;
                branch_pc_src_out = `RV32_BRANCH_PC_SRC_IMM;
                rd_write_out = 1;
            end
            `RV32_INSTR_JALR: begin
                valid_out = 1;
                rs1_read_out = 1;
                imm_out = `RV32_IMM_I;
                alu_op_out = `RV32_ALU_OP_ADD_SUB;
                alu_sub_sra_out = 0;
                alu_src1_out = `RV32_ALU_SRC1_PC;
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
                csr_src_out = `RV32_CSR_SRC_IMM;
                rd_write_out = 1;
            end
            `RV32_INSTR_CSRRCI: begin
                valid_out = 1;
                imm_out = `RV32_IMM_ZIMM;
                csr_read_out = 1;
                csr_write_out = |rs1_in;
                csr_write_op_out = `RV32_CSR_WRITE_OP_RC;
                csr_src_out = `RV32_CSR_SRC_IMM;
                rd_write_out = 1;
            end
        endcase
    end
endmodule

`endif
