wuxx/icesugar/src/advanced/picorv32/picosoc/icesugar.pcf

# 12 MHz clock
set_io clk        35

# RS232
set_io ser_rx      4
set_io ser_tx      6

# SPI Flash
set_io flash_clk  15
set_io flash_csb  16
set_io flash_io0  14
set_io flash_io1  17
set_io flash_io2  12
set_io flash_io3  13

# LEDs (PMOD 2)
set_io led1       27
set_io led2       25
set_io led3       21
set_io led4       23
set_io led5       26

# Onboard LEDs
set_io ledr_n     41
set_io ledg_n     40
