wuxx/icesugar/src/basic/verilog/pmod_leds/led.pcf

set_io CLK    35

set_io LED[0] 45
set_io LED[1] 43
set_io LED[2] 38
set_io LED[3] 36
set_io LED[4] 46
set_io LED[5] 44
set_io LED[6] 42
set_io LED[7] 37
