wuxx/icesugar/src/basic/verilog/uart_tx/top.v

`include "uart_tx.v"

/* baudrate: 9600 */
/* Top level module for keypad + UART demo */
module top (
    // input hardware clock (12 MHz)
    clk, 
    // all LEDs
    LED_R,
    // UART lines
    TX, 
    );

    /* Clock input */
    input clk;

    /* LED outputs */
    output LED_R;

    /* FTDI I/O */
    output TX;

    /* 9600 Hz clock generation (from 12 MHz) */
    reg clk_9600 = 0;
    reg [31:0] cntr_9600 = 32'b0;
    parameter period_9600 = 625;

    /* 1 Hz clock generation (from 12 MHz) */
    reg clk_1 = 0;
    reg [31:0] cntr_1 = 32'b0;
    parameter period_1 = 6000000;

    // Note: could also use "0" or "9" below, but I wanted to
    // be clear about what the actual binary value is.
    parameter ASCII_0 = 8'd48;
    parameter ASCII_9 = 8'd57;

    /* UART registers */
    reg [7:0] uart_txbyte = ASCII_0;
    reg uart_send = 1'b1;
    wire uart_txed;

    /* LED register */
    reg ledval = 0;

    /* UART transmitter module designed for
       8 bits, no parity, 1 stop bit. 
    */
    uart_tx_8n1 transmitter (
        // 9600 baud rate clock
        .clk (clk_9600),
        // byte to be transmitted
        .txbyte (uart_txbyte),
        // trigger a UART transmit on baud clock
        .senddata (uart_send),
        // input: tx is finished
        .txdone (uart_txed),
        // output UART tx pin
        .tx (TX),
    );

    /* Wiring */
    assign LED_R=ledval;
    
    /* Low speed clock generation */
    always @ (posedge clk) begin
        /* generate 9600 Hz clock */
        cntr_9600 <= cntr_9600 + 1;
        if (cntr_9600 == period_9600) begin
            clk_9600 <= ~clk_9600;
            cntr_9600 <= 32'b0;
        end

        /* generate 1 Hz clock */
        cntr_1 <= cntr_1 + 1;
        if (cntr_1 == period_1) begin
            clk_1 <= ~clk_1;
            cntr_1 <= 32'b0;
        end
    end

    /* Increment ASCII digit and blink LED */
    always @ (posedge clk_1 ) begin
        ledval <= ~ledval;
        if (uart_txbyte == ASCII_9) begin
            uart_txbyte <= ASCII_0;
        end else begin
            uart_txbyte <= uart_txbyte + 1;
        end
    end

endmodule
