wuxx/icesugar/src/basic/verilog/music4/music.v

// Music demo verilog file
// (c) fpga4fun.com 2003-2015

// Plays a little tune on a speaker
// Use a 25MHz clock if possible (other frequencies will 
// change the pitch/speed of the song)

/////////////////////////////////////////////////////
module music(
	input clk,
	output reg speaker
);

reg [30:0] tone;
reg [2:0] p0 = 0;

always @(posedge clk) 
begin
  p0 <= p0 + 1;
  if (p0 == 4)
  begin
    p0 <= 0;
    tone <= tone+31'd1;
  end
end

wire [7:0] fullnote;
music_ROM get_fullnote(.clk(clk), .address(tone[29:22]), .note(fullnote));

wire [2:0] octave;
wire [3:0] note;
divide_by12 get_octave_and_note(.numerator(fullnote[5:0]), .quotient(octave), .remainder(note));

reg [10:0] clkdivider;
always @*
begin
  case(note)
	 0: clkdivider = 9'd511;//A
	 1: clkdivider = 9'd482;// A#/Bb
	 2: clkdivider = 9'd455;//B
	 3: clkdivider = 9'd430;//C
	 4: clkdivider = 9'd405;// C#/Db
	 5: clkdivider = 9'd383;//D
	 6: clkdivider = 9'd361;// D#/Eb
	 7: clkdivider = 9'd341;//E
	 8: clkdivider = 9'd322;//F
	 9: clkdivider = 9'd303;// F#/Gb
	10: clkdivider = 9'd286;//G
	11: clkdivider = 9'd270;// G#/Ab
	default: clkdivider = 9'd0;
  endcase
  clkdivider <= clkdivider << 2;
end

reg [10:0] counter_note;
reg [9:0] counter_octave;
always @(posedge clk) counter_note <= counter_note==0 ? clkdivider : counter_note-11'd1;
always @(posedge clk) if(counter_note==0) counter_octave <= counter_octave==0 ? 10'd255 >> octave : counter_octave-10'd1;
always @(posedge clk) if(counter_note==0 && counter_octave==0 && fullnote!=0 && tone[21:18]!=0) speaker <= ~speaker;
endmodule


/////////////////////////////////////////////////////
module divide_by12(
	input [5:0] numerator,  // value to be divided by 12
	output reg [2:0] quotient, 
	output [3:0] remainder
);

reg [1:0] remainder3to2;
always @(numerator[5:2])
case(numerator[5:2])
	 0: begin quotient=0; remainder3to2=0; end
	 1: begin quotient=0; remainder3to2=1; end
	 2: begin quotient=0; remainder3to2=2; end
	 3: begin quotient=1; remainder3to2=0; end
	 4: begin quotient=1; remainder3to2=1; end
	 5: begin quotient=1; remainder3to2=2; end
	 6: begin quotient=2; remainder3to2=0; end
	 7: begin quotient=2; remainder3to2=1; end
	 8: begin quotient=2; remainder3to2=2; end
	 9: begin quotient=3; remainder3to2=0; end
	10: begin quotient=3; remainder3to2=1; end
	11: begin quotient=3; remainder3to2=2; end
	12: begin quotient=4; remainder3to2=0; end
	13: begin quotient=4; remainder3to2=1; end
	14: begin quotient=4; remainder3to2=2; end
	15: begin quotient=5; remainder3to2=0; end
endcase

assign remainder[1:0] = numerator[1:0];  // the first 2 bits are copied through
assign remainder[3:2] = remainder3to2;  // and the last 2 bits come from the case statement
endmodule
/////////////////////////////////////////////////////


module music_ROM(
	input clk,
	input [7:0] address,
	output reg [7:0] note
);

always @(posedge clk)
case(address)
	  0: note<= 8'd25;
	  1: note<= 8'd27;
	  2: note<= 8'd27;
	  3: note<= 8'd25;
	  4: note<= 8'd22;
	  5: note<= 8'd22;
	  6: note<= 8'd30;
	  7: note<= 8'd30;
	  8: note<= 8'd27;
	  9: note<= 8'd27;
	 10: note<= 8'd25;
	 11: note<= 8'd25;
	 12: note<= 8'd25;
	 13: note<= 8'd25;
	 14: note<= 8'd25;
	 15: note<= 8'd25;
	 16: note<= 8'd25;
	 17: note<= 8'd27;
	 18: note<= 8'd25;
	 19: note<= 8'd27;
	 20: note<= 8'd25;
	 21: note<= 8'd25;
	 22: note<= 8'd30;
	 23: note<= 8'd30;
	 24: note<= 8'd29;
	 25: note<= 8'd29;
	 26: note<= 8'd29;
	 27: note<= 8'd29;
	 28: note<= 8'd29;
	 29: note<= 8'd29;
	 30: note<= 8'd29;
	 31: note<= 8'd29;
	 32: note<= 8'd23;
	 33: note<= 8'd25;
	 34: note<= 8'd25;
	 35: note<= 8'd23;
	 36: note<= 8'd20;
	 37: note<= 8'd20;
	 38: note<= 8'd29;
	 39: note<= 8'd29;
	 40: note<= 8'd27;
	 41: note<= 8'd27;
	 42: note<= 8'd25;
	 43: note<= 8'd25;
	 44: note<= 8'd25;
	 45: note<= 8'd25;
	 46: note<= 8'd25;
	 47: note<= 8'd25;
	 48: note<= 8'd25;
	 49: note<= 8'd27;
	 50: note<= 8'd25;
	 51: note<= 8'd27;
	 52: note<= 8'd25;
	 53: note<= 8'd25;
	 54: note<= 8'd27;
	 55: note<= 8'd27;
	 56: note<= 8'd22;
	 57: note<= 8'd22;
	 58: note<= 8'd22;
	 59: note<= 8'd22;
	 60: note<= 8'd22;
	 61: note<= 8'd22;
	 62: note<= 8'd22;
	 63: note<= 8'd22;
	 64: note<= 8'd25;
	 65: note<= 8'd27;
	 66: note<= 8'd27;
	 67: note<= 8'd25;
	 68: note<= 8'd22;
	 69: note<= 8'd22;
	 70: note<= 8'd30;
	 71: note<= 8'd30;
	 72: note<= 8'd27;
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
	233: note<= 8'd27;
	234: note<= 8'd25;
	235: note<= 8'd25;
	236: note<= 8'd25;
	237: note<= 8'd25;
	238: note<= 8'd25;
	239: note<= 8'd25;
	240: note<= 8'd25;
	241: note<= 8'd0;
	242: note<= 8'd00;
	default: note <= 8'd0;
endcase
endmodule

/////////////////////////////////////////////////////
