wuxx/icesugar/src/advanced/icicle/clk_div.sv

`ifndef CLK_DIV
`define CLK_DIV

module clk_div #(
    parameter LOG_DIVISOR = 1
) (
    input clk_in,
    output logic clk_out
);
    logic [LOG_DIVISOR-1:0] q;

    initial q = 0;

    always_ff @(posedge clk_in)
        q <= q + 1;

    assign clk_out = q[LOG_DIVISOR-1];
endmodule

`endif
