wuxx/icesugar/src/advanced/icicle/rv32_alu.sv

`ifndef RV32_ALU
`define RV32_ALU

`define RV32_ALU_OP_ADD_SUB 3'b000
`define RV32_ALU_OP_XOR     3'b001
`define RV32_ALU_OP_OR      3'b010
`define RV32_ALU_OP_AND     3'b011
`define RV32_ALU_OP_SLL     3'b100
`define RV32_ALU_OP_SRL_SRA 3'b101
`define RV32_ALU_OP_SLT     3'b110
`define RV32_ALU_OP_SLTU    3'b111

`define RV32_ALU_SRC1_REG  2'b00
`define RV32_ALU_SRC1_PC   2'b01
`define RV32_ALU_SRC1_ZERO 2'b10

`define RV32_ALU_SRC2_REG  2'b00
`define RV32_ALU_SRC2_IMM  2'b01
`define RV32_ALU_SRC2_FOUR 2'b10

module rv32_alu (
    /* control in */
    input [2:0] op_in,
    input sub_sra_in,
    input [1:0] src1_in,
    input [1:0] src2_in,

    /* data in */
    input [31:0] pc_in,
    input [31:0] rs1_value_in,
    input [31:0] rs2_value_in,
    input [31:0] imm_value_in,

    /* data out */
    output logic [31:0] result_out
);
    logic [31:0] src1;
    logic [31:0] src2;

    logic src1_sign;
    logic src2_sign;

    logic [4:0] shamt;

    logic [32:0] add_sub;
    logic [31:0] srl_sra;

    logic carry;
    logic sign;
    logic ovf;

    logic lt;
    logic ltu;

    always_comb begin
        case (src1_in)
            `RV32_ALU_SRC1_REG:  src1 = rs1_value_in;
            `RV32_ALU_SRC1_PC:   src1 = pc_in;
            `RV32_ALU_SRC1_ZERO: src1 = 0;
            default:             src1 = 32'bx;
        endcase

        case (src2_in)
            `RV32_ALU_SRC2_REG:  src2 = rs2_value_in;
            `RV32_ALU_SRC2_IMM:  src2 = imm_value_in;
            `RV32_ALU_SRC2_FOUR: src2 = 4;
            default:             src2 = 32'bx;
        endcase
    end

    assign src1_sign = src1[31];
    assign src2_sign = src2[31];

    assign shamt = src2[4:0];

    assign add_sub = sub_sra_in ? src1 - src2 : src1 + src2;
    assign srl_sra = $signed({sub_sra_in ? src1_sign : 1'b0, src1}) >>> shamt;

    assign carry = add_sub[32];
    assign sign  = add_sub[31];
    assign ovf   = (!src1_sign && src2_sign && sign) || (src1_sign && !src2_sign && !sign);

    assign lt  = sign != ovf;
    assign ltu = carry;

    always_comb begin
        case (op_in)
            `RV32_ALU_OP_ADD_SUB: result_out = add_sub[31:0];
            `RV32_ALU_OP_XOR:     result_out = src1 ^ src2;
            `RV32_ALU_OP_OR:      result_out = src1 | src2;
            `RV32_ALU_OP_AND:     result_out = src1 & src2;
            `RV32_ALU_OP_SLL:     result_out = src1 << shamt;
            `RV32_ALU_OP_SRL_SRA: result_out = srl_sra;
            `RV32_ALU_OP_SLT:     result_out = {31'b0, lt};
            `RV32_ALU_OP_SLTU:    result_out = {31'b0, ltu};
        endcase
    end
endmodule

`endif
