wuxx/icesugar/src/advanced/icicle/rv32_regs.sv

`ifndef RV32_REGS
`define RV32_REGS

module rv32_regs (
    input clk,
    input stall_in,
    input writeback_flush_in,

    /* control in */
    input [4:0] rs1_in,
    input [4:0] rs2_in,
    input [4:0] rd_in,
    input rd_write_in,

    /* data in */
    input [31:0] rd_value_in,

    /* data out */
    output logic [31:0] rs1_value_out,
    output logic [31:0] rs2_value_out
);
    logic [31:0] regs [31:0];
    logic [4:0] rs1;
    logic [4:0] rs2;

    generate
        genvar i;
        for (i = 0; i < 32; i = i+1) begin
            initial
                regs[i] <= 0;
        end
    endgenerate

    assign rs1_value_out = regs[rs1];
    assign rs2_value_out = regs[rs2];

    always_ff @(posedge clk) begin
        if (!stall_in) begin
            rs1 <= rs1_in;
            rs2 <= rs2_in;
        end

        if (!writeback_flush_in && rd_write_in && |rd_in)
            regs[rd_in] <= rd_value_in;
    end
endmodule

`endif
