wuxx/icesugar/src/advanced/icicle/sync.sv

`ifndef SYNC
`define SYNC

module sync #(
    parameter BITS = 1
) (
    input clk,
    input [BITS-1:0] in,
    output logic [BITS-1:0] out
);
    logic [BITS-1:0] metastable;

    initial begin
        metastable <= 0;
        out <= 0;
    end

    always_ff @(posedge clk) begin
        metastable <= in;
        out <= metastable;
    end
endmodule

`endif
