wuxx/icesugar/src/basic/verilog/dsp/calc_dsp.v

module calc_dsp(input clk, output correct);
   reg [3:0] state;
   reg out_val;

   assign correct = out_val;
   reg dsp_ce;
   reg [15:0] dsp_c;
   reg [15:0] dsp_a;
   reg [15:0] dsp_b;
   reg [15:0] dsp_d;
   reg dsp_irsttop;
   reg dsp_irstbot;
   reg dsp_orsttop;
   reg dsp_orstbot;
   reg dsp_ahold;
   reg dsp_bhold;
   reg dsp_chold;
   reg dsp_dhold;
   reg dsp_oholdtop;
   reg dsp_oholdbot;
   reg dsp_addsubtop;
   reg dsp_addsubbot;
   reg dsp_oloadtop;
   reg dsp_oloadbot;
   reg dsp_ci;

   wire [31:0] dsp_o;
   wire dsp_co;

   //setup the dsp, parameters TOPADDSUB_LOWERINPUT and BOTADDSUB_LOWERINPUT at 2 means we can use MAC operations
   SB_MAC16 #(.C_REG(0), .A_REG(0), .B_REG(0), .D_REG(0), .TOP_8x8_MULT_REG(0), .BOT_8x8_MULT_REG(0),
            .PIPELINE_16x16_MULT_REG1(0), .PIPELINE_16x16_MULT_REG2(0), .TOPOUTPUT_SELECT(0), .TOPADDSUB_LOWERINPUT(2),
            .TOPADDSUB_UPPERINPUT(0), .TOPADDSUB_CARRYSELECT(0), .BOTOUTPUT_SELECT(0), .BOTADDSUB_LOWERINPUT(2), .BOTADDSUB_UPPERINPUT(0),
            .BOTADDSUB_CARRYSELECT(0), .MODE_8x8(0), .A_SIGNED(0), .B_SIGNED(0))
   SB_MAC16_inst(
      .CLK(clk), .CE(dsp_ce), .C(dsp_c), .A(dsp_a), .B(dsp_b), .D(dsp_d),
      .IRSTTOP(dsp_irsttop), .IRSTBOT(dsp_irstbot), .ORSTTOP(dsp_orsttop), .ORSTBOT(dsp_orstbot),
      .AHOLD(dsp_ahold), .BHOLD(dsp_bhold), .CHOLD(dsp_chold), .DHOLD(dsp_dhold), .OHOLDTOP(dsp_oholdtop), .OHOLDBOT(dsp_oholdbot),
      .ADDSUBTOP(dsp_addsubtop), .ADDSUBBOT(dsp_addsubbot), .OLOADTOP(dsp_oloadtop), .OLOADBOT(dsp_oloadbot),
      .CI(dsp_ci), .O(dsp_o), .CO(dsp_co)
   );

   initial begin
      state = 0;
      out_val = 0;
      dsp_ce = 1;
   end

   always @(posedge clk)
   begin
      //default for the dsp
      dsp_ce <= 1;
      dsp_c <= 0;
      dsp_a <= 0;
      dsp_b <= 0;
      dsp_d <= 0;
      dsp_irsttop <= 0;
      dsp_irstbot <= 0;
      dsp_orsttop <= 0;
      dsp_orstbot <= 0;
      dsp_ahold <= 0;
      dsp_bhold <= 0;
      dsp_chold <= 0;
      dsp_dhold <= 0;
      dsp_oholdtop <= 0;
      dsp_oholdbot <= 0;
      dsp_addsubtop <= 0;
      dsp_addsubbot <= 0;
      dsp_oloadtop <= 0;
      dsp_oloadbot <= 0;
      dsp_ci <= 0;

      if(state < 15)
      begin
         state <= state + 1;
      end

      case (state)
      0: begin // a <- 127
         dsp_d <= 127;
         dsp_oloadbot <= 1; //load in accumulator for bottom (lowest 16bits)
      end
      1: begin // a <- 127 + (127*5)
         dsp_a <= dsp_o[15:0];
         dsp_b <= 5;
      end
      2: begin // a <- 762 + (762*762)
         dsp_a <= dsp_o[15:0];
         dsp_b <= dsp_o[15:0];
      end
      3: begin
         if(dsp_o[31:0] == 581406)
         begin
            out_val <= 1;
         end
      end
      default: begin
      end
      endcase

   end
endmodule
