wuxx/icesugar/(commit log)

2020-03-20 commit icesprog.arm
2020-04-02 commit iCESugar schematic v1.4
2020-04-13 add SpinalHDL leds demo
2020-04-14 update basic directory framework
2020-05-04 udpate schematic of pmod_vga & pmod_audio & pmod_led
2020-06-05 commit schematic/pmod_tftlcd-v1.1.pdf
2020-06-17 commit iCESugar-v1.5 schematic adjust board size for PMOD DUAL-IO
2020-07-21 update schematic of pmod_audio & pmod_switch
2020-08-29 Added RGB PWM hard IP example
2020-08-29 Improved documentation for RGB PWM hard IP
2020-10-01 Made LED constraints more sensible
2020-11-22 icesprog: avoid crashes due to unsupported options
    [icesprog.c]
2020-11-22 icesprog: use O_BINARY flag (fix #14)
    [icesprog.c]
2021-01-09 basic basic examples switched to nextpnr
2021-01-22 commit schematic of pmod-lcd-0.96 & pmod-sdcard
2021-08-05 On branch master Your branch is up to date with 'origin/master'.
    Changes to be committed:
    new file: iCE40UP 5k Pinout.xlsx
    [iCE40UP 5k Pinout.xlsx]
2022-03-09 On branch master Your branch is up to date with 'origin/master'.
    modified: icesprog
    renamed: icesprog.arm -> icesprog.arm32
    new file: icesprog.arm64
    modified: src/Makefile
    modified: src/icesprog
    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
2023-04-07 On branch master Your branch is up to date with 'origin/master'.
    new file: pmod-camera-v1.0.pdf
    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
2023-09-02 fix spi flash master bug and pass the test
    [spi_master.v, top.v]
2025-07-13 added new flash(0xEF4016) device info
2025-09-01 1. add pmod-usbhost-v1.0.pdf 2. rename the schematic to achieve a uniform format On branch master Your branch is up to date with 'origin/master'.
    renamed: pmod_audio-v1.1.pdf -> pmod-audio-v1.1.pdf
    renamed: pmod_audio-v1.2.pdf -> pmod-audio-v1.2.pdf
    renamed: pmod_ethernet_v1.0.pdf -> pmod-ethernet-v1.0.pdf
    renamed: pmod_hdmi-v1.1.pdf -> pmod-hdmi-v1.1.pdf
    renamed: pmod_lcd-0.96-v1.0.pdf -> pmod-lcd-0.96-v1.0.pdf
    renamed: pmod_led-v1.1.pdf -> pmod-led-v1.1.pdf
    renamed: pmod_microphone-v1.0.pdf -> pmod-microphone-v1.0.pdf
    renamed: pmod_rgblcd-v1.3.pdf -> pmod-rgblcd-v1.3.pdf
    renamed: pmod_sdcard-v1.0.pdf -> pmod-sdcard-v1.0.pdf
    r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
2026-07-31 On branch master Your branch is up to date with 'origin/master'.
    deleted: schematic/iCESugar-v1.4.pdf
    deleted: schematic/pmod-audio-v1.1.pdf
    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
